sankao/robothector/docs/diagrams/pi-pinout.tex

\documentclass[border=10pt]{standalone}
\usepackage{tikz}
\usepackage{xcolor}
\usetikzlibrary{arrows.meta,positioning,calc,fit,backgrounds}

% --- wire colors (matching real Dupont colors) ---
\definecolor{wireRed}{RGB}{220,40,40}
\definecolor{wireOrange}{RGB}{240,140,0}
\definecolor{wireYellow}{RGB}{220,190,0}
\definecolor{wireGreen}{RGB}{50,160,60}
\definecolor{wireBlue}{RGB}{40,90,210}
\definecolor{wirePurple}{RGB}{140,50,180}
\definecolor{wireBrown}{RGB}{120,75,40}
\definecolor{wireWhite}{RGB}{220,220,220}
\definecolor{wireGray}{RGB}{130,130,130}
\definecolor{wireBlack}{RGB}{30,30,30}

\begin{document}
\begin{tikzpicture}[
    font=\sffamily,
    pin/.style={draw, thick, circle, minimum size=11mm, inner sep=0pt, fill=white,
                font=\sffamily\normalsize\bfseries},
    pinUsed/.style={pin, fill=cyan!30},
    pinPlanned/.style={pin, fill=orange!40},
    pinPower/.style={pin, fill=red!25},
    pinGnd/.style={pin, fill=black!70, text=white},
    pinFree/.style={pin, fill=white},
    pinConflict/.style={pin, fill=red!50, draw=red!75!black, line width=0.6mm},
    fnL/.style={anchor=east, font=\sffamily\small},
    fnR/.style={anchor=west, font=\sffamily\small},
    callout/.style={anchor=west, font=\sffamily\footnotesize, inner sep=2pt},
  ]

  %================================================================
  % 40-pin header — two columns, 20 rows, BIG enough to read
  %================================================================
  \def\rowstep{10mm}
  \def\colgap{18mm}

  % Pin definitions: row, leftStyle, leftFn, leftPinNum, rightStyle, rightFn, rightPinNum
  \foreach \r/\lstyle/\lfn/\lpin/\rstyle/\rfn/\rpin in {%
     1/pinPower/3.3V/1     /pinPower/5V/2,
     2/pinFree/GPIO 2 (SDA)/3 /pinPower/5V/4,
     3/pinFree/GPIO 3 (SCL)/5 /pinGnd/GND/6,
     4/pinFree/GPIO 4/7   /pinFree/GPIO 14 (TX)/8,
     5/pinGnd/GND/9       /pinFree/GPIO 15 (RX)/10,
     6/pinFree/GPIO 17/11 /pinPlanned/GPIO 18/12,
     7/pinFree/GPIO 27/13 /pinGnd/GND/14,
     8/pinFree/GPIO 22/15 /pinFree/GPIO 23/16,
     9/pinPower/3.3V/17   /pinFree/GPIO 24/18,
    10/pinFree/GPIO 10/19 /pinGnd/GND/20,
    11/pinFree/GPIO 9/21  /pinFree/GPIO 25/22,
    12/pinFree/GPIO 11/23 /pinFree/GPIO 8/24,
    13/pinGnd/GND/25      /pinFree/GPIO 7/26,
    14/pinFree/GPIO 0/27  /pinFree/GPIO 1/28,
    15/pinFree/GPIO 5/29  /pinGnd/GND/30,
    16/pinUsed/GPIO 6/31  /pinFree/GPIO 12/32,
    17/pinUsed/GPIO 13/33 /pinGnd/GND/34,
    18/pinConflict/GPIO 19/35 /pinFree/GPIO 16/36,
    19/pinUsed/GPIO 26/37 /pinPlanned/GPIO 20/38,
    20/pinGnd/GND/39      /pinPlanned/GPIO 21/40%
  }{%
     \node[\lstyle] (Lp\r) at (0, -\r*\rowstep) {\lpin};
     \node[fnL] at ([xshift=-6mm]Lp\r.west) {\lfn};
     \node[\rstyle] (Rp\r) at (\colgap, -\r*\rowstep) {\rpin};
     \node[fnR] at ([xshift=6mm]Rp\r.east) {\rfn};
  }

  % header outline — frame tight to pins, labels stay outside it
  \node[draw=green!50!black, semithick, rounded corners=1pt, fit=(Lp1)(Rp20),
        inner sep=2mm, fill=green!3, on background layer] (header) {};

  \node[font=\sffamily\bfseries\large, above=3mm of header.north]
        {Raspberry Pi 40-pin GPIO header (top-down view)};

  %================================================================
  % CALLOUTS — wire colour for each used / planned pin
  % Place them with breathing room
  %================================================================
  \def\leftPad{38mm}
  \def\rightPad{38mm}

  % --- LEFT column callouts ---
  % pin 1 — 3V3 → mic VDD
  \node[callout, anchor=east] at ([xshift=-\leftPad]Lp1.west)
        (cVDD) {to \textbf{INMP441 VDD} \quad
                \textcolor{wireRed}{\rule{6mm}{3mm}} \textbf{red}};
  \draw[-{Stealth[length=2mm]}, thick, gray] (cVDD.east) -- (Lp1.west);

  % pin 31 GPIO6 IN4
  \node[callout, anchor=east] at ([xshift=-\leftPad]Lp16.west)
        (cIN4) {\textbf{IN4 motor} \quad
                \textcolor{wireGray}{\rule{6mm}{3mm}} \textbf{gray}};
  \draw[-{Stealth[length=2mm]}, thick, gray] (cIN4.east) -- (Lp16.west);

  % pin 33 GPIO13 IN3
  \node[callout, anchor=east] at ([xshift=-\leftPad]Lp17.west)
        (cIN3) {\textbf{IN3 motor} \quad
                \fcolorbox{black!40}{wireWhite}{\rule{6mm}{3mm}} \textbf{white}};
  \draw[-{Stealth[length=2mm]}, thick, gray] (cIN3.east) -- (Lp17.west);

  % pin 35 GPIO19 — IN2 now / LRCLK planned (CONFLICT)
  \node[callout, anchor=east, draw=red!60, dashed, rounded corners,
        fill=red!5, inner sep=4pt, align=left]
        at ([xshift=-\leftPad]Lp18.west)
        (cIN2) {\textbf{IN2 motor} {\footnotesize(now)} \,/\,
                \textbf{I2S LRCLK} {\footnotesize(planned)}\\[1pt]
                \textcolor{wireBlack}{\rule{6mm}{3mm}} \textbf{black} (motor) $\rightarrow$
                \textcolor{wireGreen}{\rule{6mm}{3mm}} \textbf{green} (after rewire)};
  \draw[-{Stealth[length=2mm]}, thick, red!75!black]
        (cIN2.east) -- (Lp18.west);

  % pin 37 GPIO26 IN1
  \node[callout, anchor=east] at ([xshift=-\leftPad]Lp19.west)
        (cIN1) {\textbf{IN1 motor} \quad
                \textcolor{wireBrown}{\rule{6mm}{3mm}} \textbf{brown}};
  \draw[-{Stealth[length=2mm]}, thick, gray] (cIN1.east) -- (Lp19.west);

  % --- RIGHT column callouts ---
  % pin 2 — 5V → amp VIN
  \node[callout, anchor=west] at ([xshift=\rightPad]Rp1.east)
        (cVIN) {to \textbf{MAX98357A VIN} \quad
                \textcolor{wireOrange}{\rule{6mm}{3mm}} \textbf{orange}};
  \draw[-{Stealth[length=2mm]}, thick, gray] (Rp1.east) -- (cVIN.west);

  % pin 6 — GND → common rail
  \node[callout, anchor=west, fill=black!8, inner sep=3pt]
        at ([xshift=\rightPad]Rp3.east)
        (cGND) {\textbf{GND} (any pin) — common rail
                to L298N + mic + amp \quad
                \textcolor{wireBlack}{\rule{6mm}{3mm}} \textbf{black}};
  \draw[-{Stealth[length=2mm]}, thick, gray] (Rp3.east) -- (cGND.west);

  % pin 12 GPIO 18 — I2S BCLK shared
  \node[callout, anchor=west] at ([xshift=\rightPad]Rp6.east)
        (cBCLK) {\textbf{I2S BCLK} (shared mic + amp) \quad
                 \textcolor{wireYellow}{\rule{6mm}{3mm}} \textbf{yellow}};
  \draw[-{Stealth[length=2mm]}, thick, gray] (Rp6.east) -- (cBCLK.west);

  % pin 11 GPIO 17 — future IN2 home (after the rewire) — left column row 6
  \node[callout, anchor=east, draw=red!50, dashed, rounded corners,
        fill=red!5, inner sep=3pt]
        at ([xshift=-\leftPad,yshift=4mm]Lp6.west)
        (cIN2new) {\textbf{future IN2 motor} (after rewire) \quad
                   \textcolor{wireBlack}{\rule{6mm}{3mm}} \textbf{black}};
  \draw[-{Stealth[length=2mm]}, thick, red!75!black]
        (cIN2new.east) -- (Lp6.west);

  % pin 38 GPIO 20 — I2S SD (mic data → Pi)
  \node[callout, anchor=west] at ([xshift=\rightPad]Rp19.east)
        (cDIN) {\textbf{I2S SD} (mic data $\rightarrow$ Pi) \quad
                \textcolor{wireBlue}{\rule{6mm}{3mm}} \textbf{blue}};
  \draw[-{Stealth[length=2mm]}, thick, gray] (Rp19.east) -- (cDIN.west);

  % pin 40 GPIO 21 — I2S DIN (Pi → amp)
  \node[callout, anchor=west] at ([xshift=\rightPad]Rp20.east)
        (cDOUT) {\textbf{I2S DIN} (Pi $\rightarrow$ amp) \quad
                \textcolor{wirePurple}{\rule{6mm}{3mm}} \textbf{purple}};
  \draw[-{Stealth[length=2mm]}, thick, gray] (Rp20.east) -- (cDOUT.west);

  %================================================================
  % LEGEND for pin colour codes
  %================================================================
  \node[draw, rounded corners, fill=white, inner sep=6pt,
        anchor=north west, align=left, font=\sffamily\footnotesize]
        at ([xshift=-30mm,yshift=-15mm]header.south west)
        (legend) {%
    \textbf{Pin status (header colour)}\\[3pt]
    \tikz{\node[pinUsed,minimum size=5mm]{}; }\ \ currently used (motor IN1--IN4)\\[2pt]
    \tikz{\node[pinPlanned,minimum size=5mm]{}; }\ \ planned for Phase 4 audio\\[2pt]
    \tikz{\node[pinConflict,minimum size=5mm]{}; }\ \ conflict pin (must rewire IN2)\\[2pt]
    \tikz{\node[pinPower,minimum size=5mm]{}; }\ \ power rail (3.3V or 5V)\\[2pt]
    \tikz{\node[pinGnd,minimum size=5mm]{}; }\ \ ground\\[2pt]
    \tikz{\node[pinFree,minimum size=5mm]{}; }\ \ unused / available};

  %================================================================
  % WIRE COLOUR TABLE
  %================================================================
  \node[draw, rounded corners, fill=white, inner sep=6pt,
        anchor=north west, align=left, font=\sffamily\footnotesize,
        right=8mm of legend]
        (wires) {%
    \textbf{Recommended Dupont wire colours}\\[3pt]
    \begin{tabular}{@{}p{6mm}@{\ \ }l@{}}
      \textcolor{wireRed}{\rule{6mm}{3mm}}      & \textbf{red}    --- 3.3V (mic VDD)\\
      \textcolor{wireOrange}{\rule{6mm}{3mm}}   & \textbf{orange} --- 5V (amp VIN)\\
      \textcolor{wireBlack}{\rule{6mm}{3mm}}    & \textbf{black}  --- GND (any pin)\\
      \textcolor{wireYellow}{\rule{6mm}{3mm}}   & \textbf{yellow} --- I2S BCLK (shared)\\
      \textcolor{wireGreen}{\rule{6mm}{3mm}}    & \textbf{green}  --- I2S LRCLK (shared)\\
      \textcolor{wireBlue}{\rule{6mm}{3mm}}     & \textbf{blue}   --- I2S SD (mic data)\\
      \textcolor{wirePurple}{\rule{6mm}{3mm}}   & \textbf{purple} --- I2S DIN (amp data)\\[2pt]
      \textcolor{wireBrown}{\rule{6mm}{3mm}}    & \textbf{brown}  --- IN1 motor (Pi p37)\\
      \textcolor{wireBlack}{\rule{6mm}{3mm}}    & \textbf{black}  --- IN2 motor (Pi p35)$^*$\\
      \fcolorbox{black!40}{wireWhite}{\rule{6mm}{3mm}} & \textbf{white}  --- IN3 motor (Pi p33)\\
      \textcolor{wireGray}{\rule{6mm}{3mm}}     & \textbf{gray}   --- IN4 motor (Pi p31)\\
    \end{tabular}\\[3pt]
    \footnotesize $^*$IN2 wire moves to Pi pin 11 (GPIO 17)\\
    \footnotesize\quad when audio is added (frees GPIO 19 for LRCLK).\\
    \footnotesize\quad NOT GPIO 16: claimed by I2S overlay for amp SD\_MODE.};

  %================================================================
  % CONNECTION MAP
  %================================================================
  \node[draw, rounded corners, fill=white, inner sep=6pt,
        anchor=north west, align=left, font=\sffamily\footnotesize,
        right=8mm of wires]
        (conns) {%
    \textbf{Pi-pin $\rightarrow$ destination map}\\[3pt]
    \begin{tabular}{@{}p{12mm}@{\ \ }p{20mm}@{\ \ }l@{}}
      \textbf{Pi pin} & \textbf{Function}    & \textbf{Goes to}\\
      \hline
      1   & 3.3V         & INMP441 VDD\\
      2   & 5V           & MAX98357A VIN\\
      6, 9, 14, 20\dots & GND  & L298N + mic + amp + spk\\
      11  & GPIO 17$^*$  & L298N IN2 (after rewire)\\
      12  & GPIO 18      & mic SCK + amp BCLK\\
      31  & GPIO 6       & L298N IN4\\
      33  & GPIO 13      & L298N IN3\\
      35  & GPIO 19$^*$  & mic WS + amp LRC\\
      37  & GPIO 26      & L298N IN1\\
      38  & GPIO 20      & INMP441 SD\\
      40  & GPIO 21      & MAX98357A DIN\\
    \end{tabular}\\[3pt]
    \footnotesize $^*$ rewire: free GPIO 19 by moving IN2 to GPIO 17 (Pi pin 11) ---\\
    \footnotesize\quad GPIO 16 is unavailable (claimed by I2S overlay for amp SD\_MODE).};

  %================================================================
  % TITLE
  %================================================================
  \node[font=\sffamily\Large\bfseries, above=14mm of header.north, align=center]
        {robothector --- Raspberry Pi GPIO header \& wire-colour reference};

\end{tikzpicture}
\end{document}
