sankao/robothector/cad/preview/cabin/body/front.png

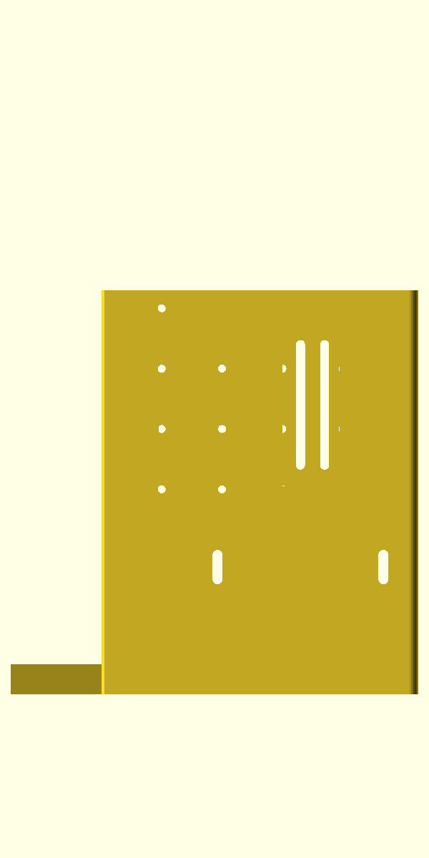
cad/preview/cabin/body/front.png
