sankao/robothector/cad/preview/cabin/body/iso.png

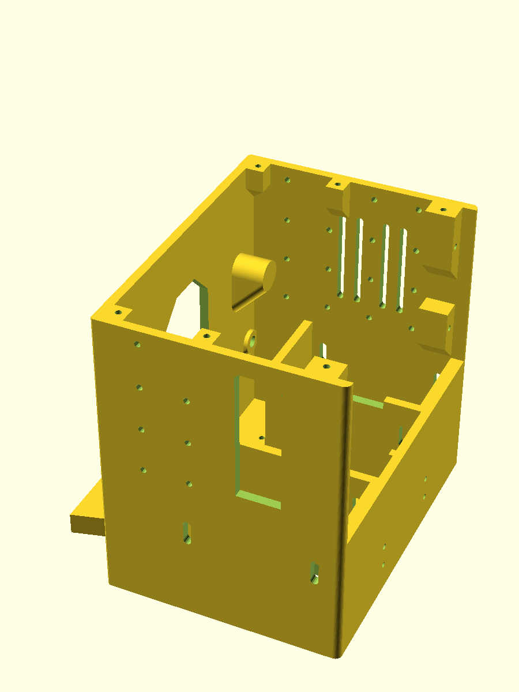
cad/preview/cabin/body/iso.png
