sankao/robothector/cad/preview/cabin/body/side.png

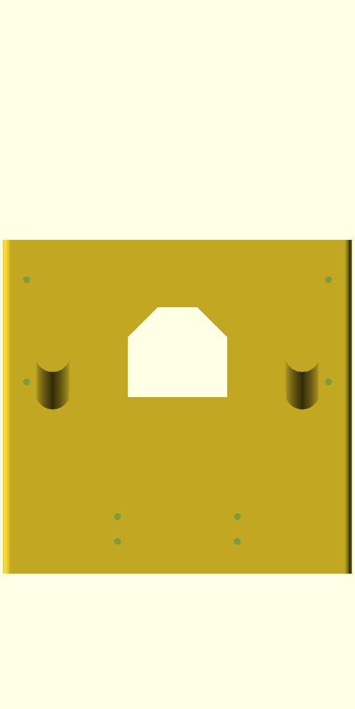
cad/preview/cabin/body/side.png
