sankao/robothector/cad/preview/cabin/body/top.png

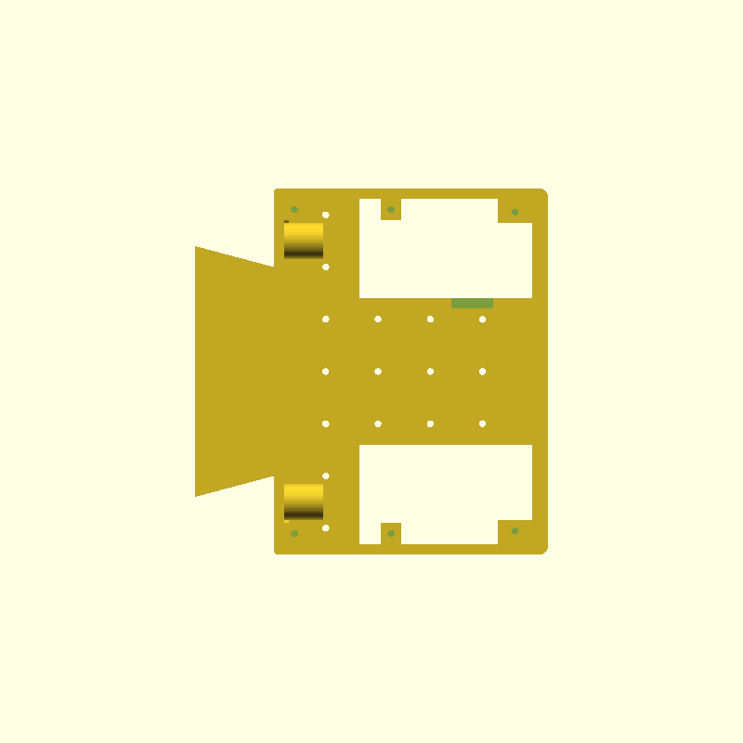
cad/preview/cabin/body/top.png
