sankao/robothector/cad/preview/cabin/bumper/front.png

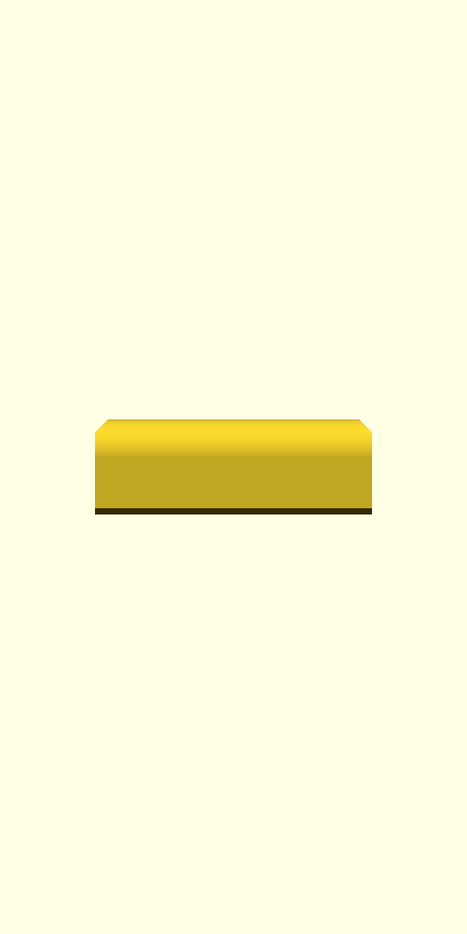
cad/preview/cabin/bumper/front.png
