sankao/robothector/cad/preview/cabin/bumper/iso.png

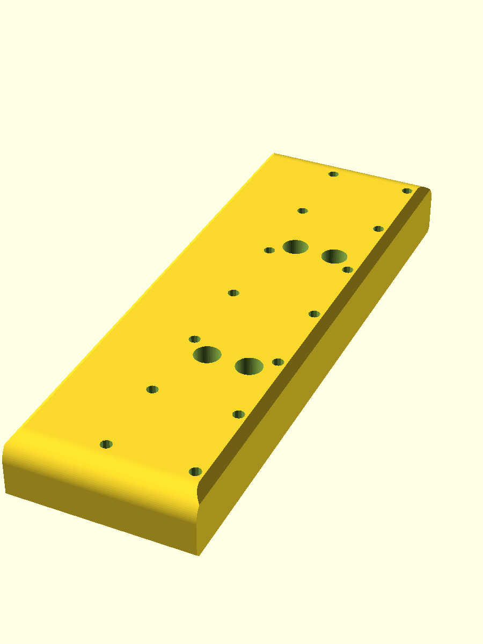
cad/preview/cabin/bumper/iso.png
