sankao/robothector/cad/preview/cabin/bumper/side.png

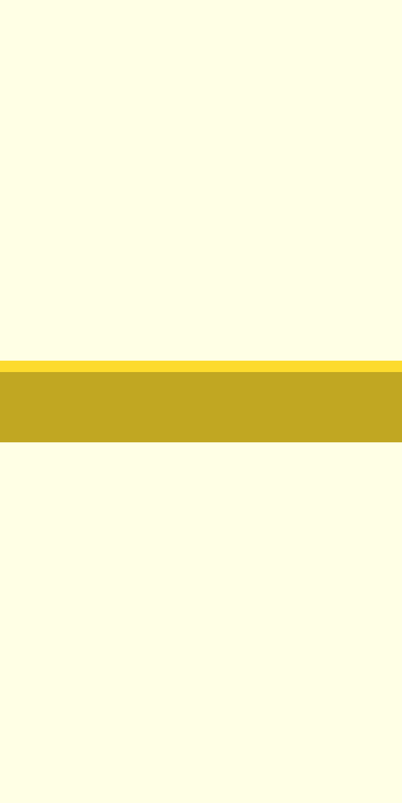
cad/preview/cabin/bumper/side.png
