sankao/robothector/cad/preview/cabin/bumper/top.png

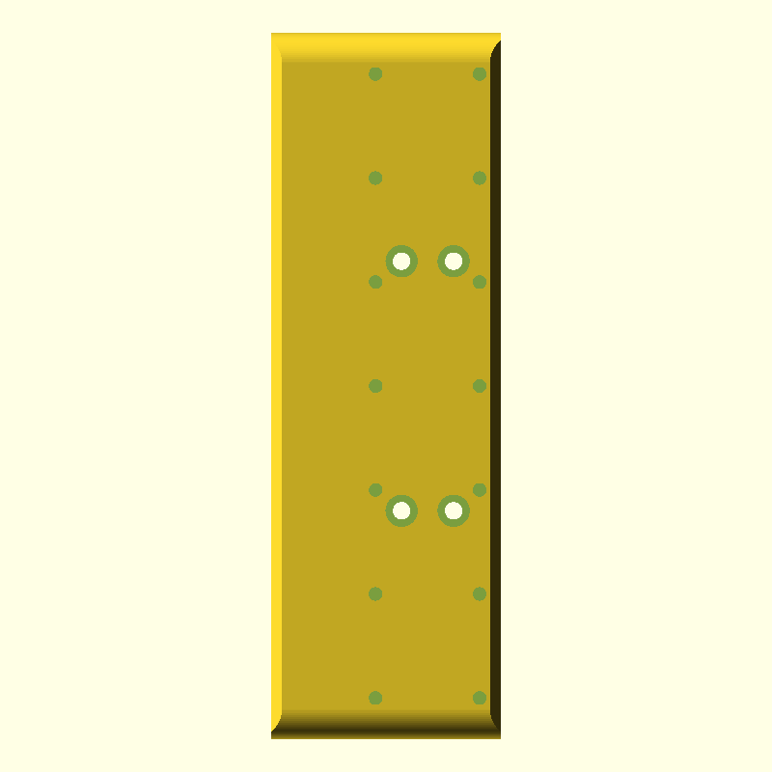
cad/preview/cabin/bumper/top.png
