sankao/robothector/cad/preview/cabin/camera_bracket/front.png

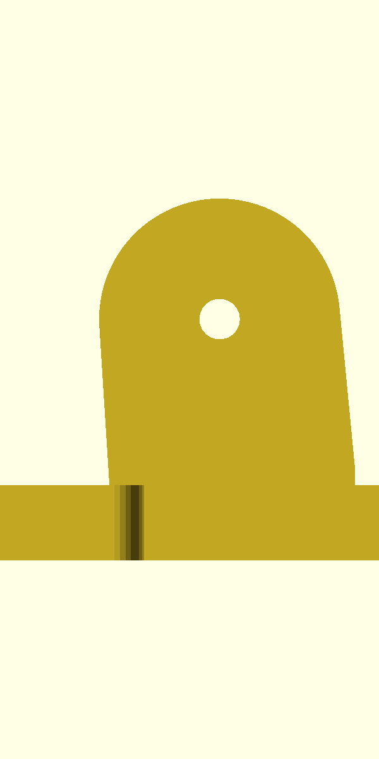
cad/preview/cabin/camera_bracket/front.png
