sankao/robothector/cad/preview/cabin/camera_bracket/iso.png

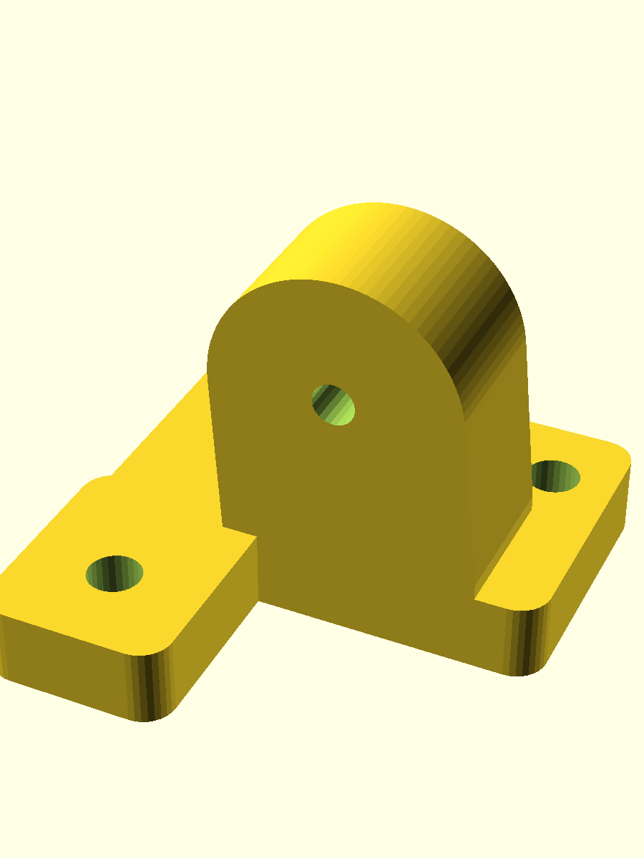
cad/preview/cabin/camera_bracket/iso.png
