sankao/robothector/cad/preview/cabin/camera_bracket/side.png

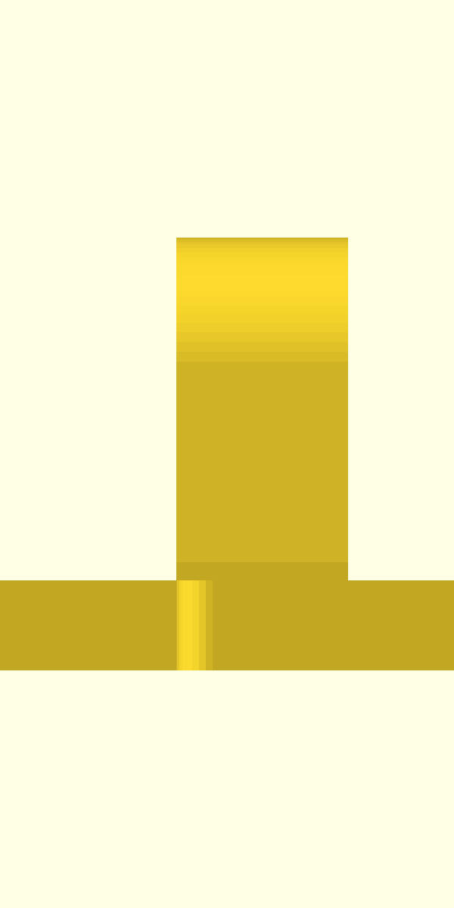
cad/preview/cabin/camera_bracket/side.png
