sankao/robothector/cad/preview/cabin/camera_bracket/top.png

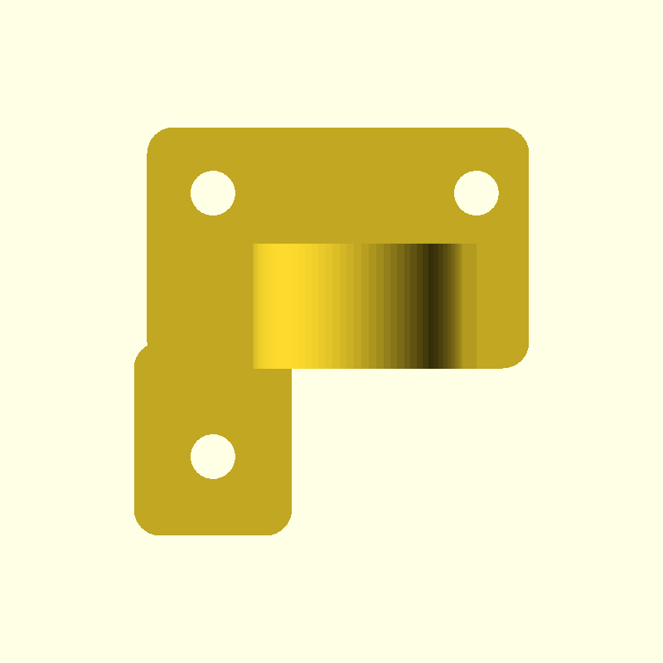
cad/preview/cabin/camera_bracket/top.png
