sankao/robothector/cad/preview/cabin/camera_clip/front.png

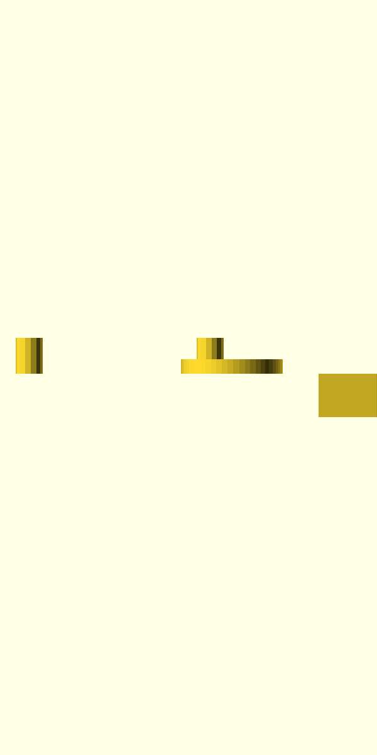
cad/preview/cabin/camera_clip/front.png
