sankao/robothector/cad/preview/cabin/camera_clip/iso.png

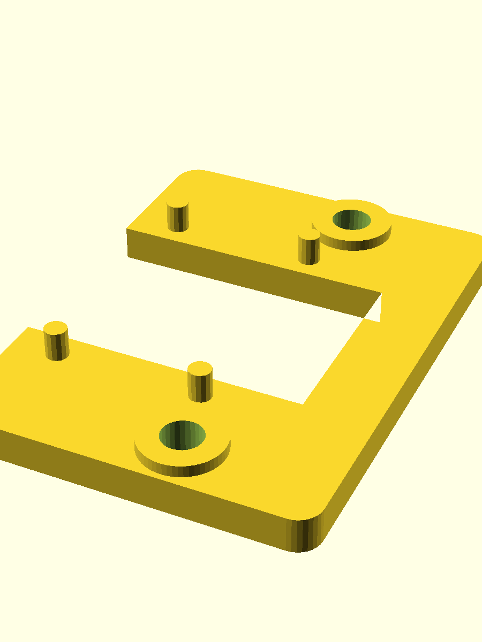
cad/preview/cabin/camera_clip/iso.png
