sankao/robothector/cad/preview/cabin/camera_clip/top.png

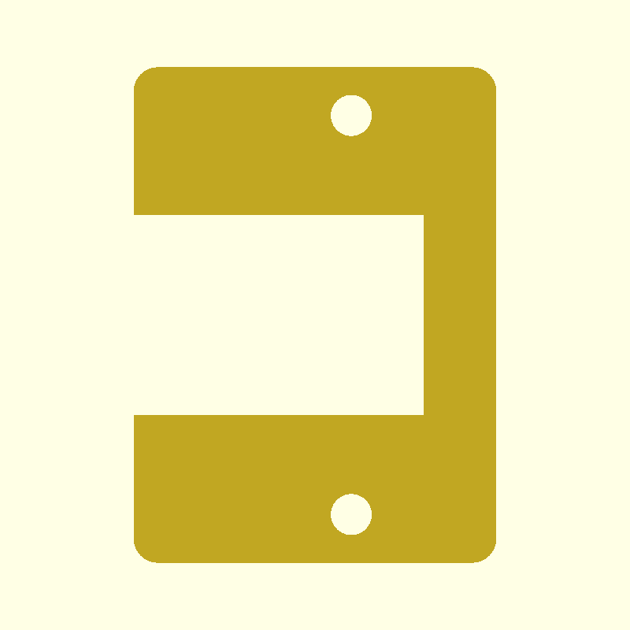
cad/preview/cabin/camera_clip/top.png
