sankao/robothector/cad/preview/cabin/camera_cradle/front.png

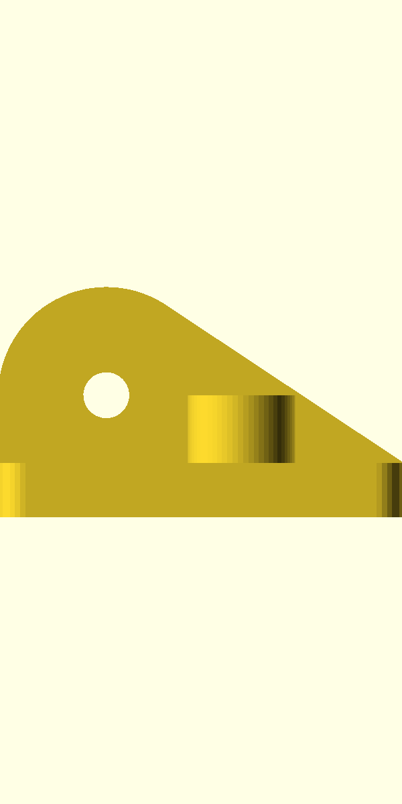
cad/preview/cabin/camera_cradle/front.png
