sankao/robothector/cad/preview/cabin/camera_cradle/iso.png

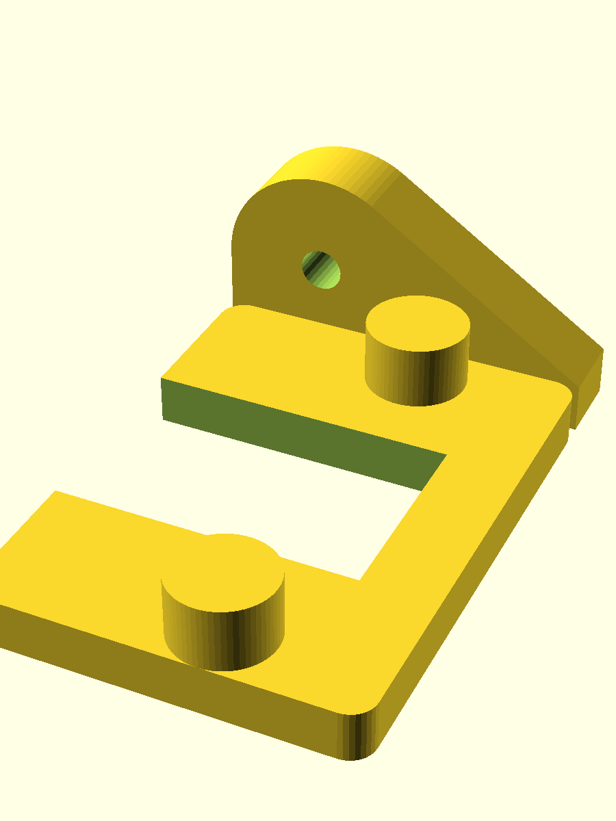
cad/preview/cabin/camera_cradle/iso.png
