sankao/robothector/cad/preview/cabin/camera_cradle/top.png

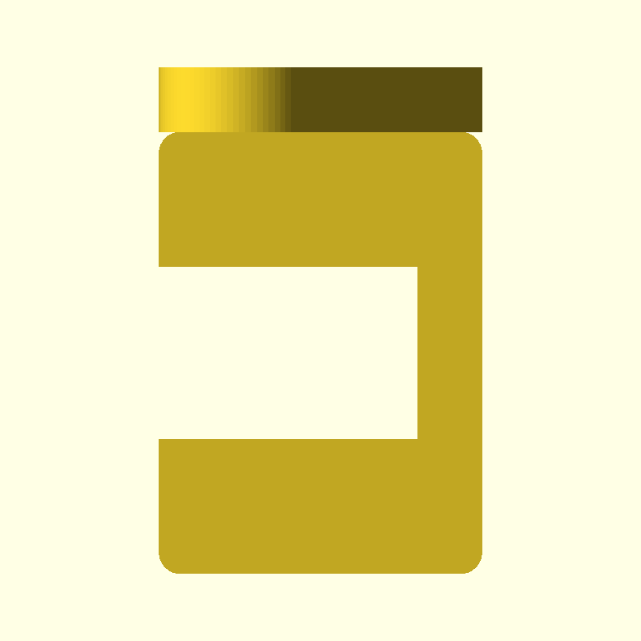
cad/preview/cabin/camera_cradle/top.png
