sankao/robothector/cad/preview/cabin/faceplate_v2/back.png

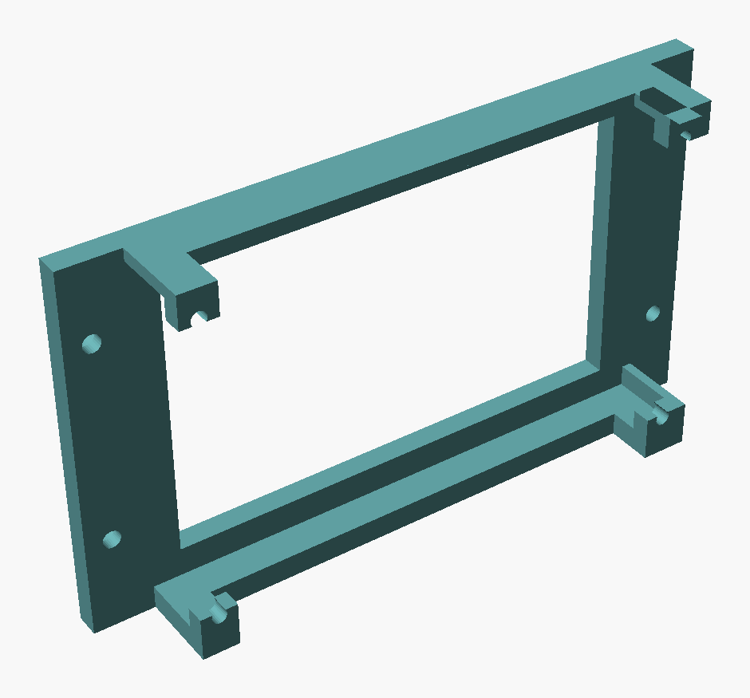
cad/preview/cabin/faceplate_v2/back.png
