sankao/robothector/cad/preview/cabin/faceplate_v2/with_screen.png

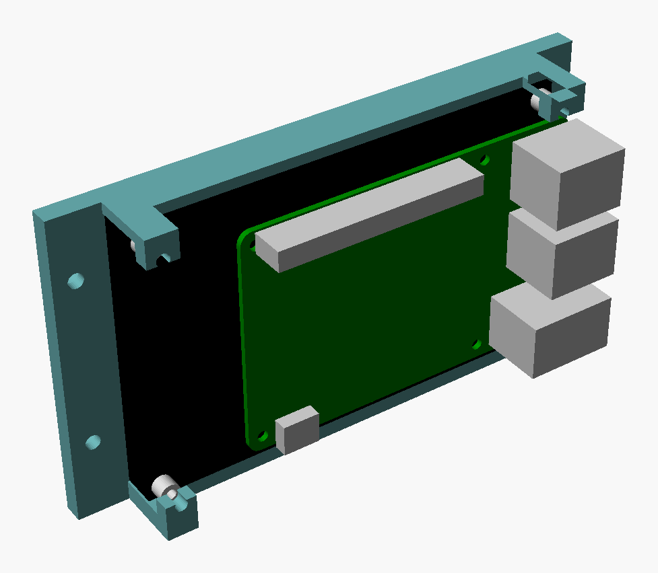
cad/preview/cabin/faceplate_v2/with_screen.png
