sankao/robothector/cad/preview/cabin/omni_cassette/front.png

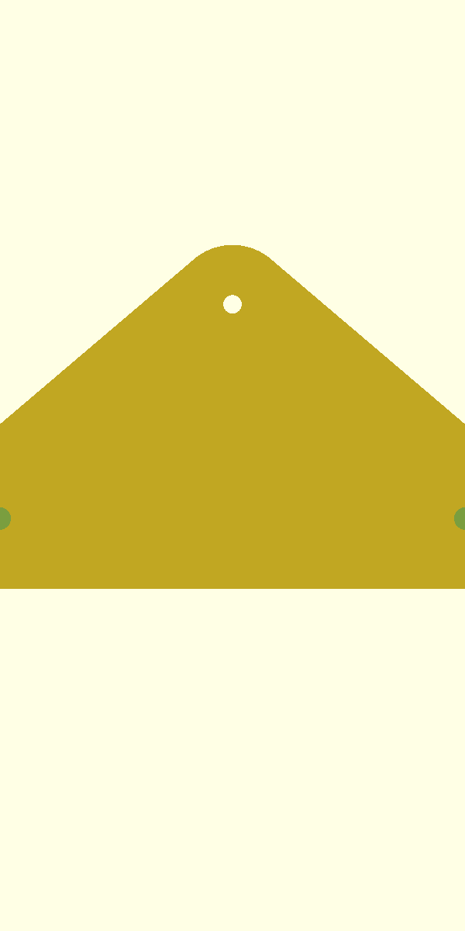
cad/preview/cabin/omni_cassette/front.png
