sankao/robothector/cad/preview/cabin/omni_cassette/iso.png

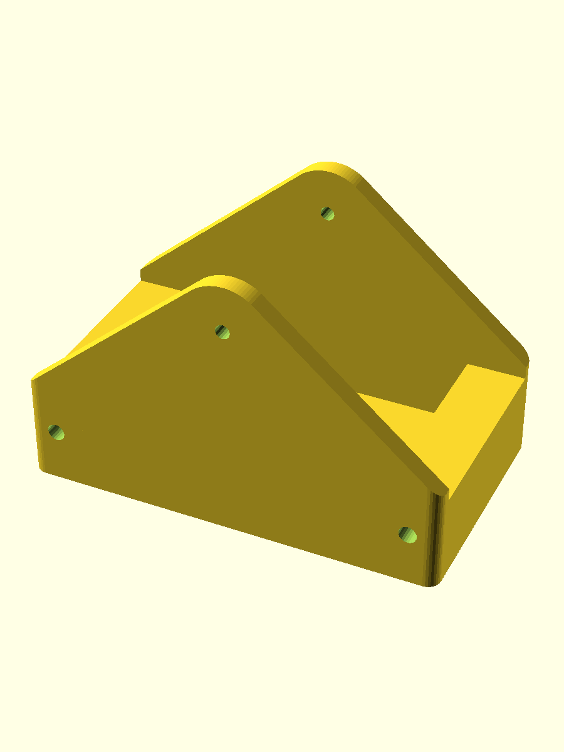
cad/preview/cabin/omni_cassette/iso.png
