sankao/robothector/cad/preview/cabin/omni_cassette/side.png

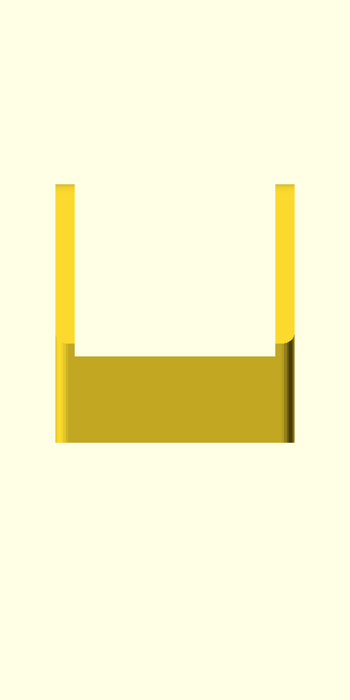
cad/preview/cabin/omni_cassette/side.png
