sankao/robothector/cad/preview/cabin/omni_cassette/top.png

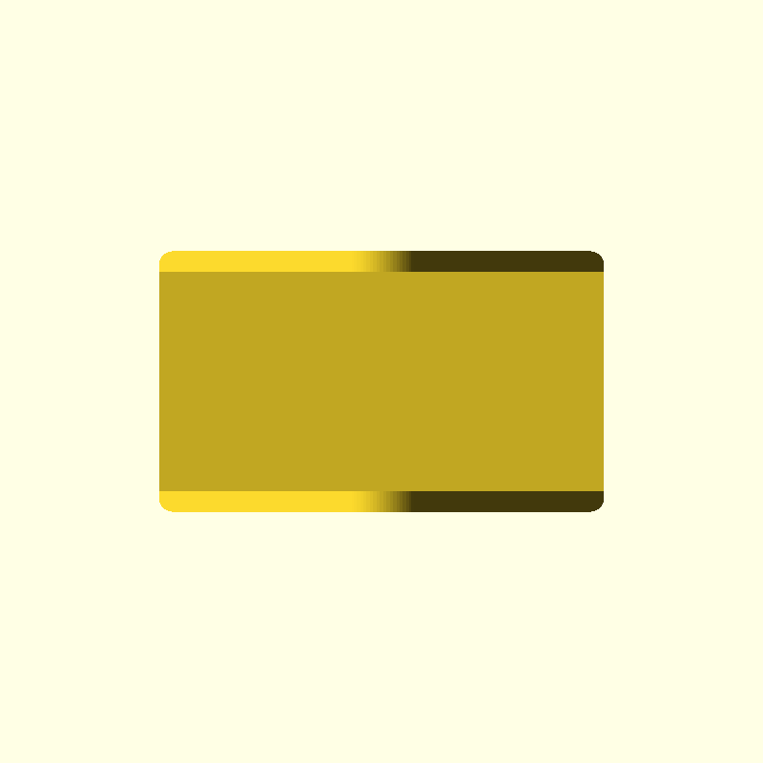
cad/preview/cabin/omni_cassette/top.png
