sankao/robothector/cad/preview/cabin/roof/iso.png

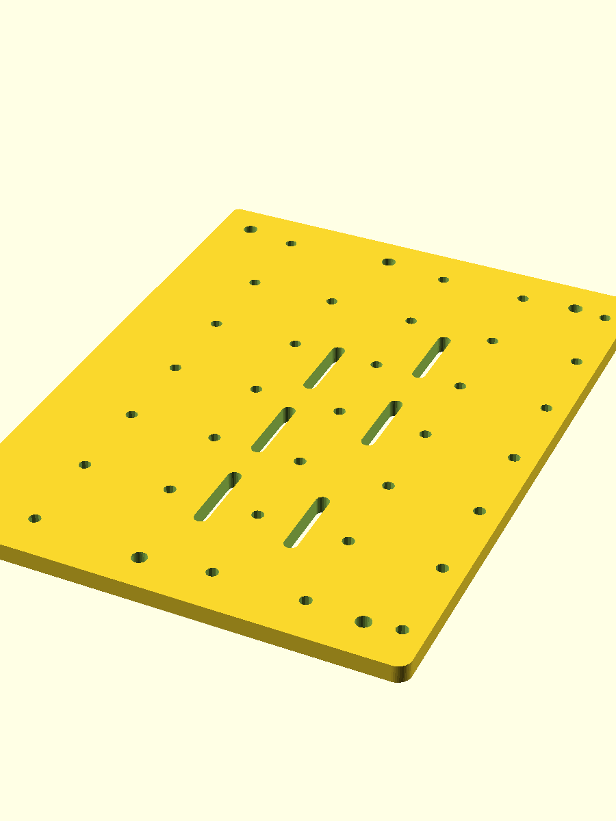
cad/preview/cabin/roof/iso.png
