sankao/robothector/cad/preview/cabin/roof/top.png

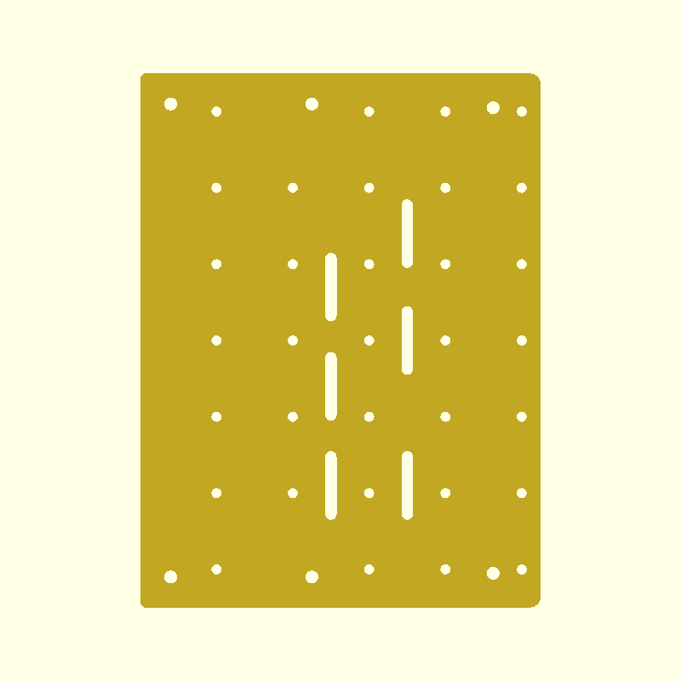
cad/preview/cabin/roof/top.png
