sankao/robothector/cad/preview/cabin/screen_mount/exploded_front.png

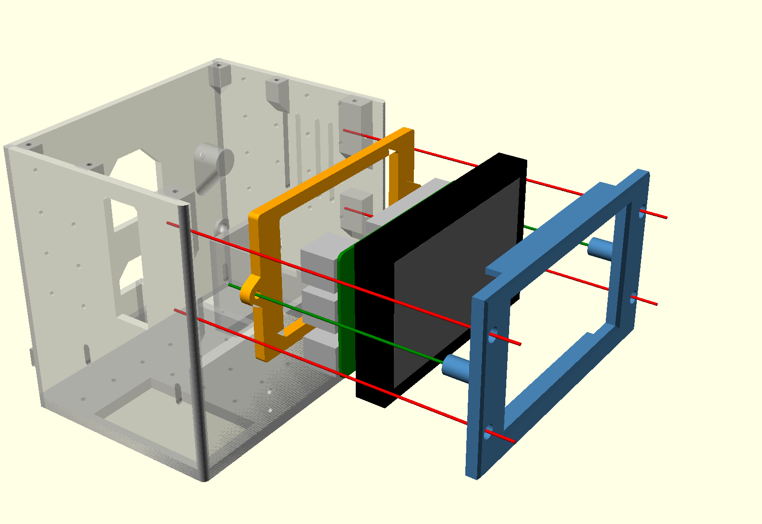
cad/preview/cabin/screen_mount/exploded_front.png
