sankao/robothector/cad/preview/cabin/screen_mount/exploded_rear.png

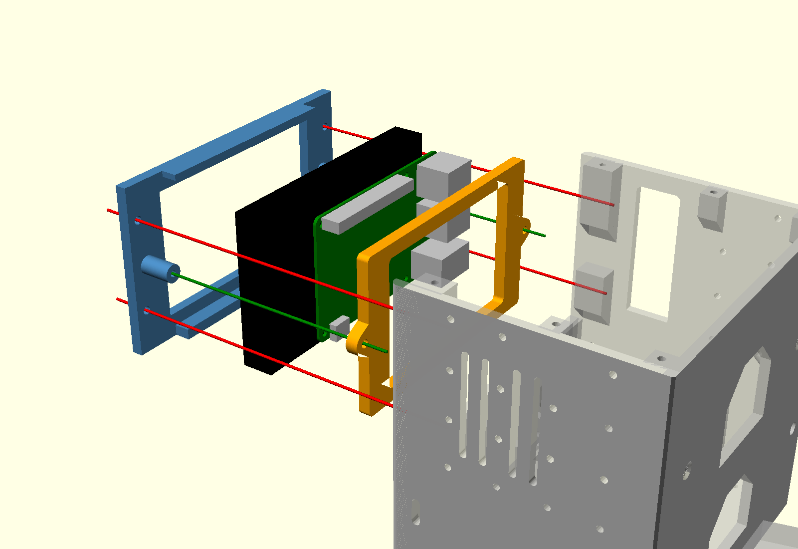
cad/preview/cabin/screen_mount/exploded_rear.png
