sankao/robothector/cad/preview/cabin/screen_retainer/iso.png

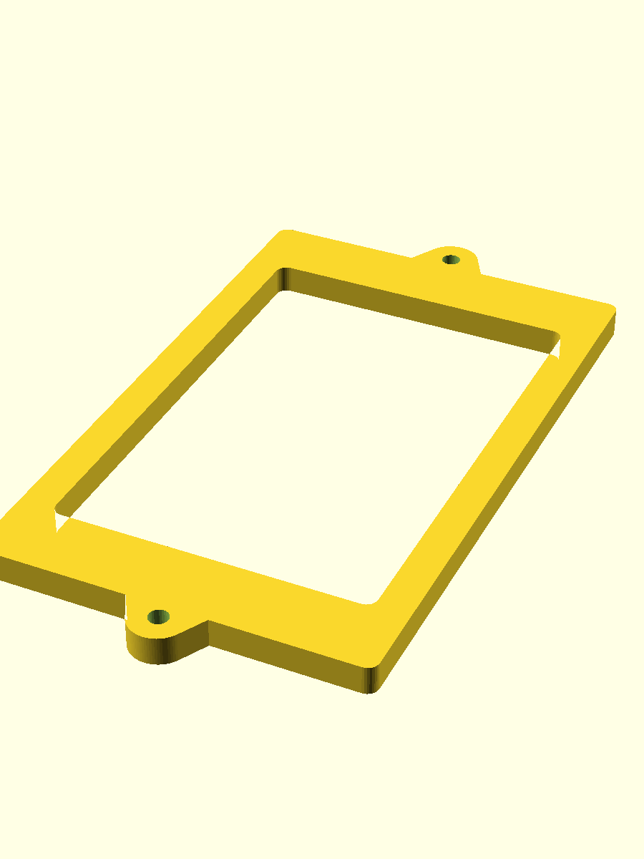
cad/preview/cabin/screen_retainer/iso.png
