sankao/robothector/cad/preview/cabin/screen_retainer/top.png

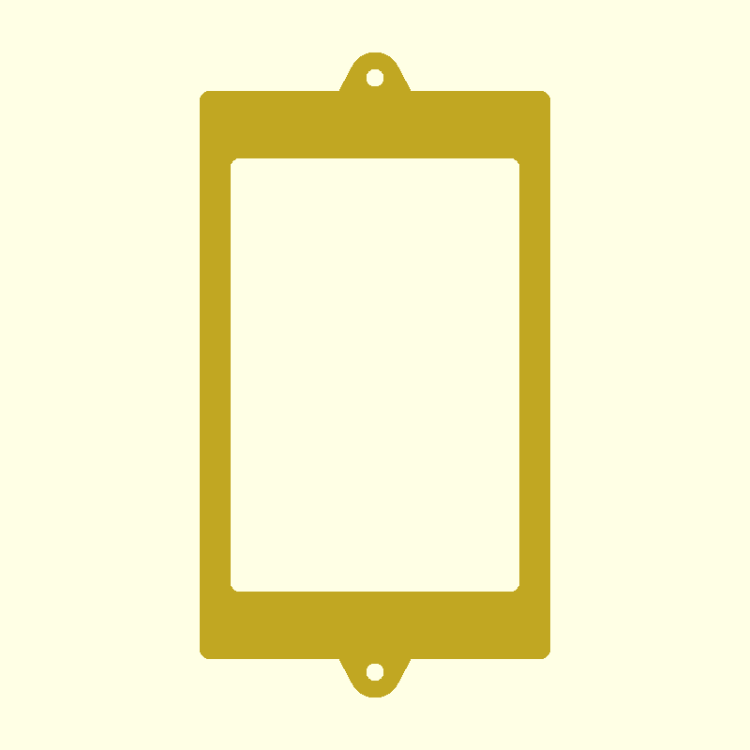
cad/preview/cabin/screen_retainer/top.png
