sankao/robothector/cad/preview/lower_carriage/clamp_motor_detail.png

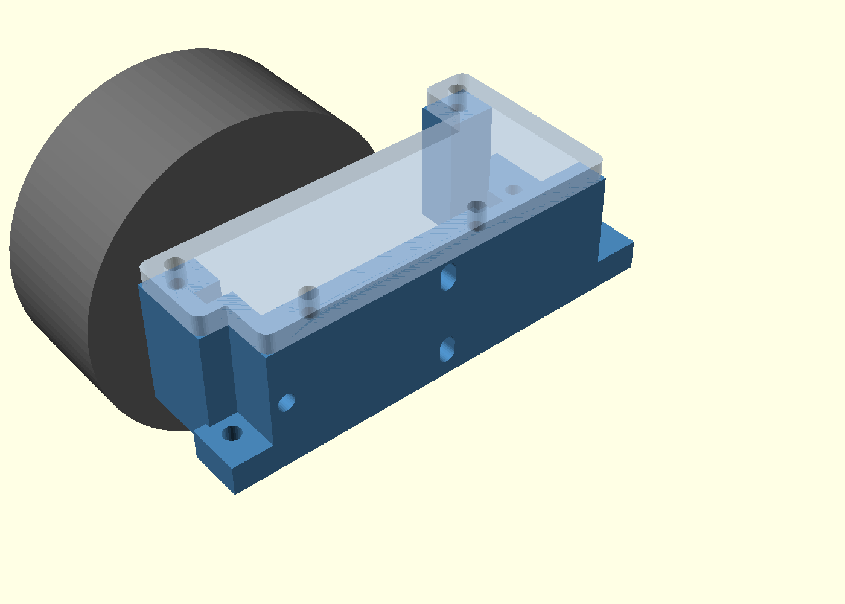
cad/preview/lower_carriage/clamp_motor_detail.png
