sankao/robothector/cad/preview/lower_carriage/frame_front.png

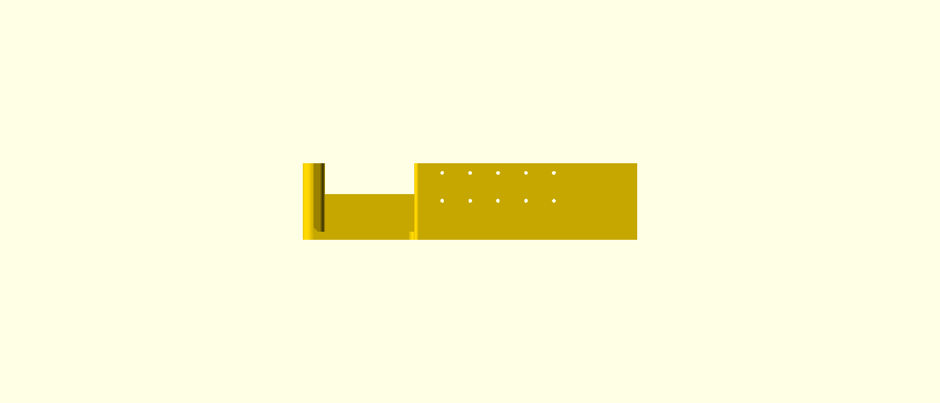
cad/preview/lower_carriage/frame_front.png
