sankao/robothector/cad/preview/lower_carriage/frame_iso.png

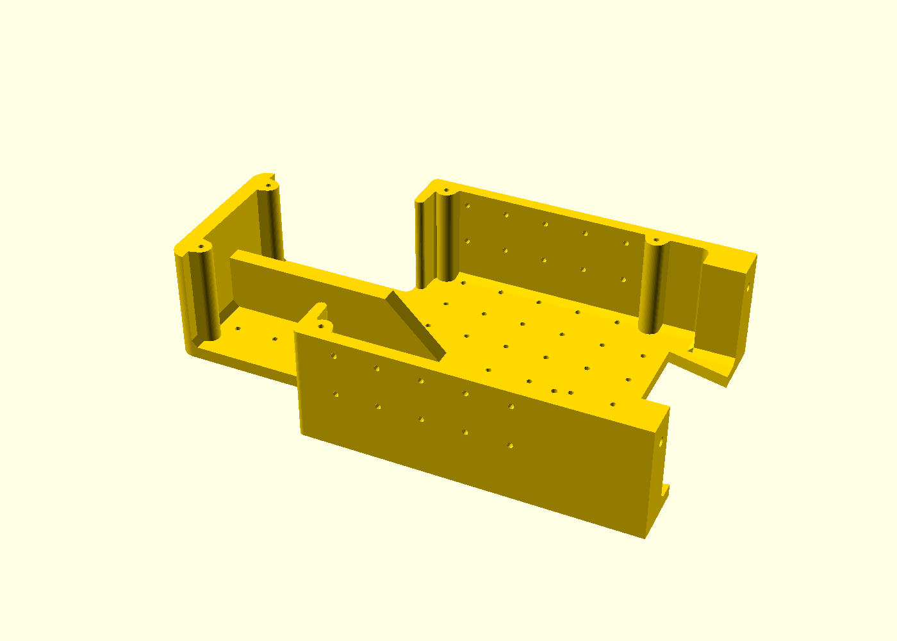
cad/preview/lower_carriage/frame_iso.png
