sankao/robothector/cad/preview/lower_carriage/frame_side.png

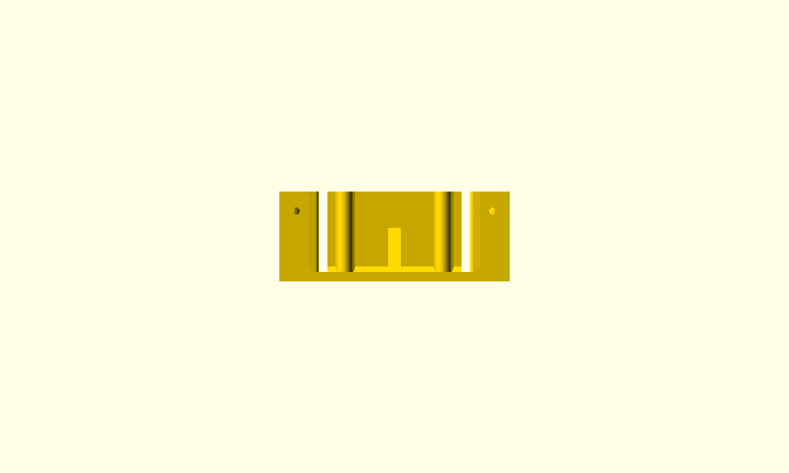
cad/preview/lower_carriage/frame_side.png
