sankao/robothector/cad/preview/lower_carriage/frame_top.png

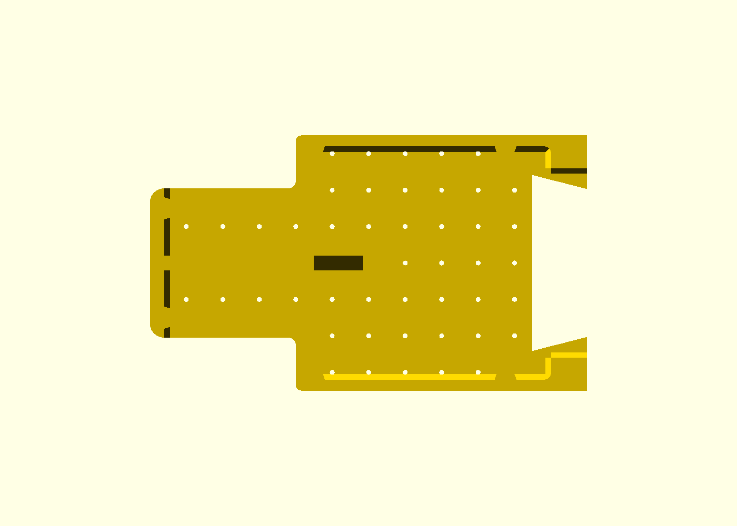
cad/preview/lower_carriage/frame_top.png
