sankao/robothector/cad/preview/lower_carriage/shoulder_detail.png

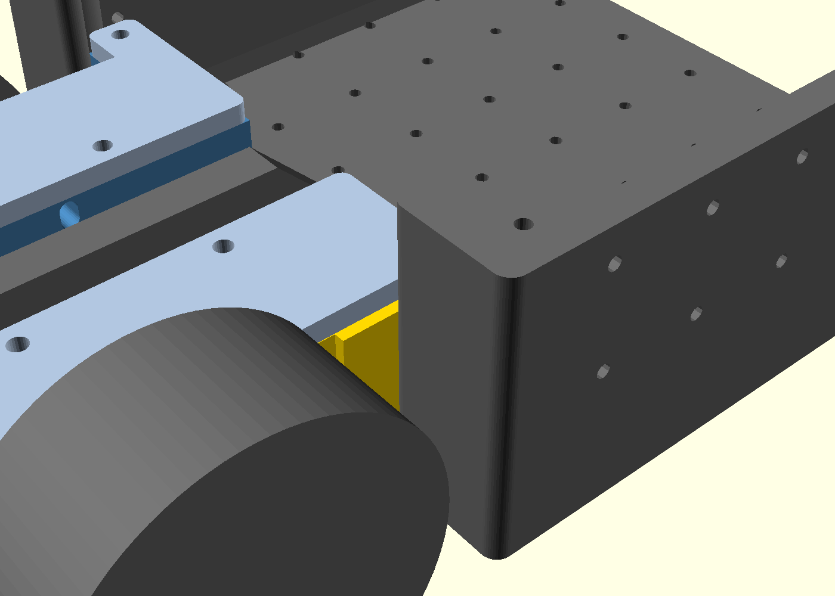
cad/preview/lower_carriage/shoulder_detail.png
