sankao/robothector/cad/preview/lower_carriage/tt_cap_iso.png

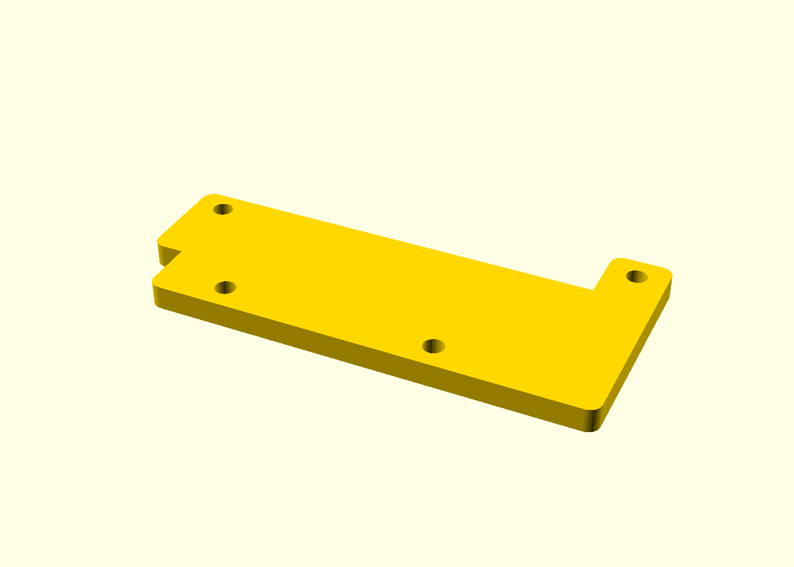
cad/preview/lower_carriage/tt_cap_iso.png
