sankao/robothector/cad/preview/lower_carriage/tt_clamp_iso.png

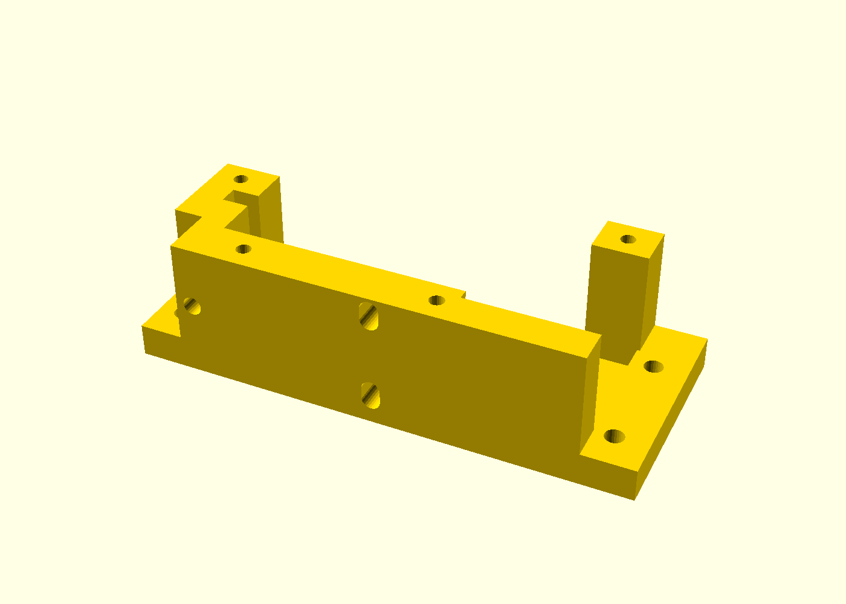
cad/preview/lower_carriage/tt_clamp_iso.png
