sankao/robothector/cad/preview/lower_carriage/tt_shaft_slot/clamp_with_motor.png

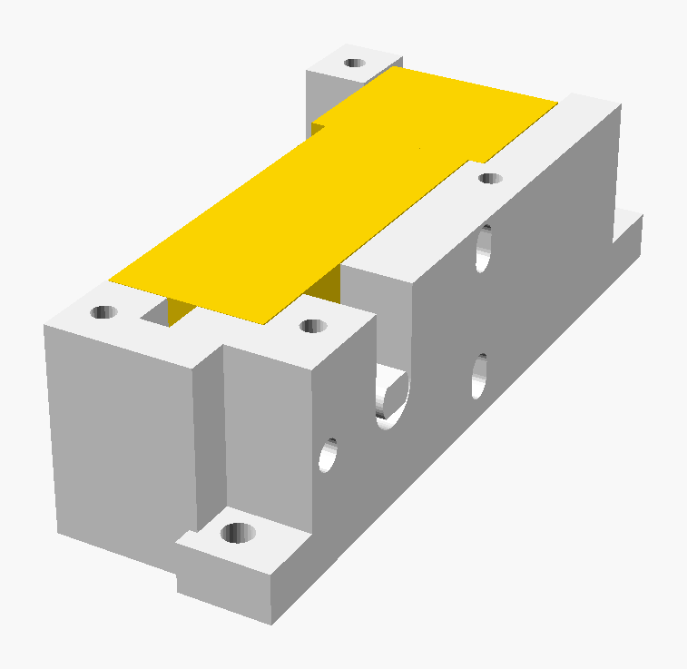
cad/preview/lower_carriage/tt_shaft_slot/clamp_with_motor.png
