sankao/robothector/cad/preview/manual/overview.png

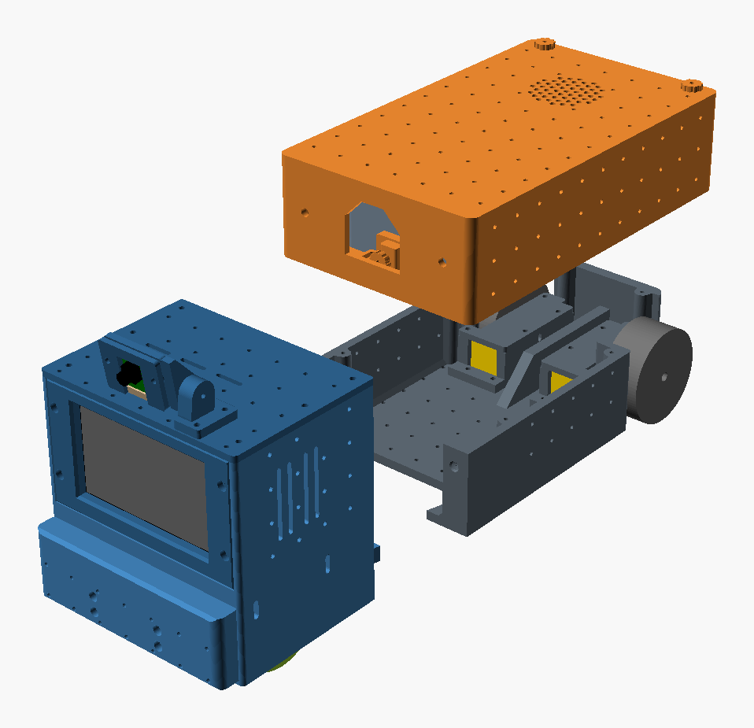
cad/preview/manual/overview.png
