sankao/robothector/cad/preview/rod_jig/base.png

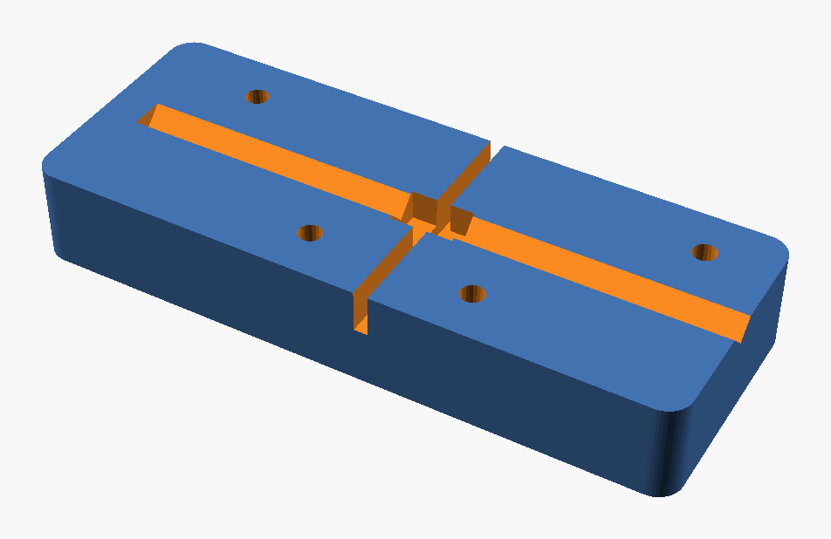
cad/preview/rod_jig/base.png
