sankao/robothector/cad/preview/upper_carriage/clamp_post/front.png

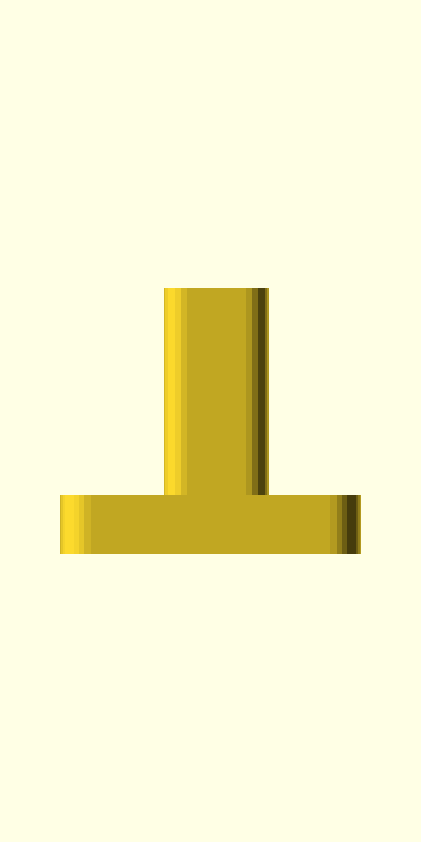
cad/preview/upper_carriage/clamp_post/front.png
