sankao/robothector/cad/preview/upper_carriage/clamp_post/iso.png

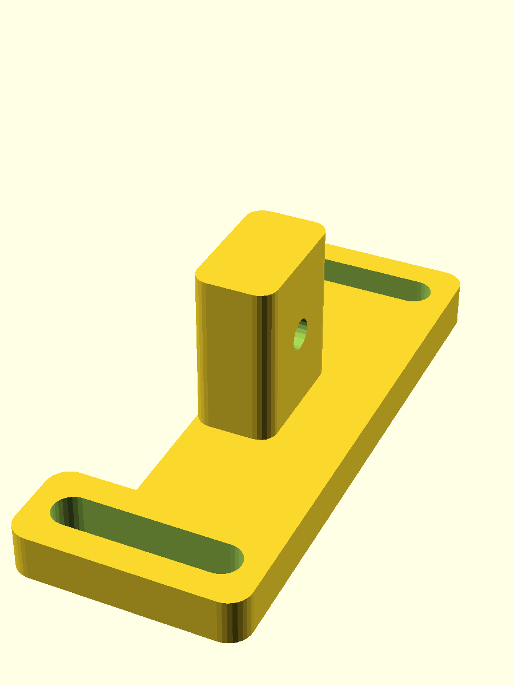
cad/preview/upper_carriage/clamp_post/iso.png
