sankao/robothector/cad/preview/upper_carriage/clamp_post/side.png

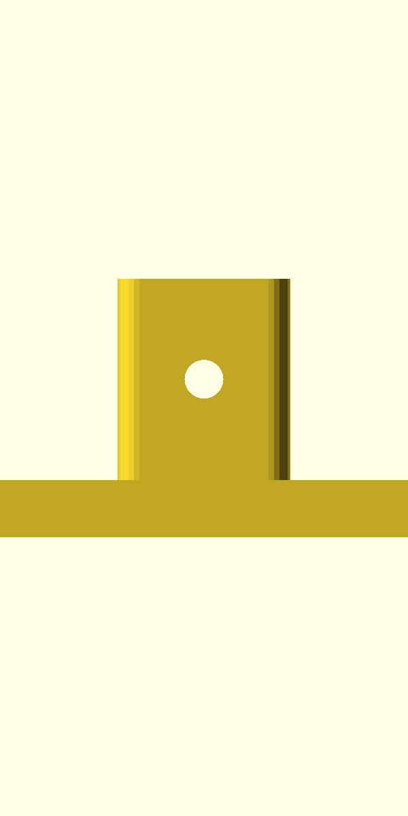
cad/preview/upper_carriage/clamp_post/side.png
