sankao/robothector/cad/preview/upper_carriage/clamp_post/top.png

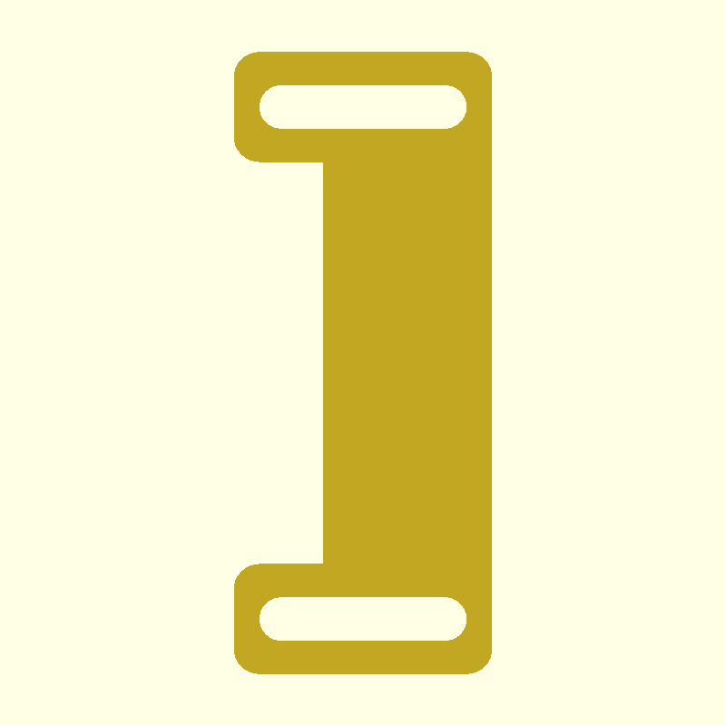
cad/preview/upper_carriage/clamp_post/top.png
