sankao/robothector/cad/preview/upper_carriage/knob/front.png

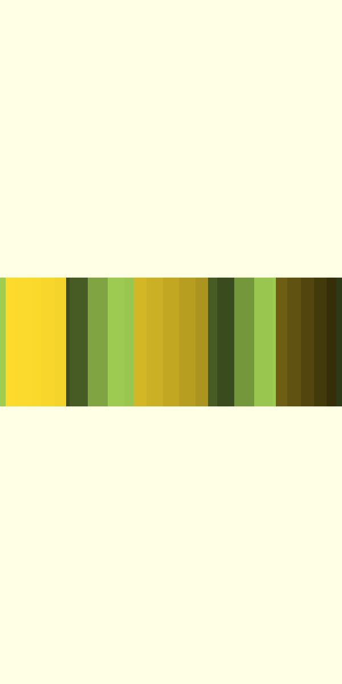
cad/preview/upper_carriage/knob/front.png
