sankao/robothector/cad/preview/upper_carriage/knob/iso.png

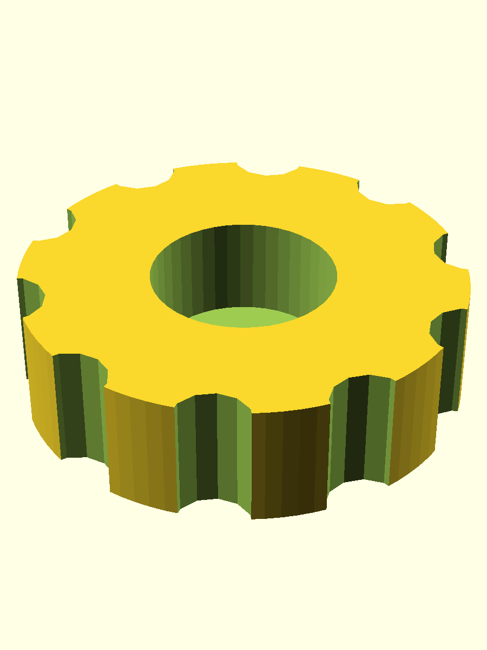
cad/preview/upper_carriage/knob/iso.png
