sankao/robothector/cad/preview/upper_carriage/knob/side.png

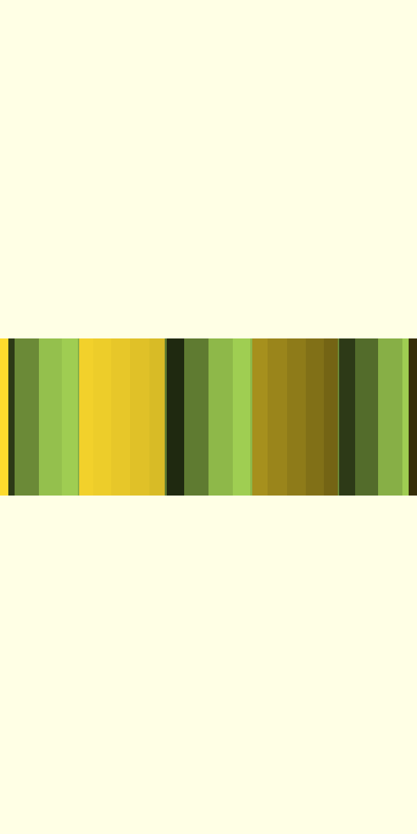
cad/preview/upper_carriage/knob/side.png
