sankao/robothector/cad/preview/upper_carriage/knob/top.png

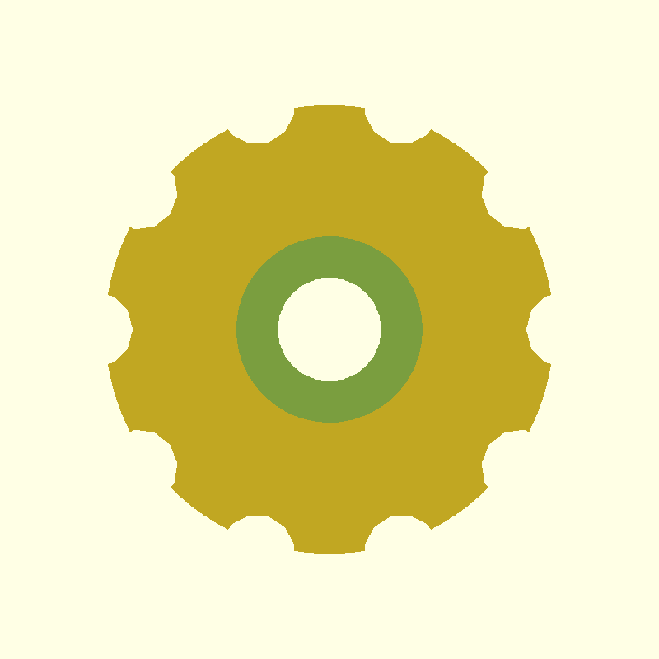
cad/preview/upper_carriage/knob/top.png
