sankao/robothector/cad/preview/upper_carriage/l298n_plate/iso.png

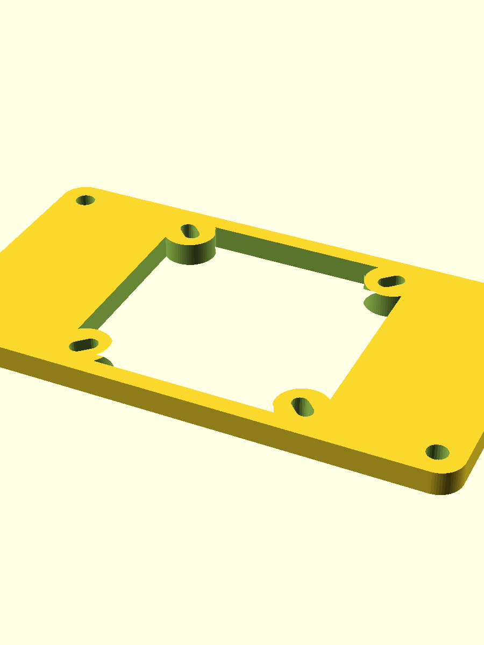
cad/preview/upper_carriage/l298n_plate/iso.png
