sankao/robothector/cad/preview/upper_carriage/l298n_plate/top.png

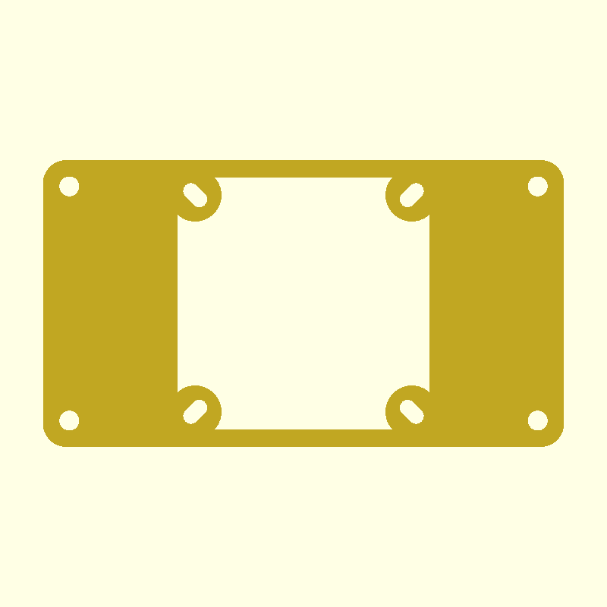
cad/preview/upper_carriage/l298n_plate/top.png
