sankao/robothector/cad/preview/upper_carriage/lid/iso.png

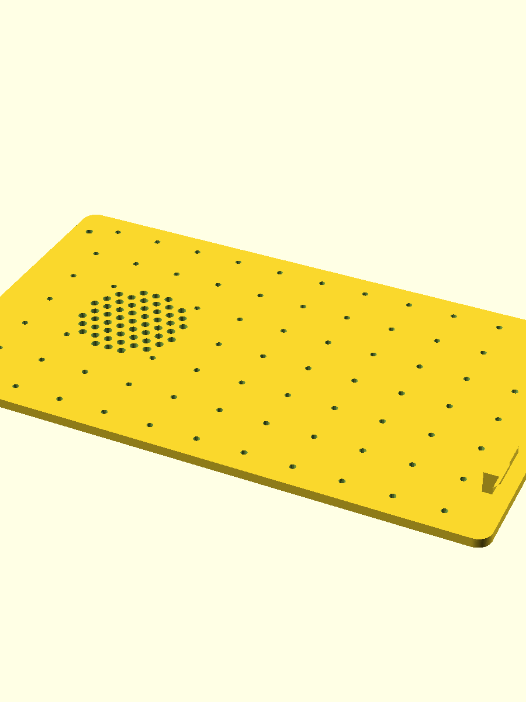
cad/preview/upper_carriage/lid/iso.png
