sankao/robothector/cad/preview/upper_carriage/lid/side.png

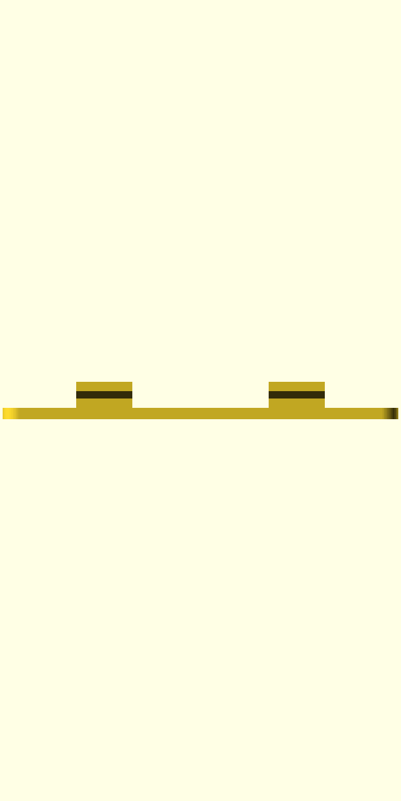
cad/preview/upper_carriage/lid/side.png
