sankao/robothector/cad/preview/upper_carriage/lid/top.png

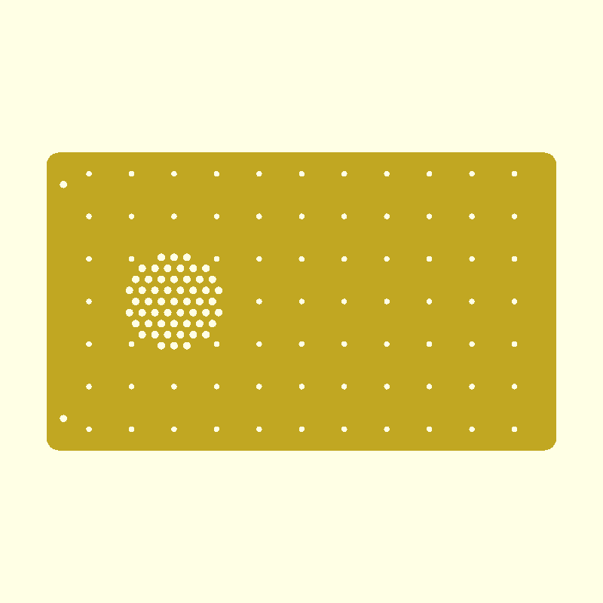
cad/preview/upper_carriage/lid/top.png
