sankao/robothector/cad/preview/upper_carriage/max_bank/iso.png

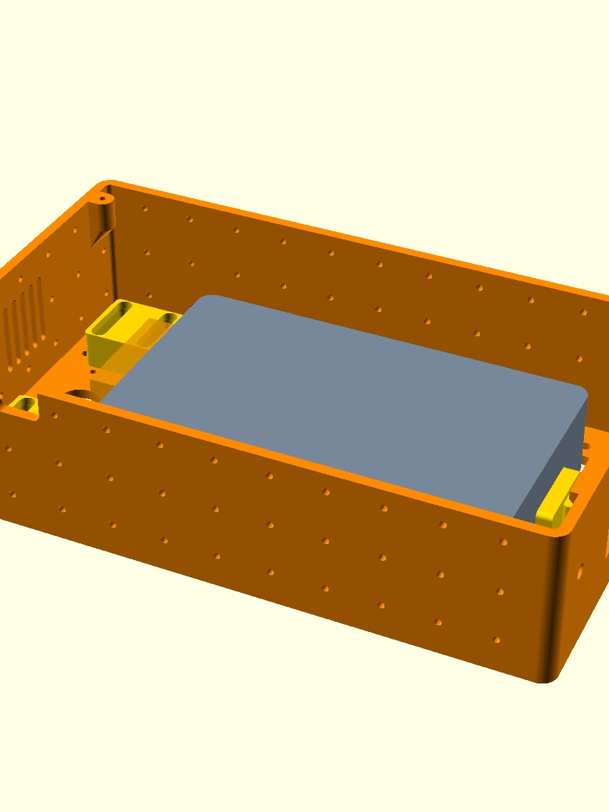
cad/preview/upper_carriage/max_bank/iso.png
