sankao/robothector/cad/preview/upper_carriage/max_bank/side.png

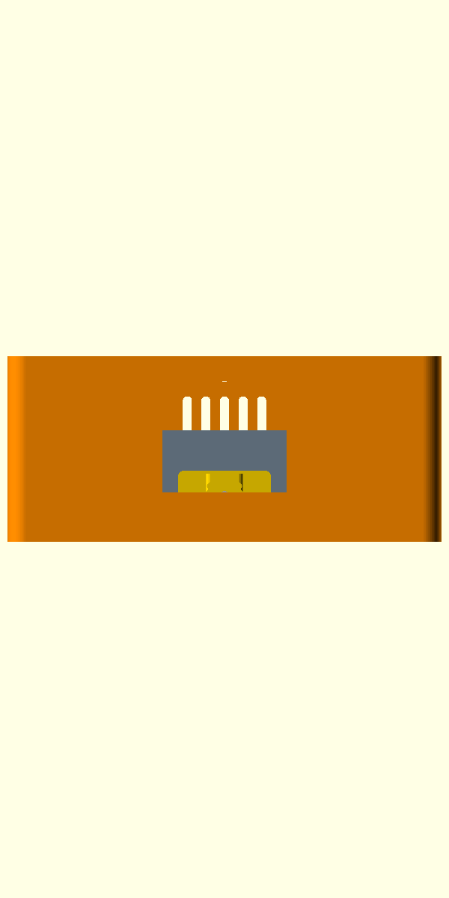
cad/preview/upper_carriage/max_bank/side.png
