sankao/robothector/cad/preview/upper_carriage/open/front.png

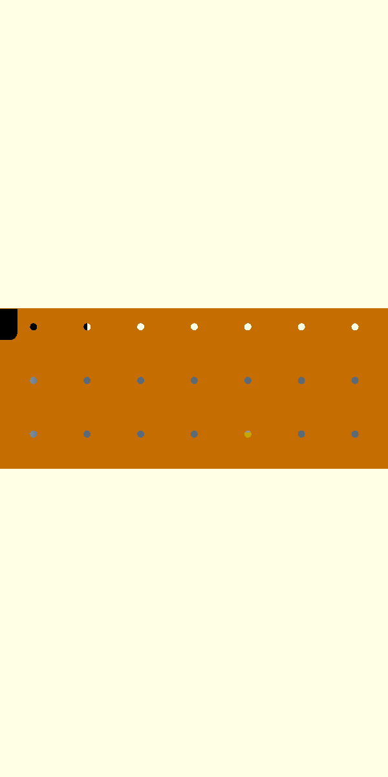
cad/preview/upper_carriage/open/front.png
