sankao/robothector/cad/preview/upper_carriage/open/iso_rear.png

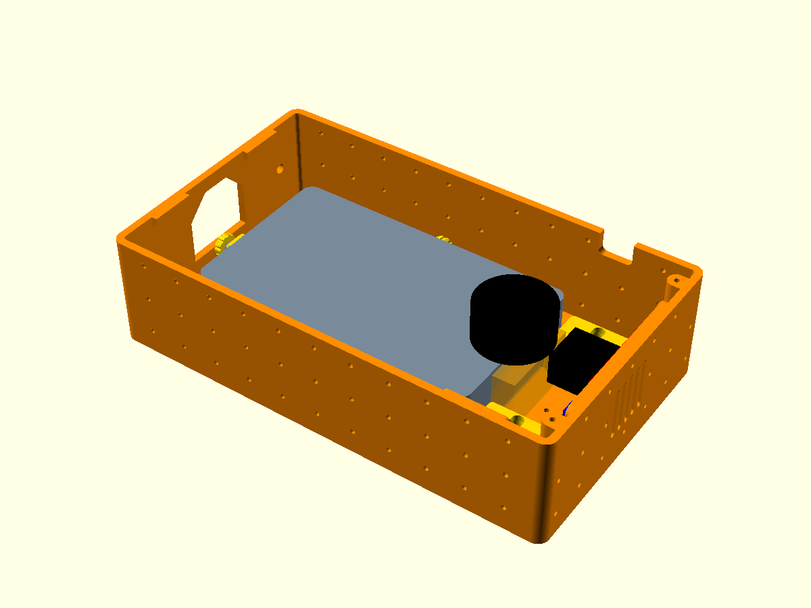
cad/preview/upper_carriage/open/iso_rear.png
