sankao/robothector/cad/preview/upper_carriage/open/side.png

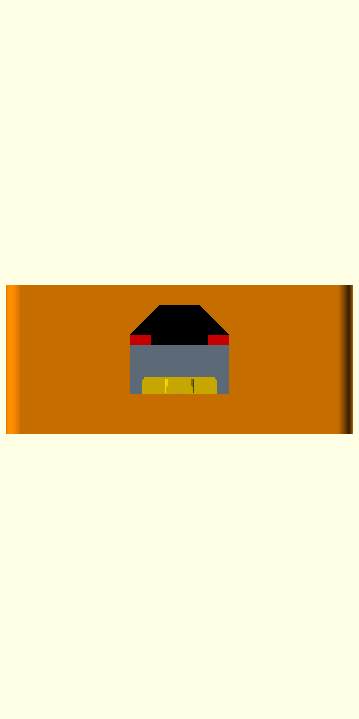
cad/preview/upper_carriage/open/side.png
