sankao/robothector/cad/preview/upper_carriage/open/top.png

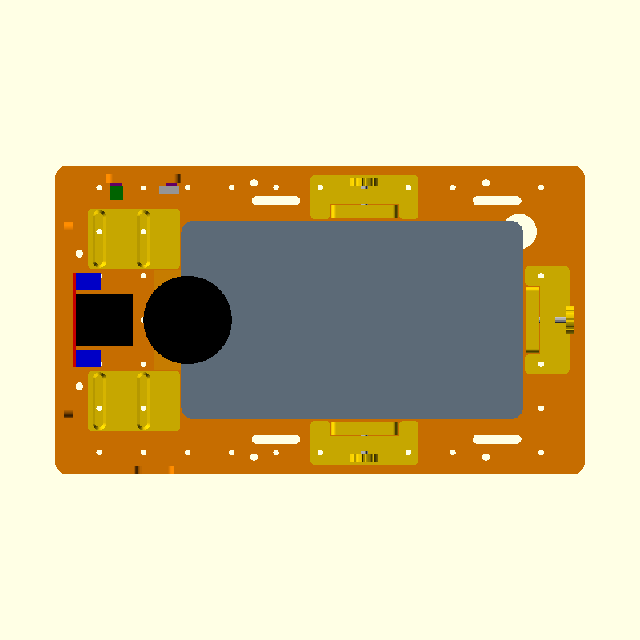
cad/preview/upper_carriage/open/top.png
