sankao/robothector/cad/preview/upper_carriage/pd_plate/iso.png

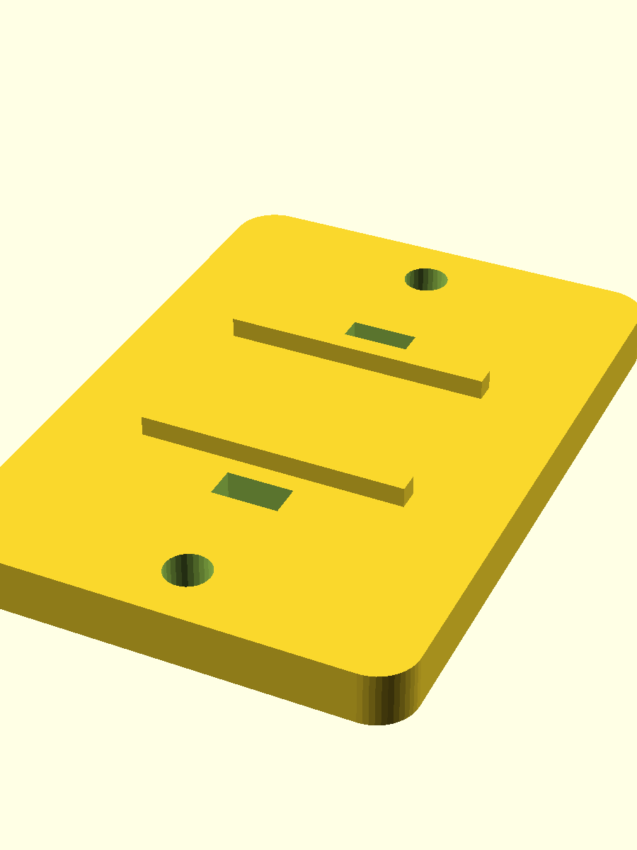
cad/preview/upper_carriage/pd_plate/iso.png
