sankao/robothector/cad/preview/upper_carriage/pd_plate/top.png

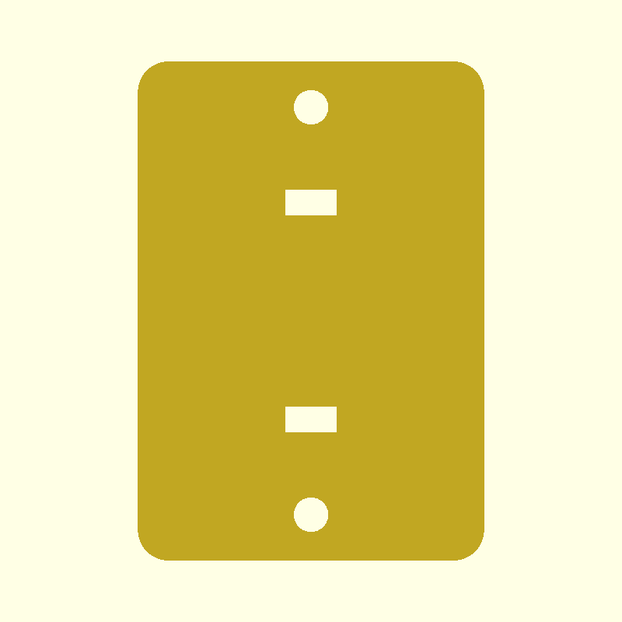
cad/preview/upper_carriage/pd_plate/top.png
