sankao/robothector/cad/preview/upper_carriage/pusher/iso.png

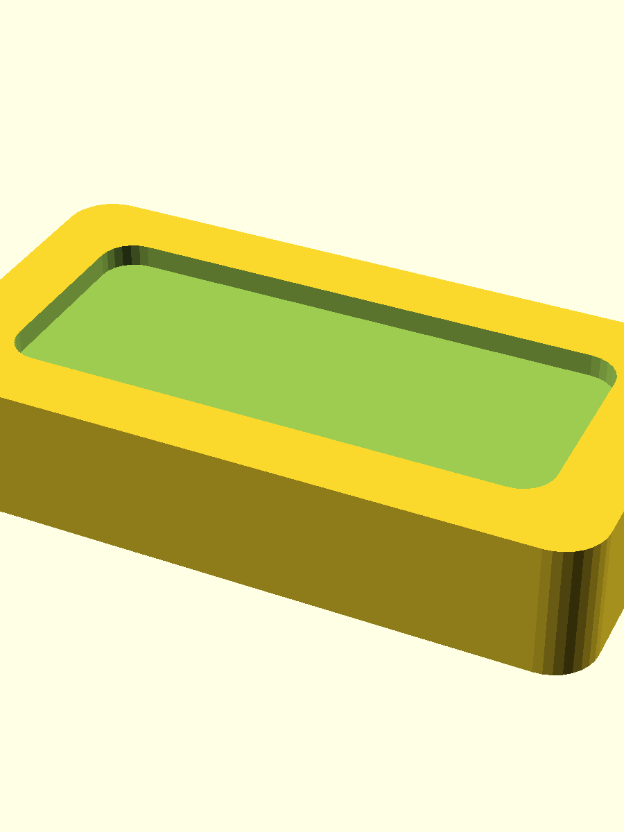
cad/preview/upper_carriage/pusher/iso.png
