sankao/robothector/cad/preview/upper_carriage/rear_stop/iso.png

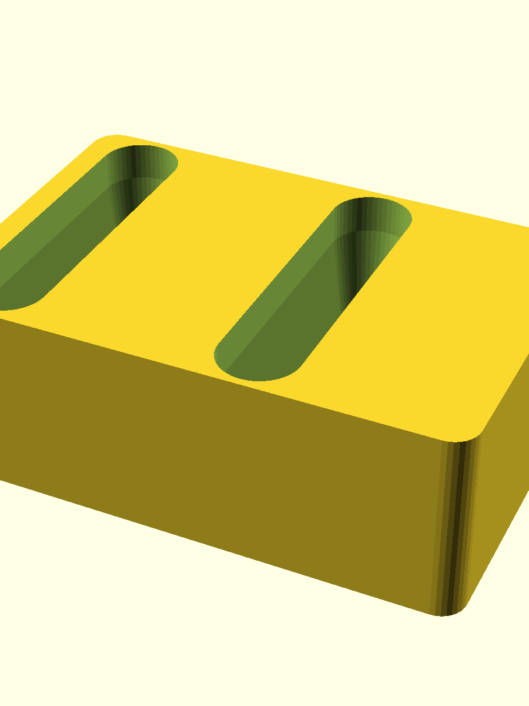
cad/preview/upper_carriage/rear_stop/iso.png
