sankao/robothector/cad/preview/upper_carriage/rear_stop/top.png

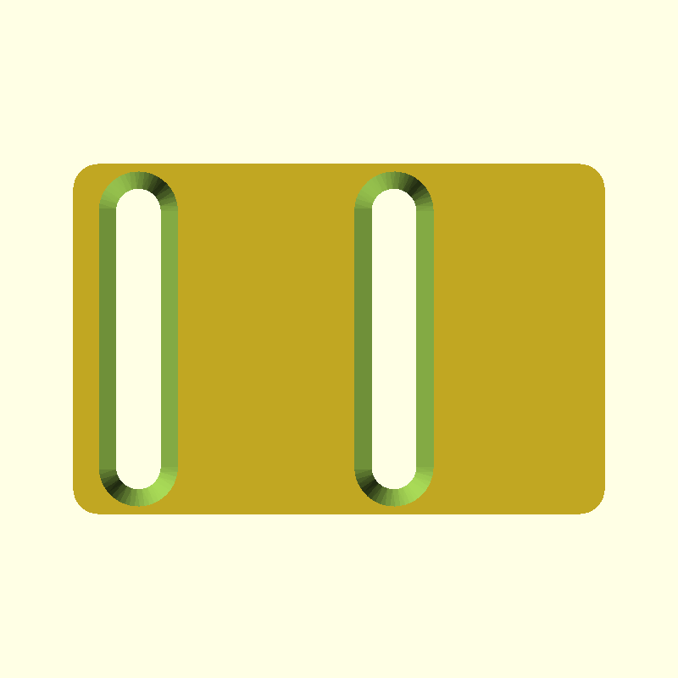
cad/preview/upper_carriage/rear_stop/top.png
