sankao/robothector/cad/preview/upper_carriage/sec_corbel.png

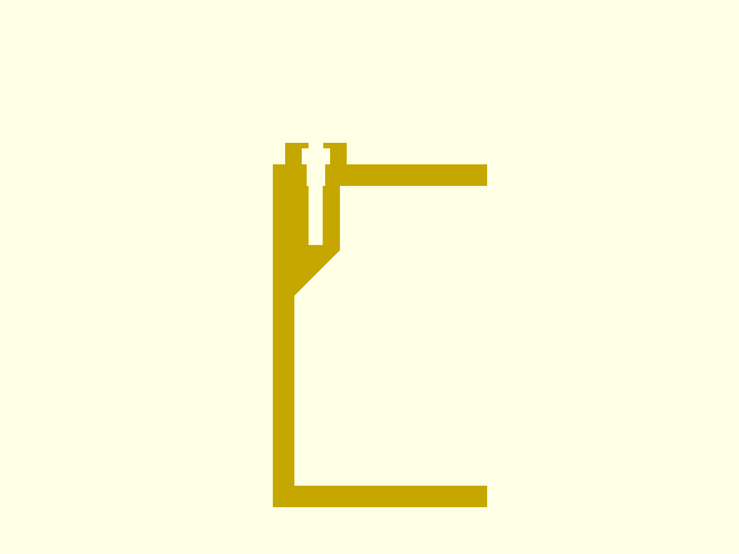
cad/preview/upper_carriage/sec_corbel.png
