sankao/robothector/cad/preview/upper_carriage/sec_hook.png

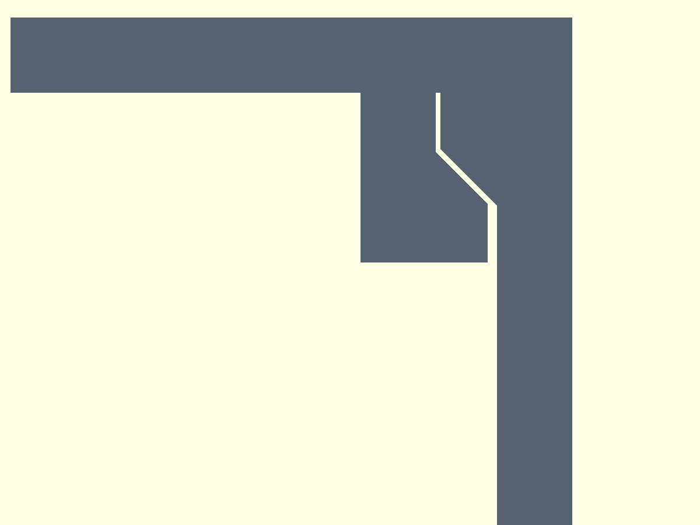
cad/preview/upper_carriage/sec_hook.png
