sankao/robothector/cad/preview/upper_carriage/sec_j3.png

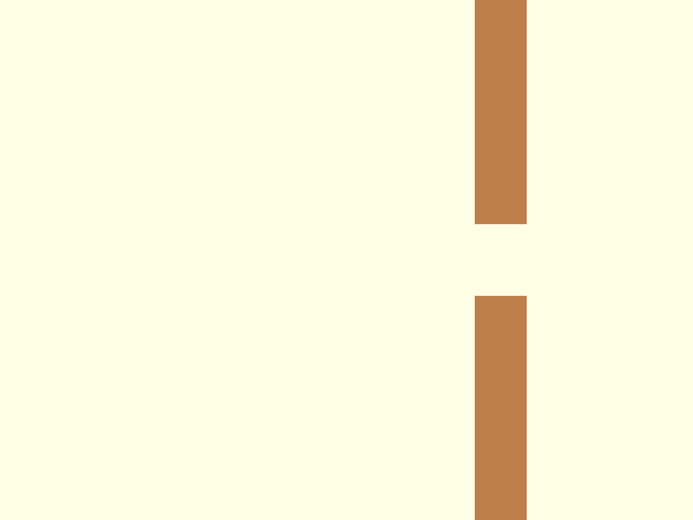
cad/preview/upper_carriage/sec_j3.png
