sankao/robothector/cad/preview/upper_carriage/sec_l298n.png

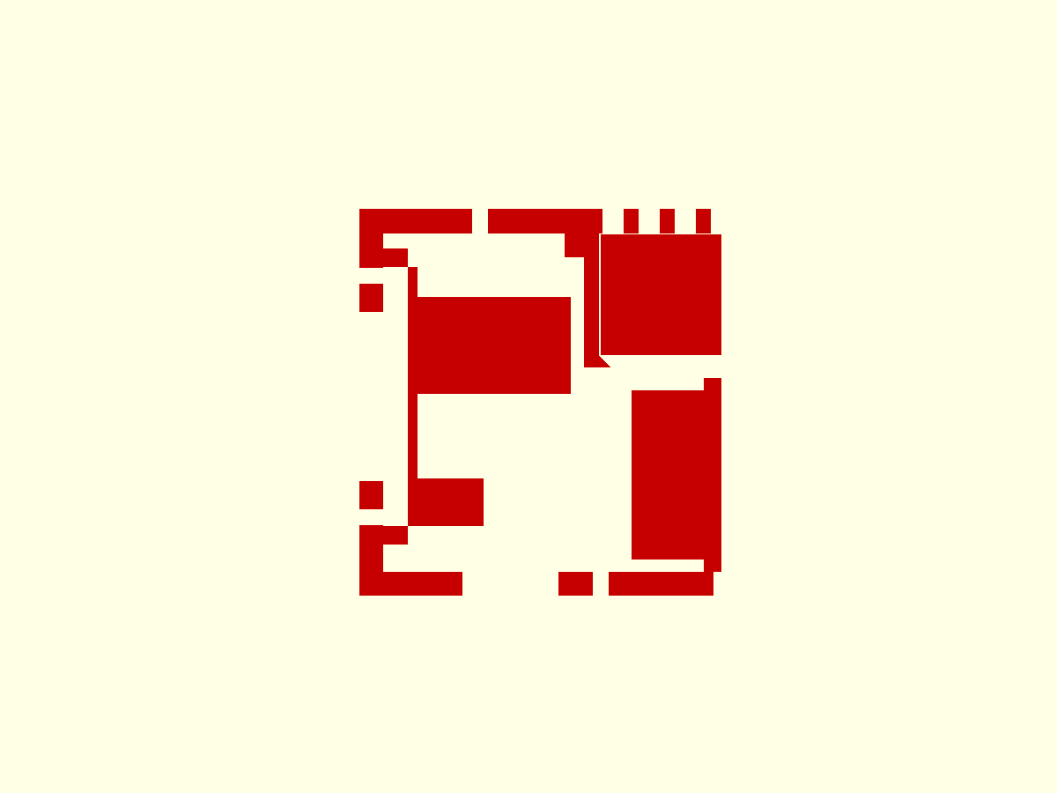
cad/preview/upper_carriage/sec_l298n.png
