sankao/robothector/cad/preview/upper_carriage/sec_speaker.png

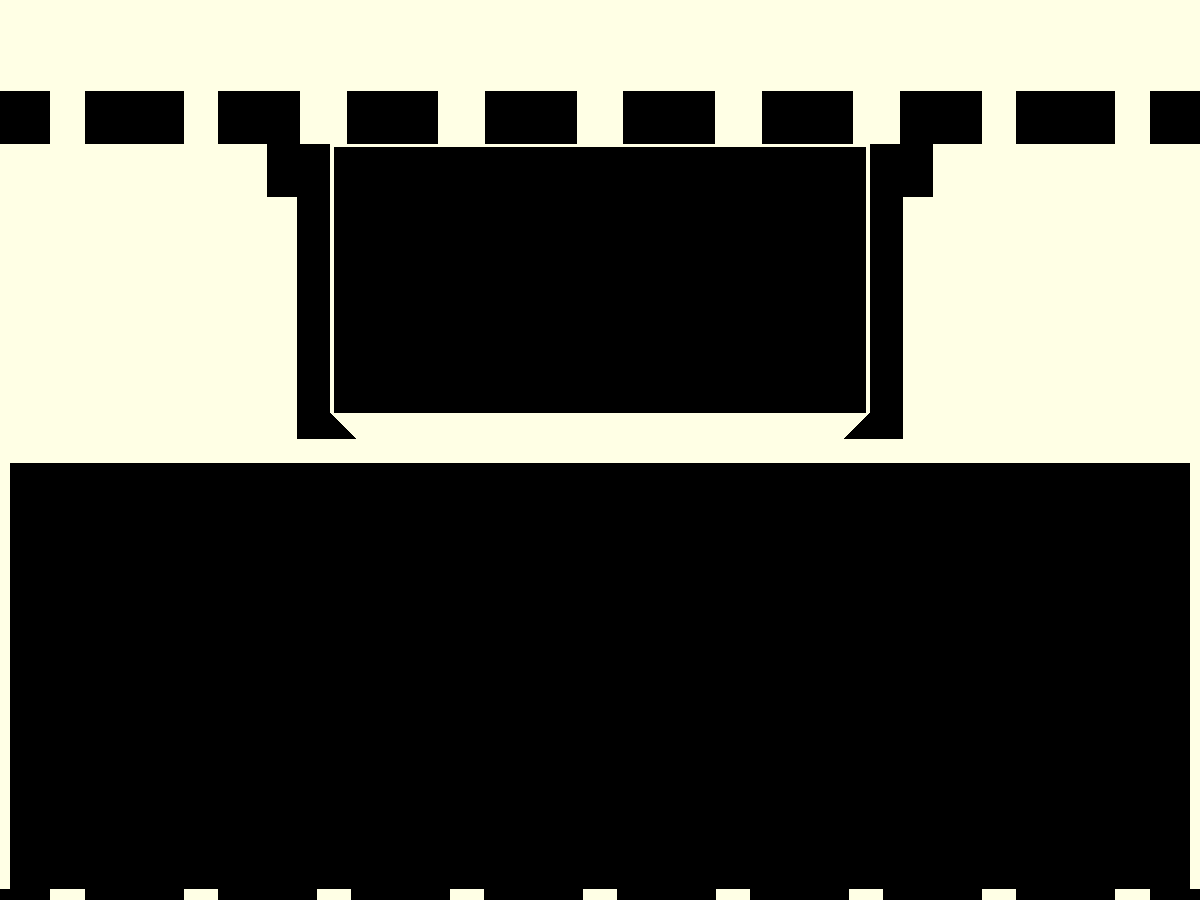
cad/preview/upper_carriage/sec_speaker.png
