sankao/robothector/cad/preview/upper_carriage/sec_xclamp.png

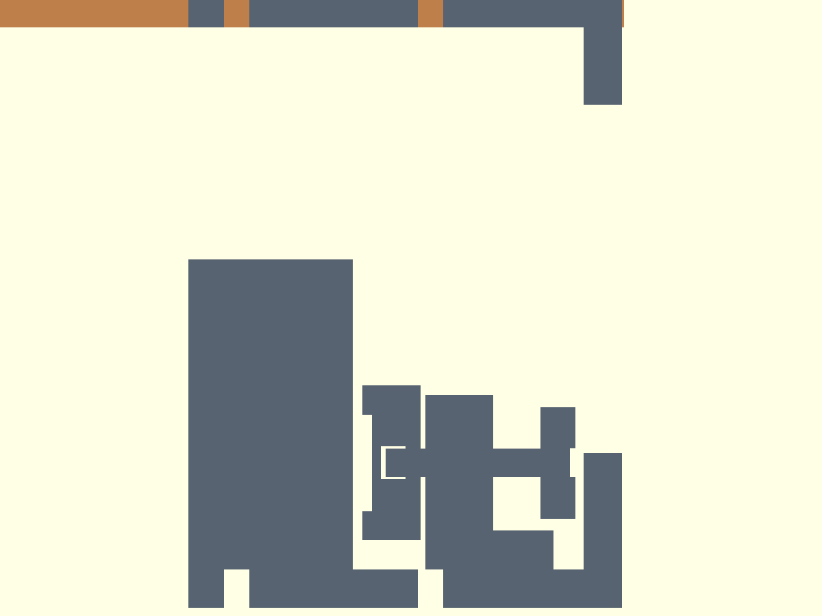
cad/preview/upper_carriage/sec_xclamp.png
