sankao/robothector/cad/preview/upper_carriage/sec_yclamp.png

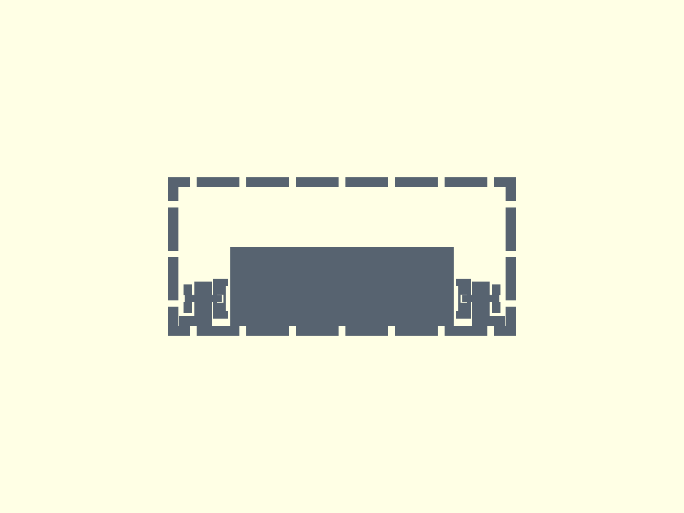
cad/preview/upper_carriage/sec_yclamp.png
