sankao/robothector/cad/preview/upper_carriage/small_bank/top.png

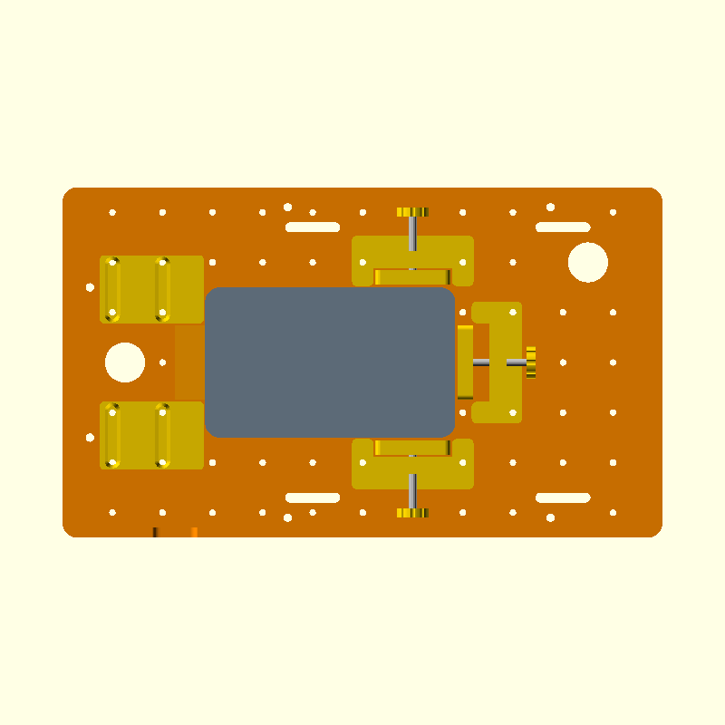
cad/preview/upper_carriage/small_bank/top.png
