sankao/robothector/cad/preview/upper_carriage/speaker_ring/iso.png

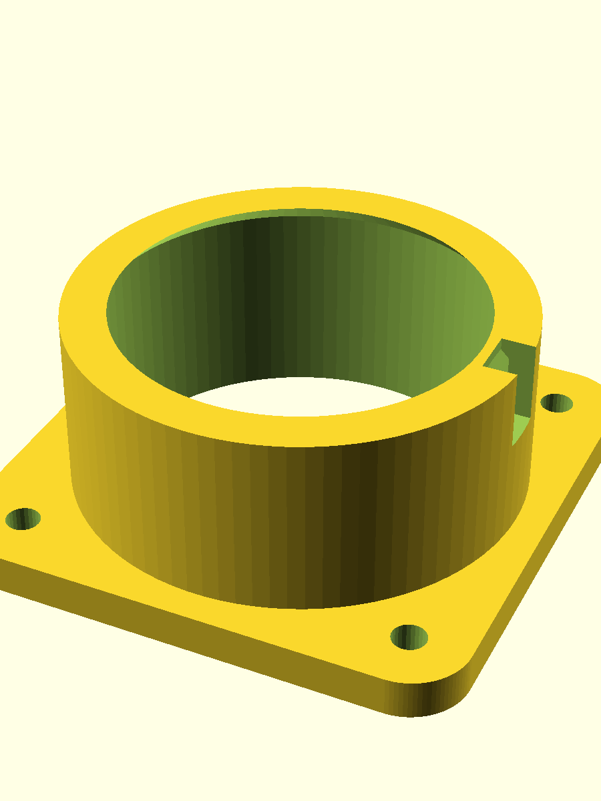
cad/preview/upper_carriage/speaker_ring/iso.png
