sankao/robothector/cad/preview/upper_carriage/speaker_ring/top.png

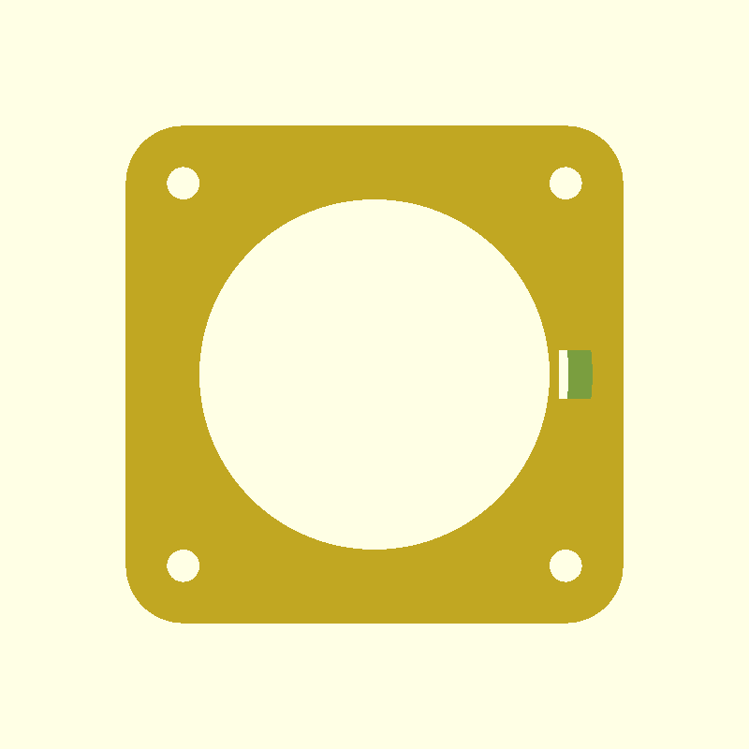
cad/preview/upper_carriage/speaker_ring/top.png
