sankao/robothector/cad/preview/upper_carriage/tray/front.png

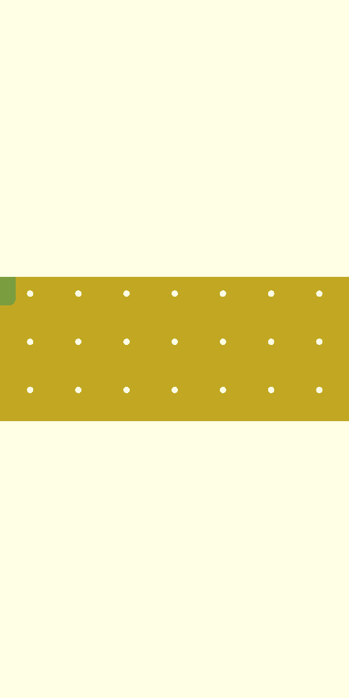
cad/preview/upper_carriage/tray/front.png
