sankao/robothector/cad/preview/upper_carriage/tray/top.png

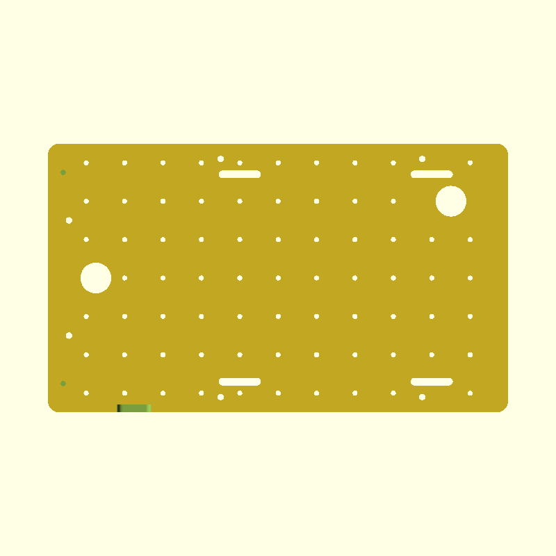
cad/preview/upper_carriage/tray/top.png
