sankao/robothector/cad/preview/cabin/assembly_parts_only/front.png

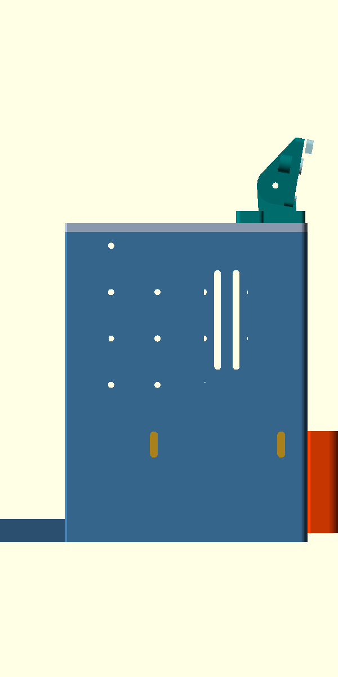
cad/preview/cabin/assembly_parts_only/front.png
