sankao/robothector/cad/preview/cabin/assembly_parts_only/iso.png

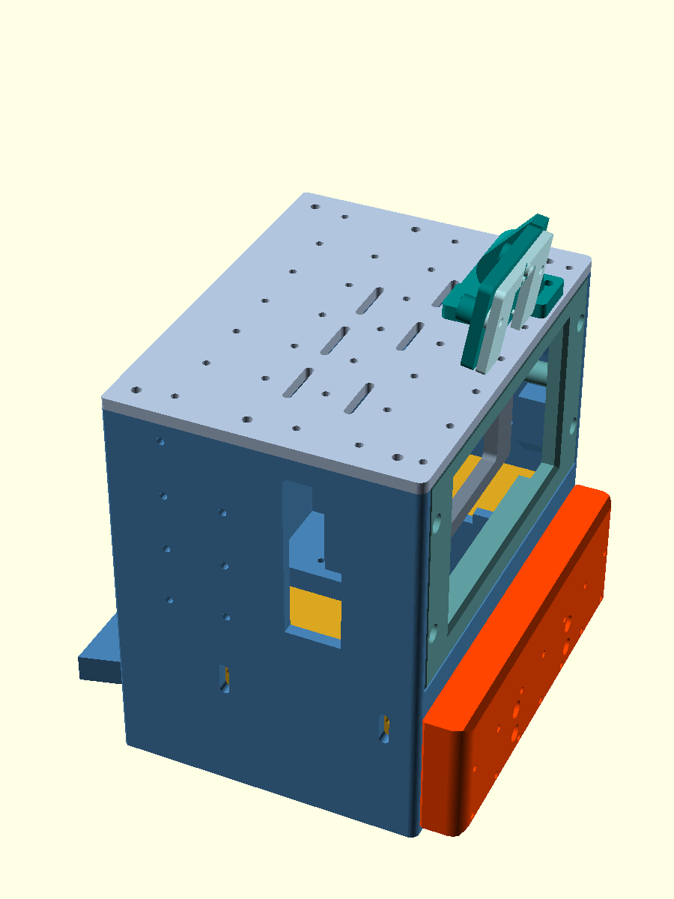
cad/preview/cabin/assembly_parts_only/iso.png
