sankao/robothector/cad/preview/cabin/assembly_parts_only/side.png

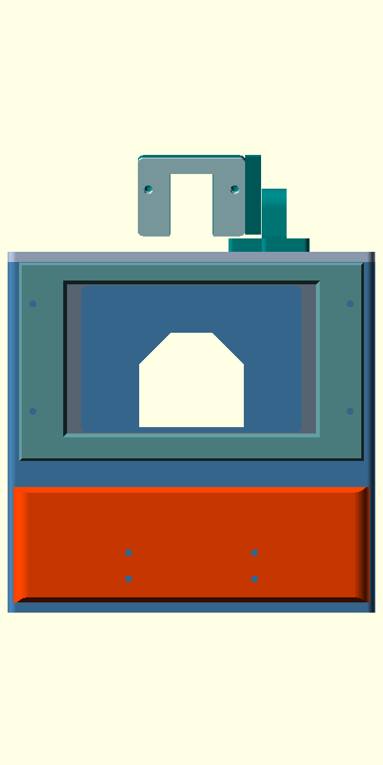
cad/preview/cabin/assembly_parts_only/side.png
