sankao/robothector/cad/preview/cabin/assembly_parts_only/top.png

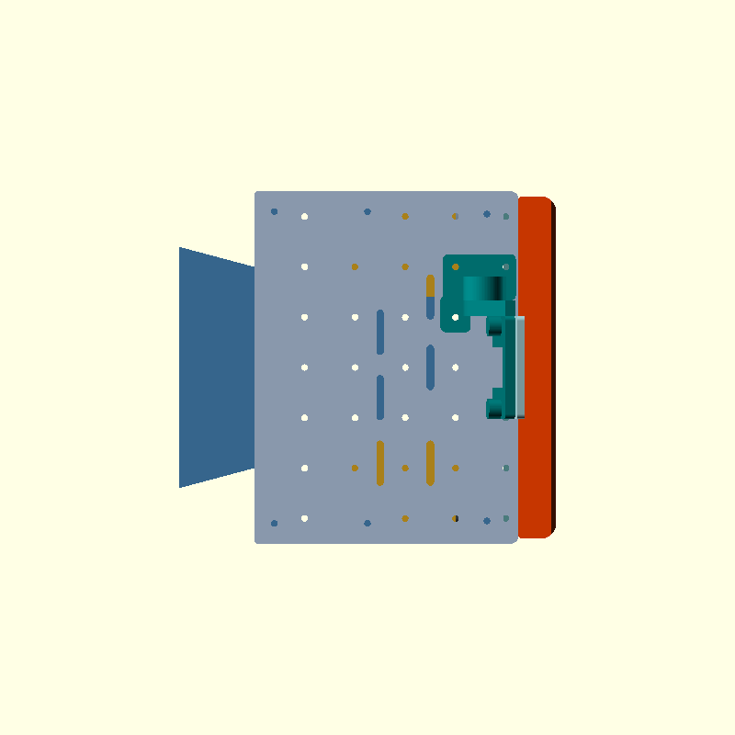
cad/preview/cabin/assembly_parts_only/top.png
