sankao/robothector/cad/3mf/08-lower_carriage-clamps_0.20mm.3mf

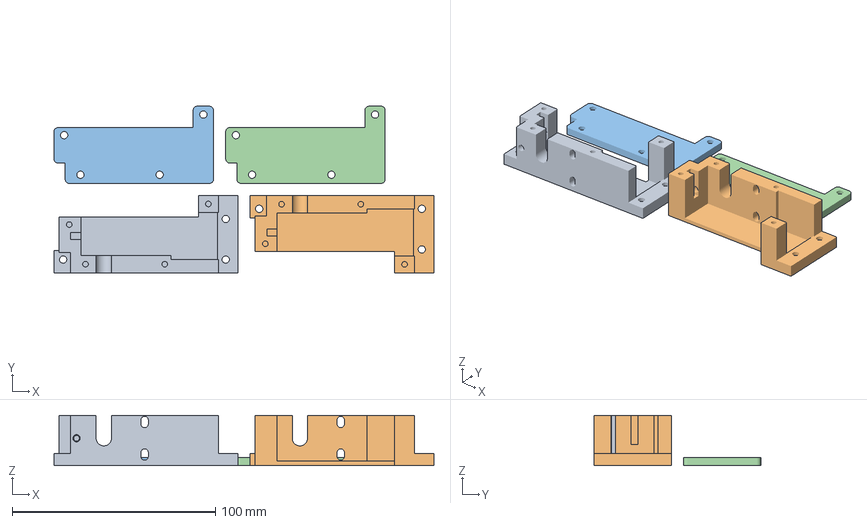
[picture p83: CAD file, 2026-10-24]
cad/3mf/08-lower_carriage-clamps_0.20mm.3mf
187.0 x 82.0 x 24.8 mm
lower_carriage-tt_clamp
lower_carriage-tt_clamp_mirror
lower_carriage-tt_cap #1
lower_carriage-tt_cap #2
