sankao/robothector/cad/stl/lower_carriage-tt_cap.stl

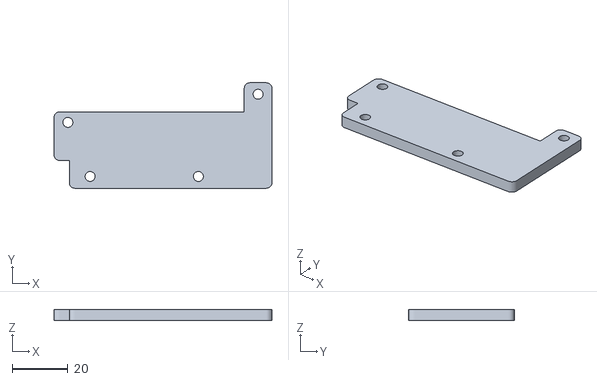
[picture p84: CAD file, 2026-10-24]
cad/stl/lower_carriage-tt_cap.stl
78.5 x 38.0 x 4.00
