sankao/robothector/cad/3mf/10-cabin-faceplate_0.20mm.3mf

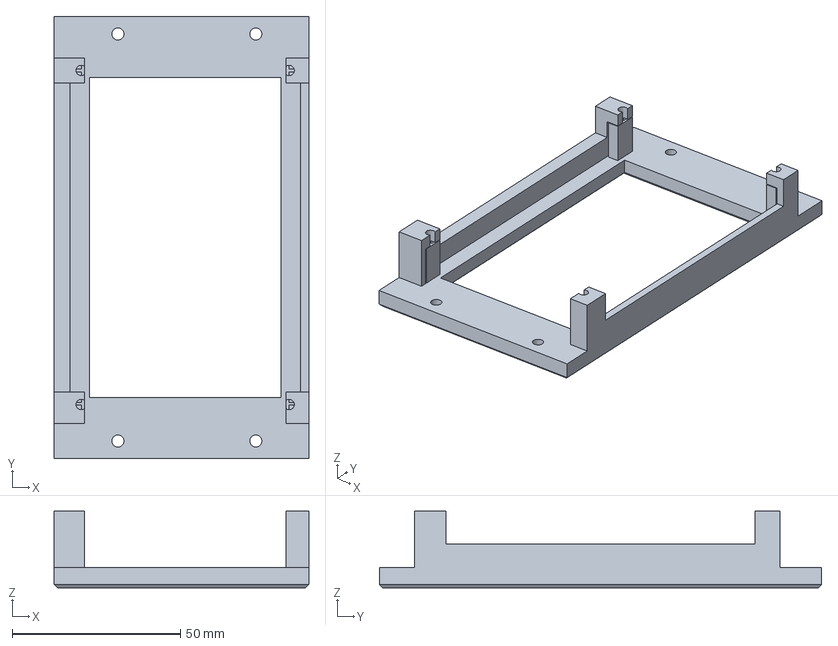
[picture p85: CAD file, 2026-10-24]
cad/3mf/10-cabin-faceplate_0.20mm.3mf
75.8 x 131.5 x 22.8 mm
