sankao/robothector/cad/stl/lower_carriage-tt_clamp_mirror.stl

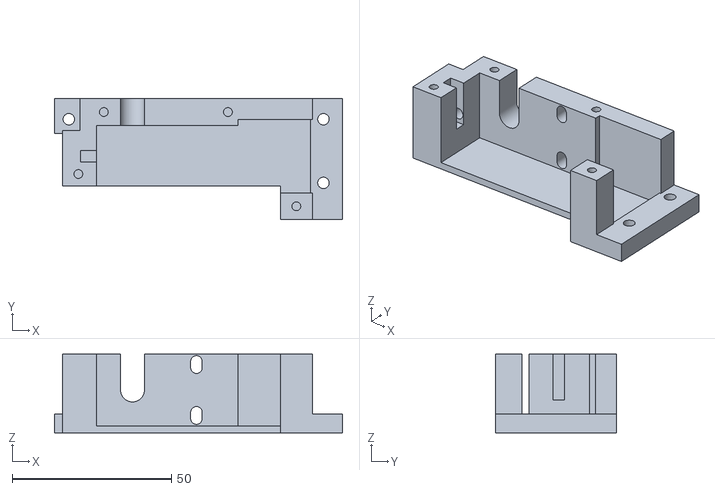
[picture p86: CAD file, 2026-10-24]
cad/stl/lower_carriage-tt_clamp_mirror.stl
90.5 x 38.0 x 24.8
