sankao/robothector/cad/3mf/04-lower_carriage-frame_0.30mm.3mf

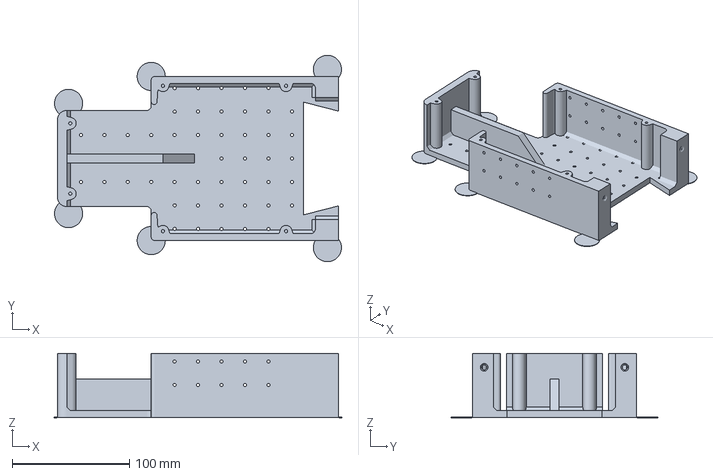
[picture p87: CAD file, 2026-10-24]
cad/3mf/04-lower_carriage-frame_0.30mm.3mf
244.8 x 176.0 x 55.0 mm
