sankao/robothector/cad/3mf/05-cabin-panels_0.20mm.3mf

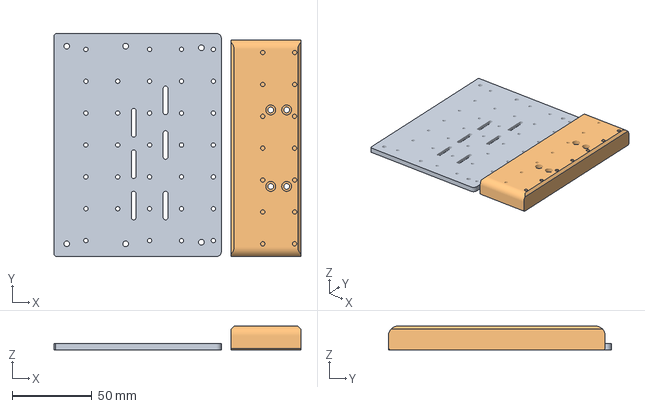
[picture p88: CAD file, 2026-10-24]
cad/3mf/05-cabin-panels_0.20mm.3mf
155.0 x 140.0 x 15.0 mm
cabin-roof
cabin-bumper
