sankao/robothector/cad/3mf/06-cabin-small_0.20mm.3mf

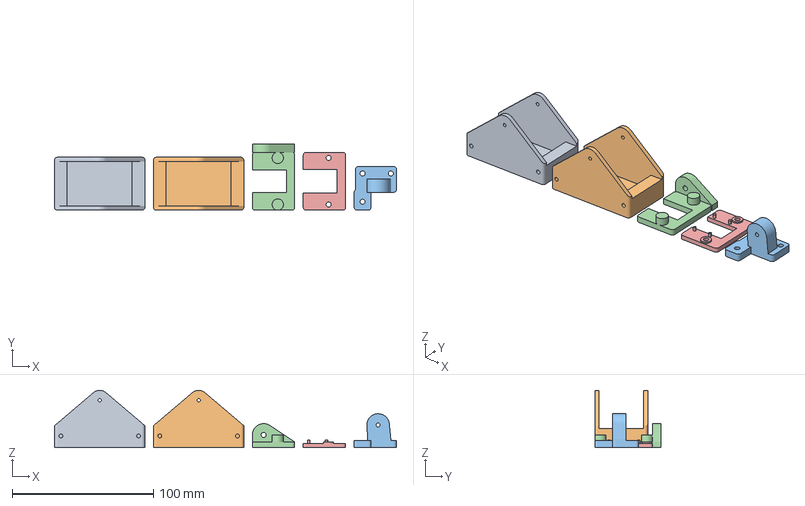
[picture p89: CAD file, 2026-10-24]
cad/3mf/06-cabin-small_0.20mm.3mf
242.0 x 47.0 x 40.5 mm
cabin-omni_cassette #1
cabin-omni_cassette #2
cabin-camera_bracket
cabin-camera_cradle
cabin-camera_clip
