sankao/robothector/cad/stl/upper_carriage-tray.stl

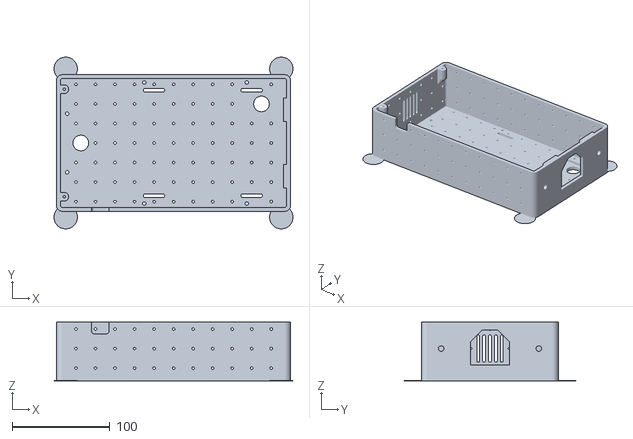
[picture p90: CAD file, 2026-10-24]
cad/stl/upper_carriage-tray.stl
244.8 x 176.0 x 60.0
