sankao/robothector/cad/3mf/09-rod_cutting_jig_0.20mm.3mf

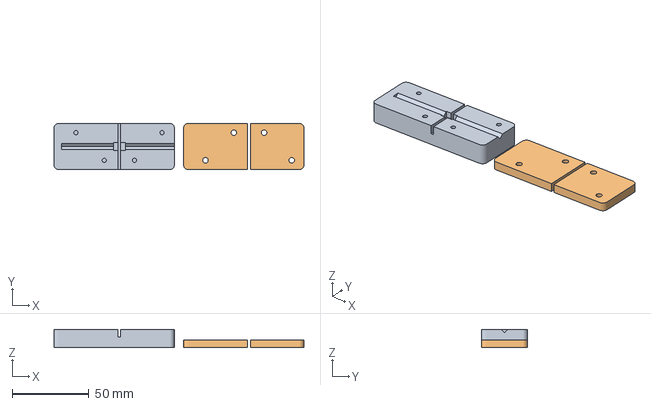
[picture p91: CAD file, 2026-10-24]
cad/3mf/09-rod_cutting_jig_0.20mm.3mf
162.8 x 30.0 x 12.0 mm
rod_jig-base
rod_jig-lid
