sankao/robothector/cad/stl/cabin-body.stl

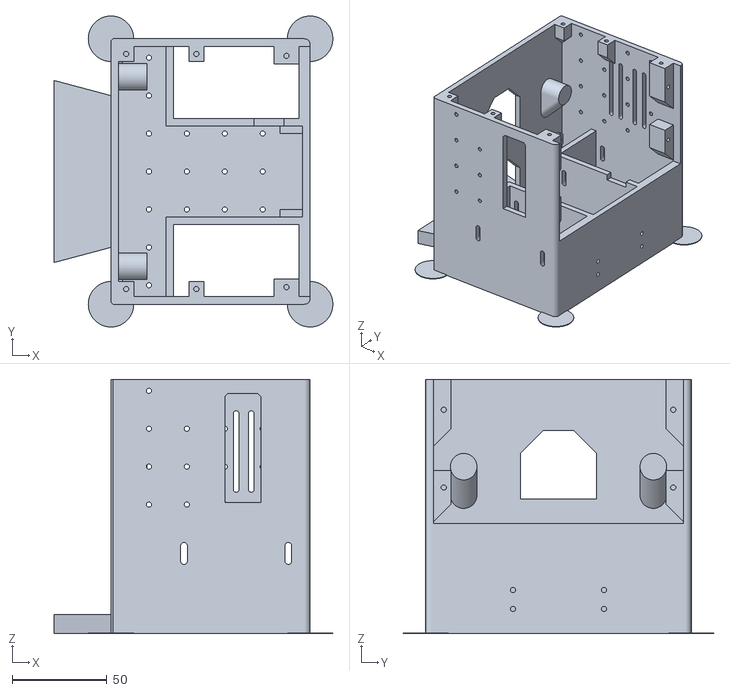
[picture p92: CAD file, 2026-10-24]
cad/stl/cabin-body.stl
147.0 x 164.0 x 134.0
