sankao/robothector/cad/stl/rod_jig-lid.stl

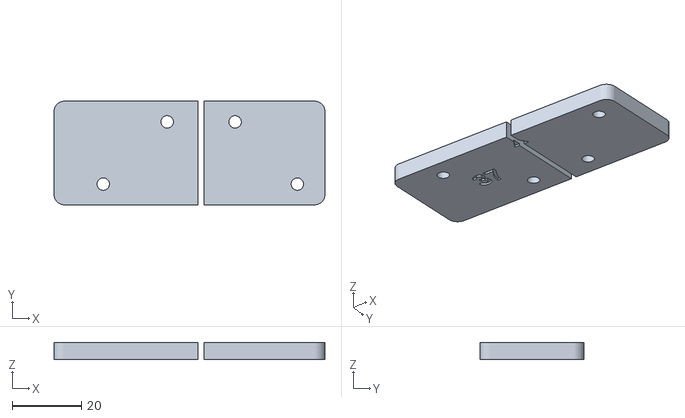
[picture p93: CAD file, 2026-10-24]
cad/stl/rod_jig-lid.stl
78.4 x 30.0 x 5.00
