sankao/robothector/cad/stl/cabin-bumper.stl

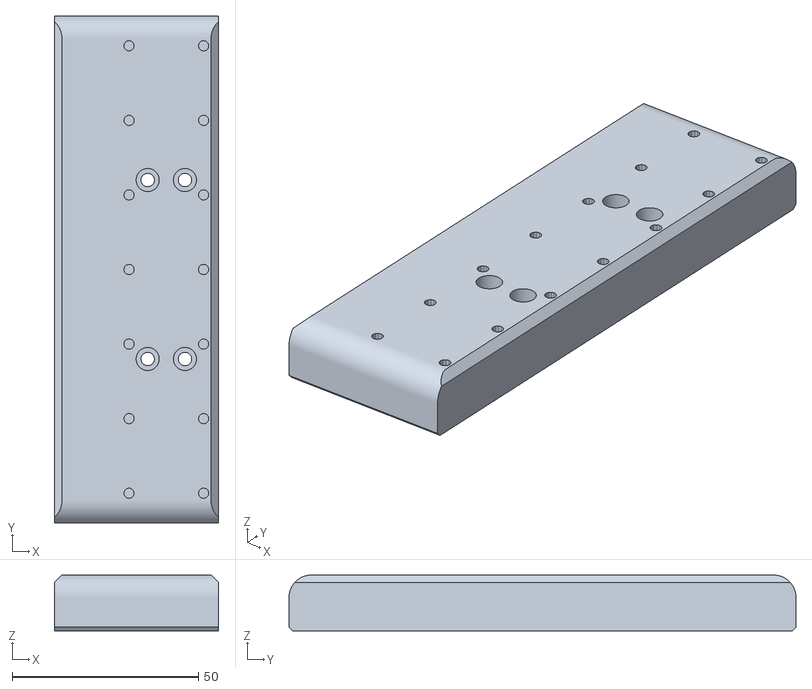
[picture p94: CAD file, 2026-10-24]
cad/stl/cabin-bumper.stl
44.0 x 136.0 x 15.0
