sankao/robothector/cad/3mf/00-fit_test-coupon_0.30mm.3mf

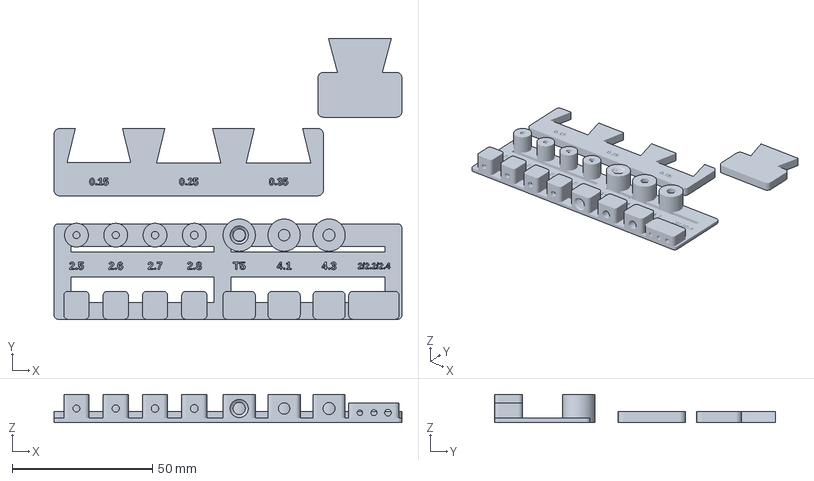
[picture p95: CAD file, 2026-10-24]
cad/3mf/00-fit_test-coupon_0.30mm.3mf
124.0 x 100.0 x 10.0 mm
