sankao/robothector/cad/stl/upper_carriage-clamp_post.stl

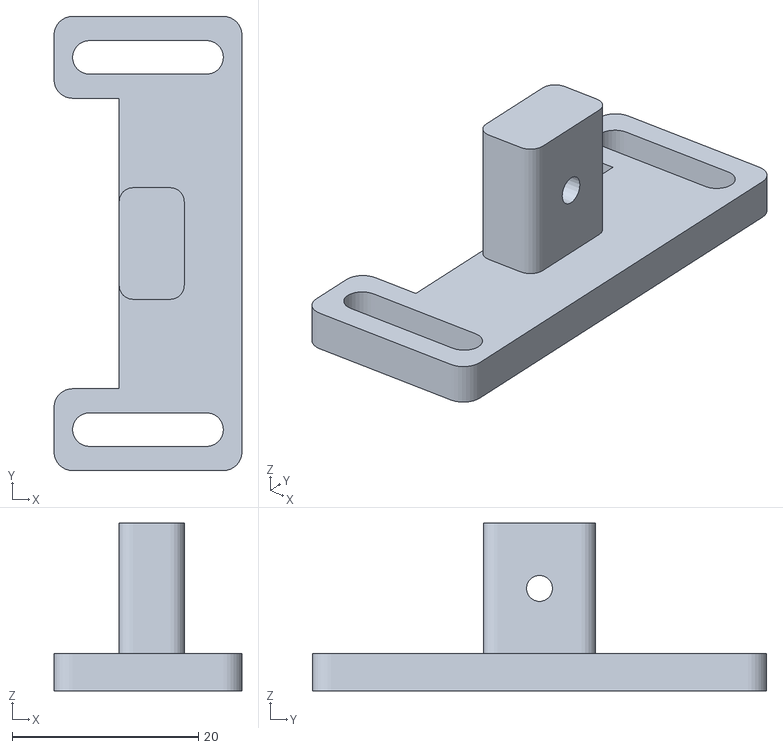
[picture p96: CAD file, 2026-10-24]
cad/stl/upper_carriage-clamp_post.stl
20.2 x 48.8 x 18.0
