sankao/robothector/cad/3mf/07-upper_carriage-small_0.20mm.3mf

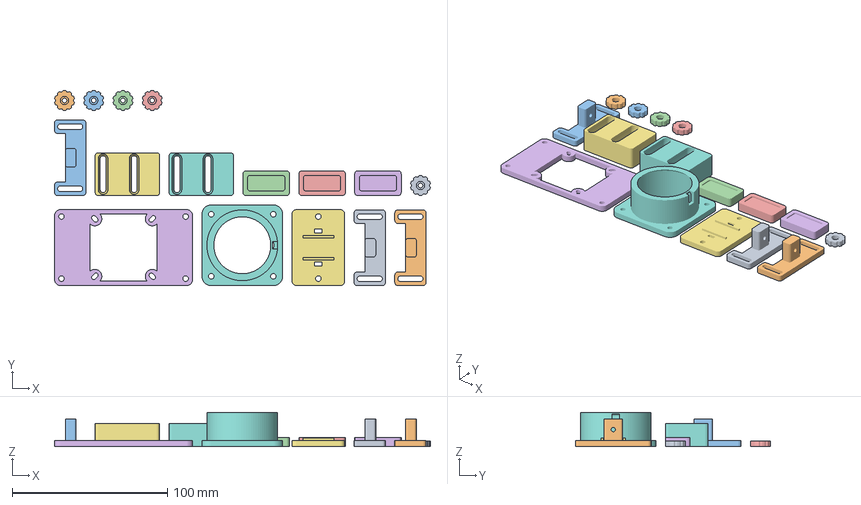
[picture p97: CAD file, 2026-10-24]
cad/3mf/07-upper_carriage-small_0.20mm.3mf
242.2 x 125.8 x 22.2 mm
upper_carriage-clamp_post #1
upper_carriage-clamp_post #2
upper_carriage-clamp_post #3
upper_carriage-pusher #1
upper_carriage-pusher #2
upper_carriage-pusher #3
upper_carriage-rear_stop #1
upper_carriage-rear_stop #2
upper_carriage-knob #1
upper_carriage-knob #2
upper_carriage-knob #3
upper_carriage-knob #4
upper_carriage-knob #5
upper_carriage-l298n_plate
upper_carriage-pd_plate
upper_carriage-speaker_ring
