sankao/robothector/cad/stl/cabin-camera_clip.stl

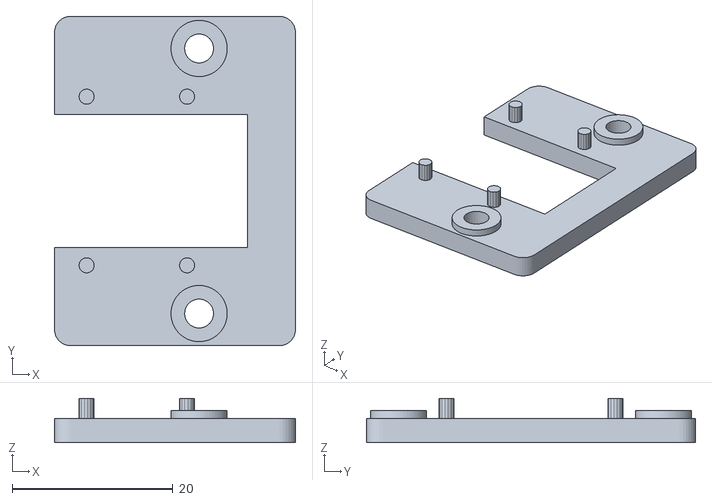
[picture p98: CAD file, 2026-10-24]
cad/stl/cabin-camera_clip.stl
30.0 x 41.0 x 5.50
