sankao/robothector/cad/3mf/03-upper_carriage-lid_0.30mm.3mf

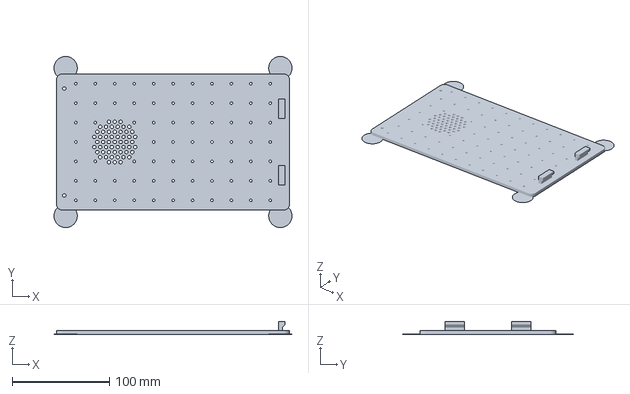
[picture p99: CAD file, 2026-10-24]
cad/3mf/03-upper_carriage-lid_0.30mm.3mf
244.8 x 176.0 x 13.0 mm
