sankao/robothector/cad/stl/upper_carriage-l298n_plate.stl

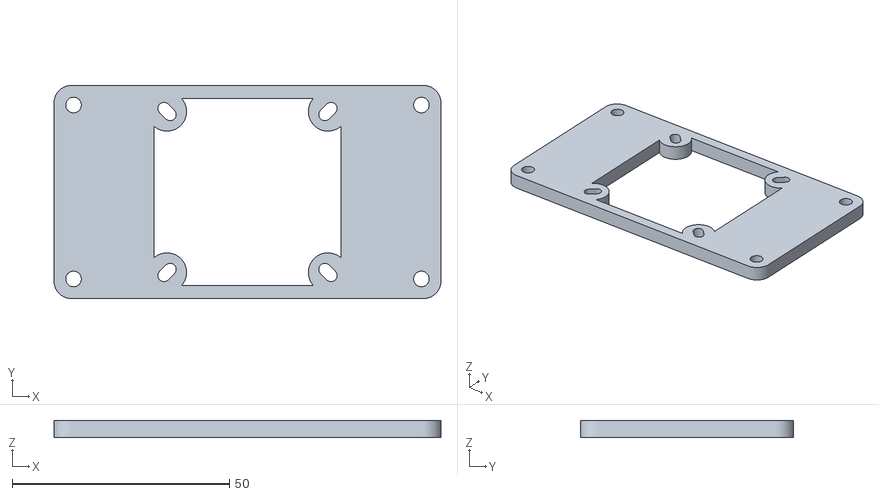
[picture p100: CAD file, 2026-10-24]
cad/stl/upper_carriage-l298n_plate.stl
89.0 x 49.0 x 4.00
