sankao/robothector/cad/stl/cabin-omni_cassette.stl

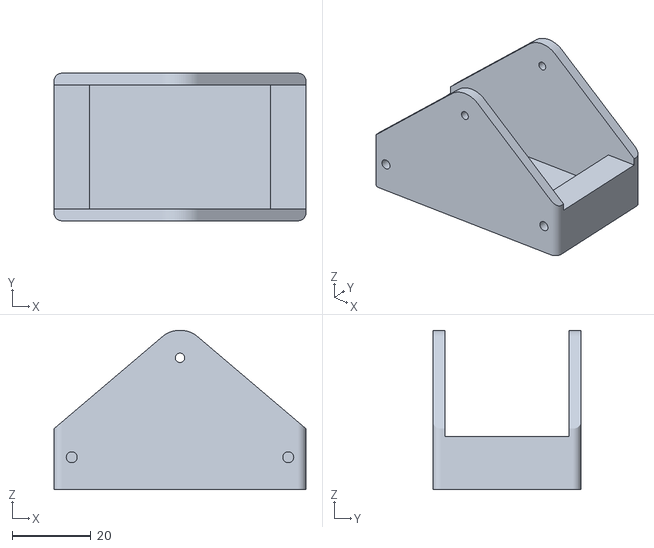
[picture p101: CAD file, 2026-10-24]
cad/stl/cabin-omni_cassette.stl
64.0 x 37.5 x 40.5
