sankao/robothector/cad/stl/cabin-roof.stl

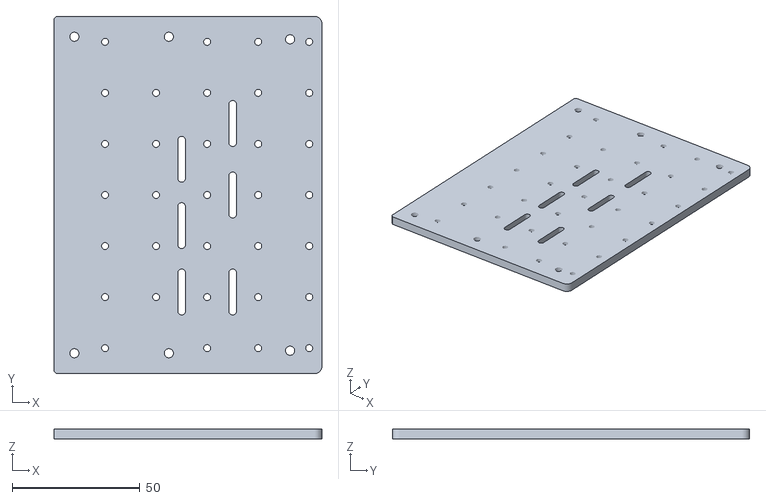
[picture p102: CAD file, 2026-10-24]
cad/stl/cabin-roof.stl
105.0 x 140.0 x 4.00
