sankao/robothector/cad/stl/upper_carriage-pusher.stl

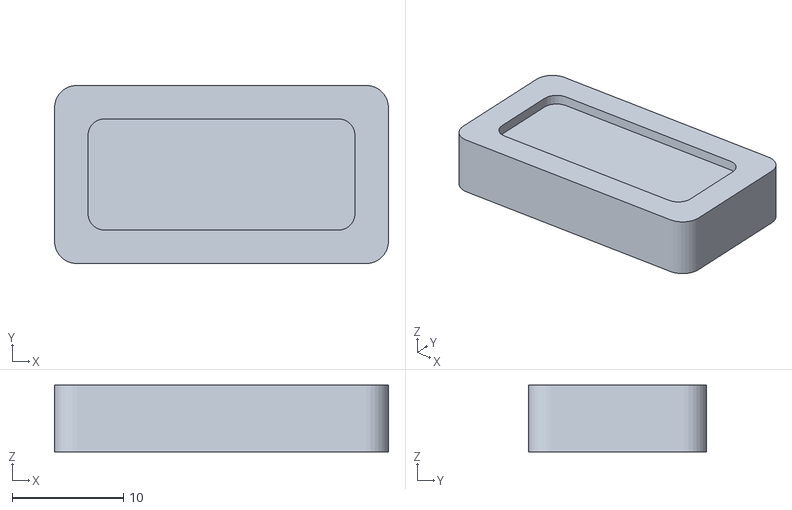
[picture p103: CAD file, 2026-10-24]
cad/stl/upper_carriage-pusher.stl
30.0 x 16.0 x 6.00
