sankao/robothector/cad/stl/upper_carriage-knob.stl

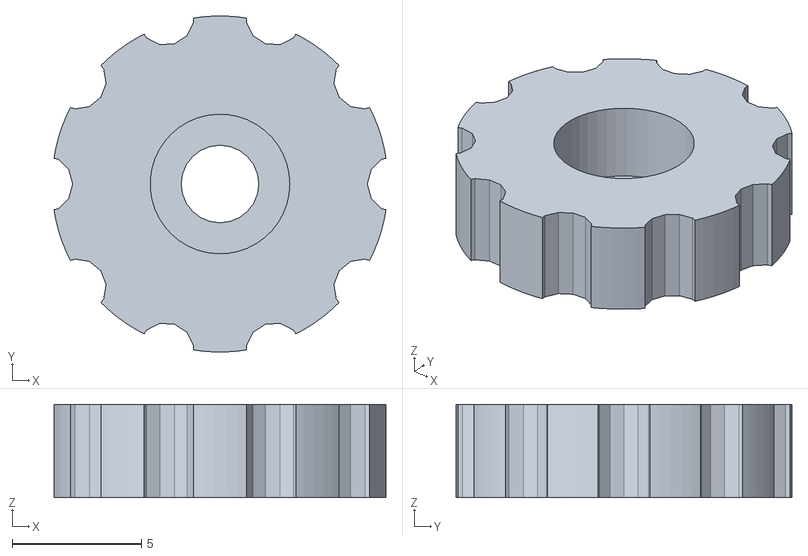
[picture p104: CAD file, 2026-10-24]
cad/stl/upper_carriage-knob.stl
12.8 x 13.0 x 3.60
