sankao/robothector/cad/stl/upper_carriage-speaker_ring.stl

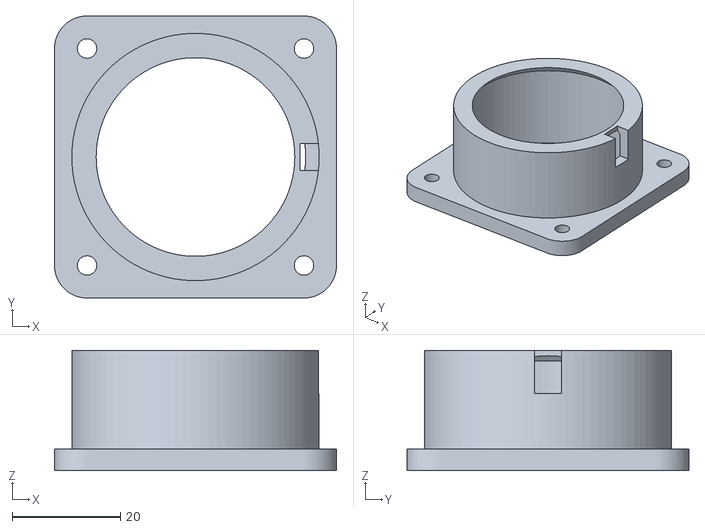
[picture p105: CAD file, 2026-10-24]
cad/stl/upper_carriage-speaker_ring.stl
52.0 x 52.0 x 22.2
