sankao/robothector/cad/stl/rod_jig-base.stl

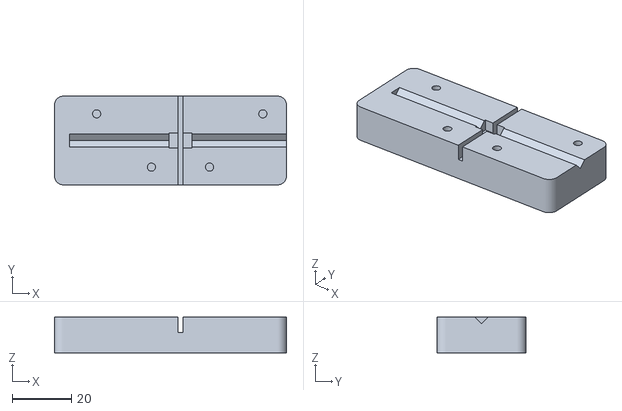
[picture p106: CAD file, 2026-10-24]
cad/stl/rod_jig-base.stl
78.4 x 30.0 x 12.0
