sankao/robothector/cad/stl/upper_carriage-rear_stop.stl

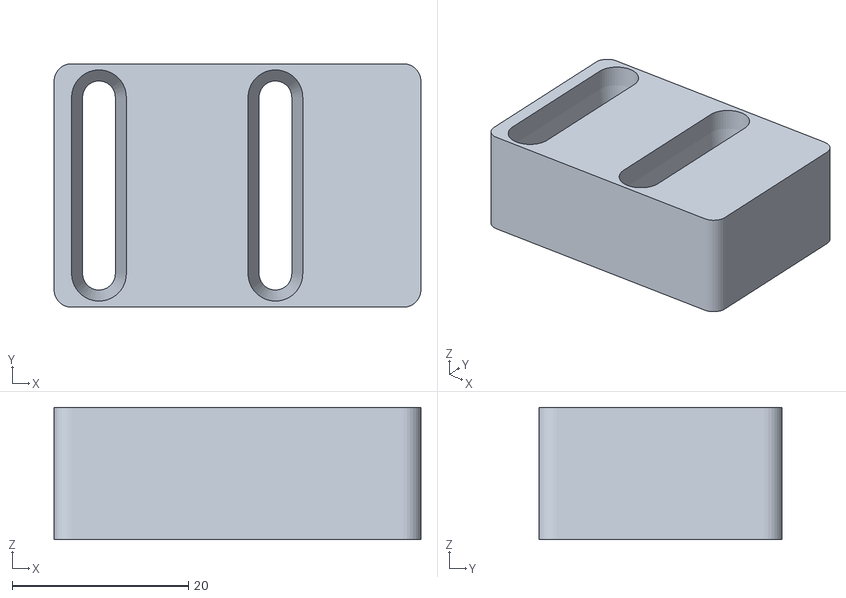
[picture p107: CAD file, 2026-10-24]
cad/stl/upper_carriage-rear_stop.stl
41.6 x 27.6 x 15.0
