sankao/robothector/cad/stl/cabin-camera_cradle.stl

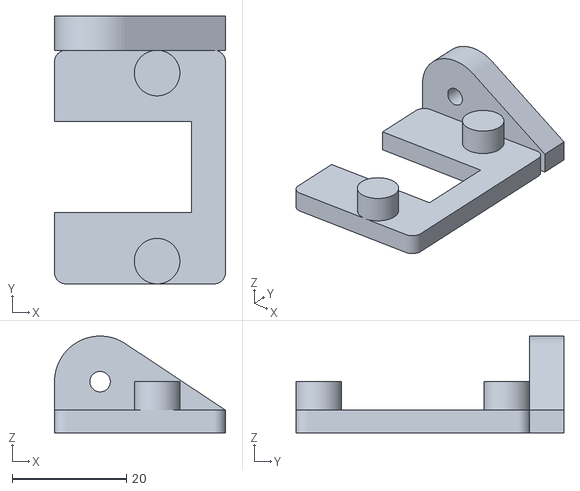
[picture p108: CAD file, 2026-10-24]
cad/stl/cabin-camera_cradle.stl
30.0 x 47.0 x 17.0
