sankao/robothector/cad/stl/upper_carriage-pd_plate.stl

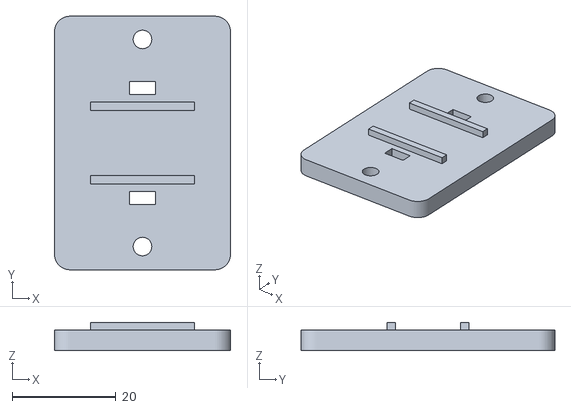
[picture p109: CAD file, 2026-10-24]
cad/stl/upper_carriage-pd_plate.stl
34.0 x 49.0 x 5.50
