sankao/robothector/cad/stl/cabin-camera_bracket.stl

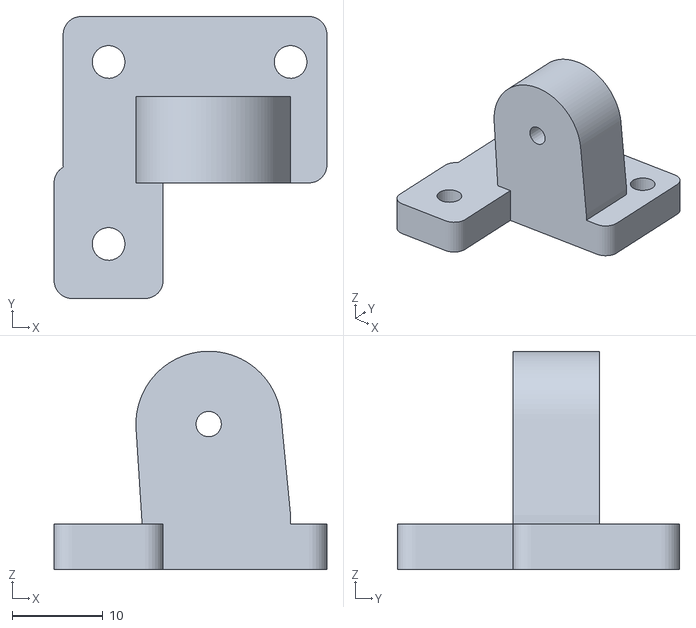
[picture p110: CAD file, 2026-10-24]
cad/stl/cabin-camera_bracket.stl
30.0 x 31.0 x 24.0
