sankao/robothector/cad/stl/rod_jig-plate.stl

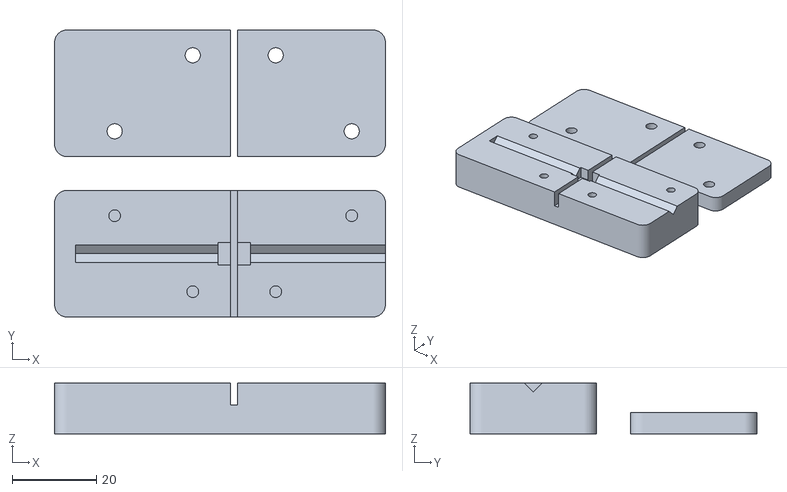
[picture p111: CAD file, 2026-10-22]
cad/stl/rod_jig-plate.stl
78.4 x 68.0 x 12.0
