sankao/robothector/cad/stl/cabin-screen_retainer.stl

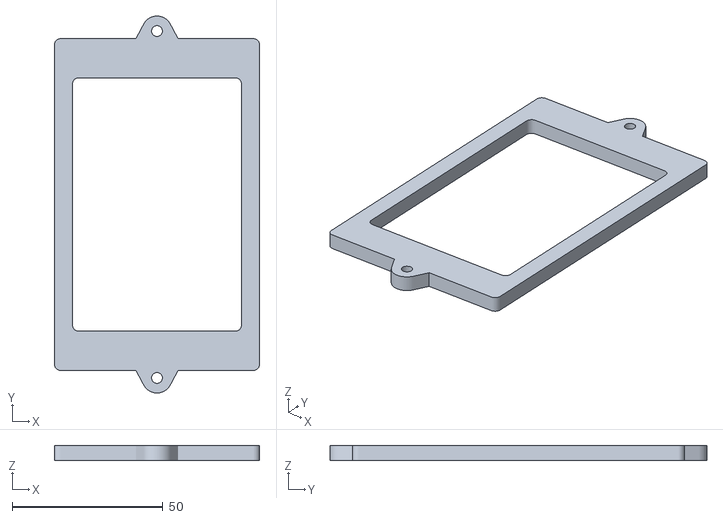
[picture p112: CAD file, 2026-10-17]
cad/stl/cabin-screen_retainer.stl
68.0 x 125.0 x 5.00
