sankao/robothector/cad/stl/fit_test-dovetail.stl

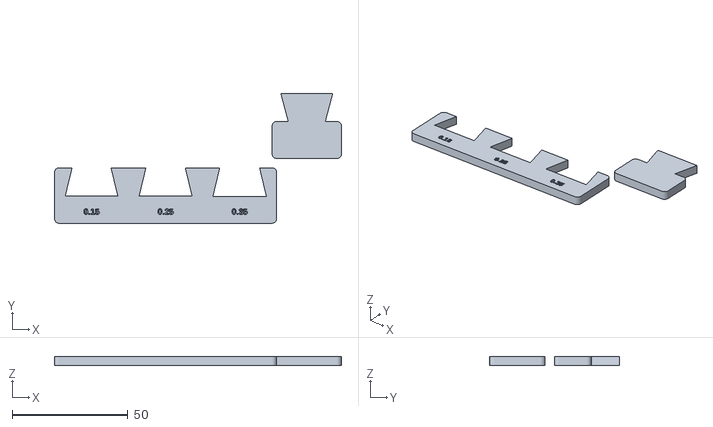
[picture p113: CAD file, 2026-10-17]
cad/stl/fit_test-dovetail.stl
124.0 x 56.0 x 4.00
