sankao/robothector/cad/stl/fit_test-holes.stl

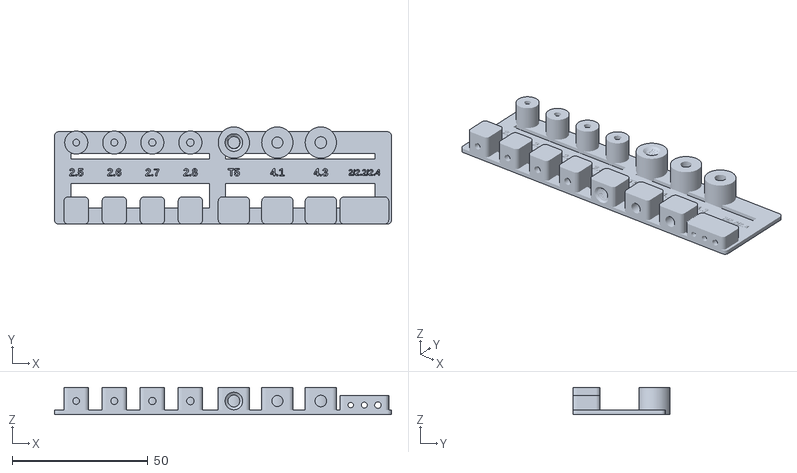
[picture p114: CAD file, 2026-10-17]
cad/stl/fit_test-holes.stl
124.0 x 35.7 x 10.0
