sankao/robothector/(list of files, cad)

Other CAD files:
cad/stl/lower_carriage-tt_clamp.stl
cad/stl/cabin-faceplate.stl
cad/3mf/02-upper_carriage-tray_0.30mm.3mf
cad/3mf/01-cabin-body_0.30mm.3mf
cad/stl/upper_carriage-lid.stl
cad/stl/lower_carriage-frame.stl
cad/stl/fit_test-coupon.stl
