sankao/robothector/cad/preview/assembly/exploded_iso.png

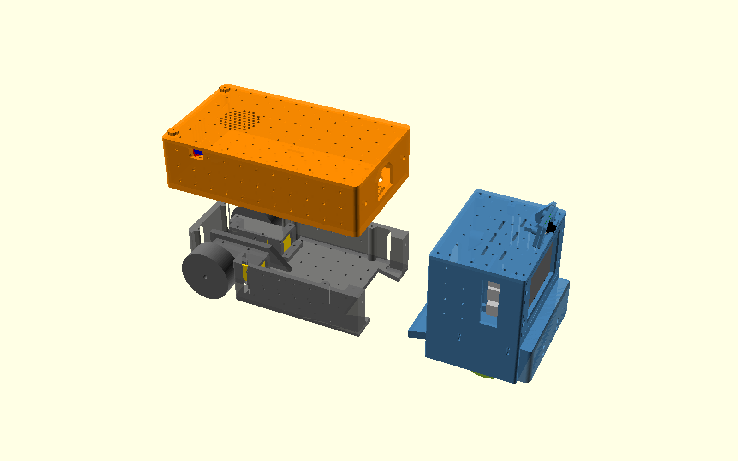
cad/preview/assembly/exploded_iso.png
