sankao/robothector/cad/preview/assembly/rear_iso.png

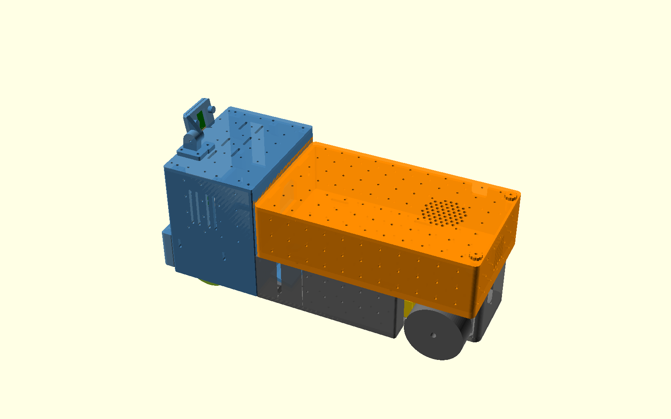
cad/preview/assembly/rear_iso.png
