sankao/robothector/cad/preview/assembly/side.png

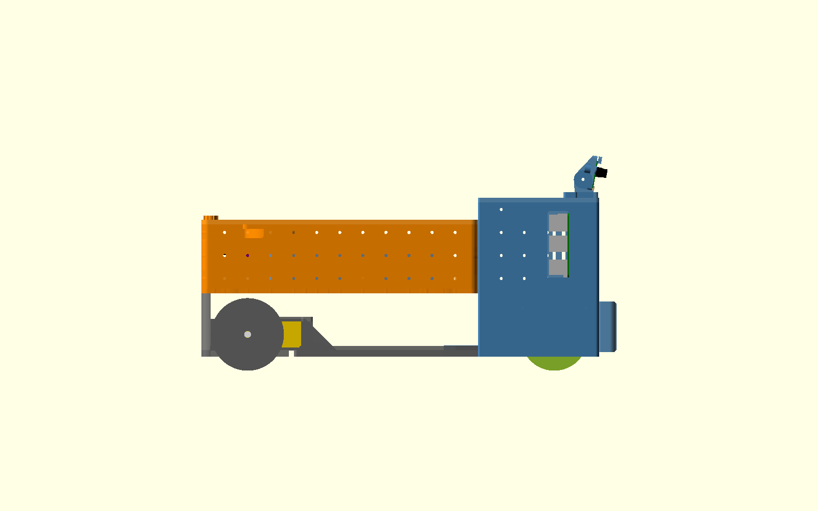
cad/preview/assembly/side.png
