sankao/robothector/cad/preview/cabin/assembly/side.png

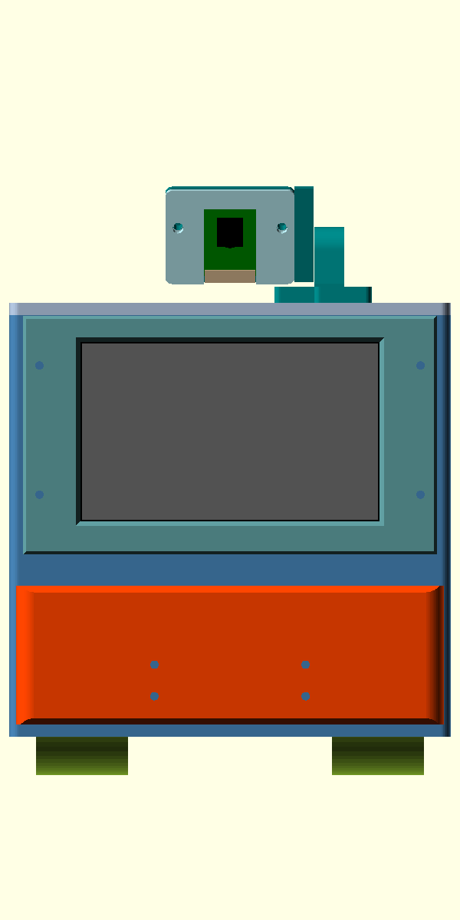
cad/preview/cabin/assembly/side.png
