sankao/robothector/cad/preview/lower_carriage/assembled_iso.png

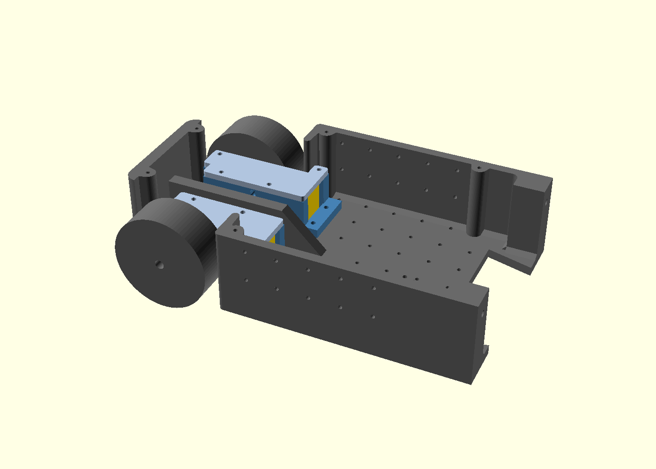
cad/preview/lower_carriage/assembled_iso.png
