sankao/robothector/cad/preview/manual/bank.png

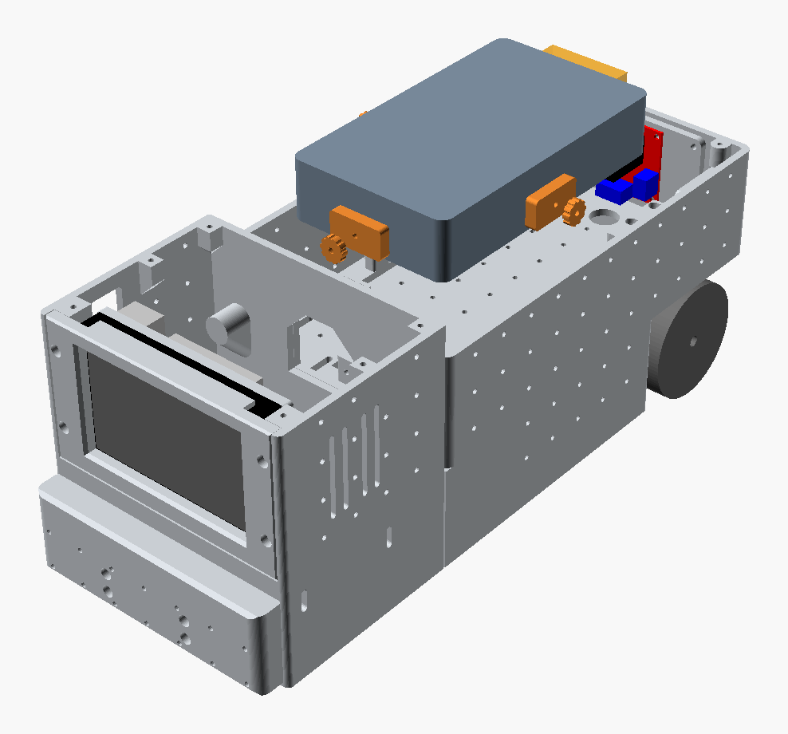
cad/preview/manual/bank.png
