sankao/robothector/cad/preview/manual/bumper.png

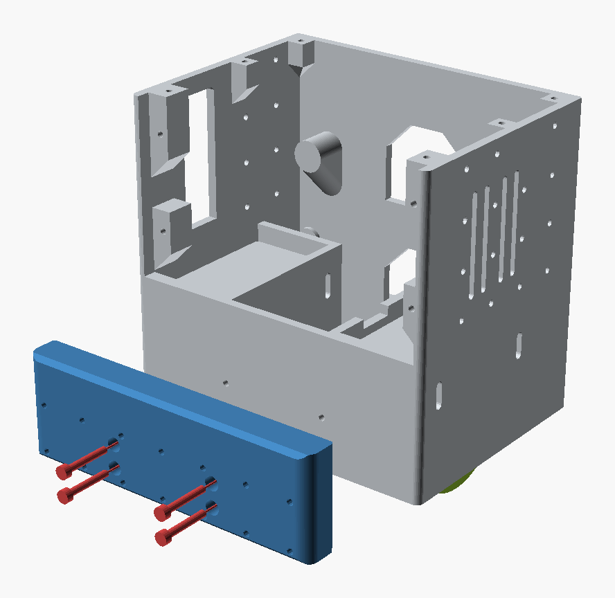
cad/preview/manual/bumper.png
