sankao/robothector/cad/preview/manual/cassette.png

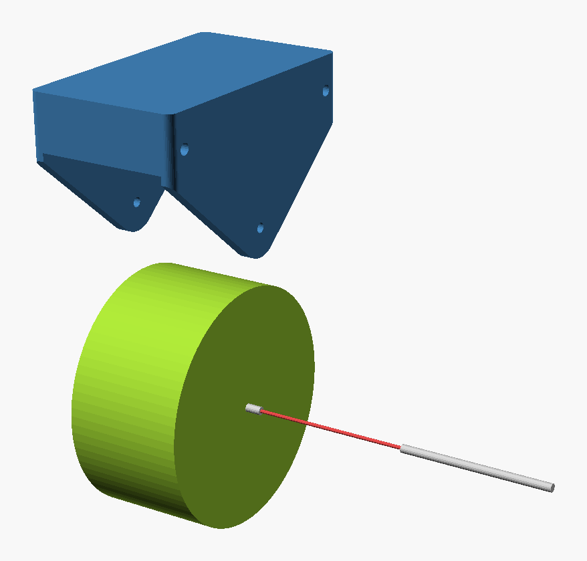
cad/preview/manual/cassette.png
