sankao/robothector/cad/preview/manual/cassettes_in.png

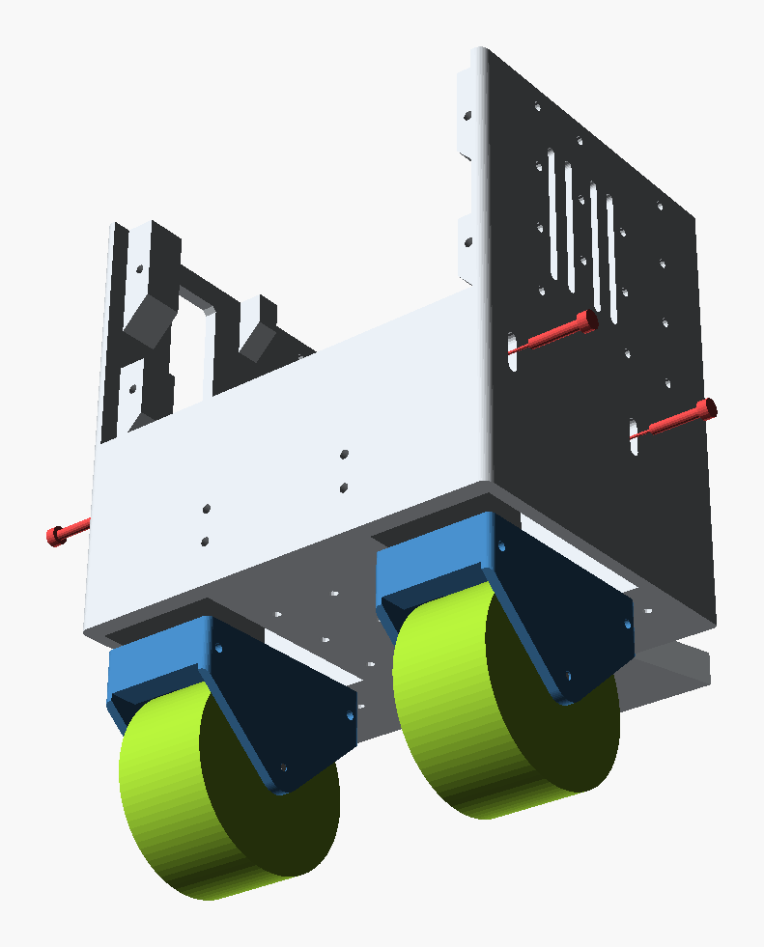
cad/preview/manual/cassettes_in.png
