sankao/robothector/cad/preview/manual/clamps_on.png

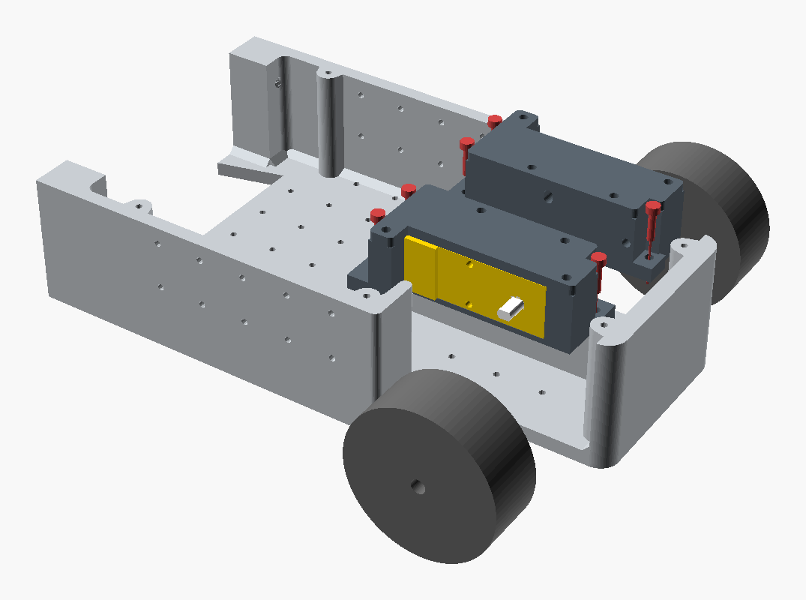
cad/preview/manual/clamps_on.png
