sankao/robothector/cad/preview/manual/faceplate_on.png

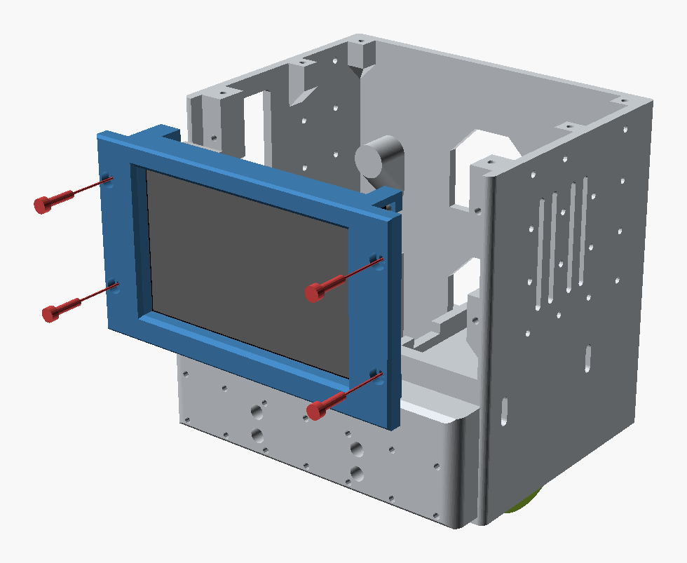
cad/preview/manual/faceplate_on.png
