sankao/robothector/cad/preview/manual/hero.png

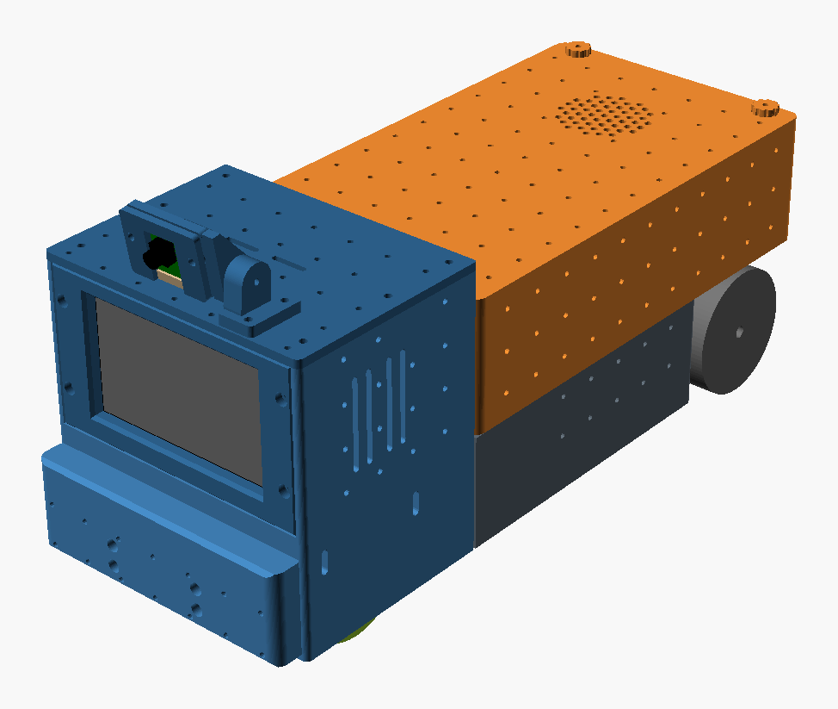
cad/preview/manual/hero.png
