sankao/robothector/cad/preview/manual/j1.png

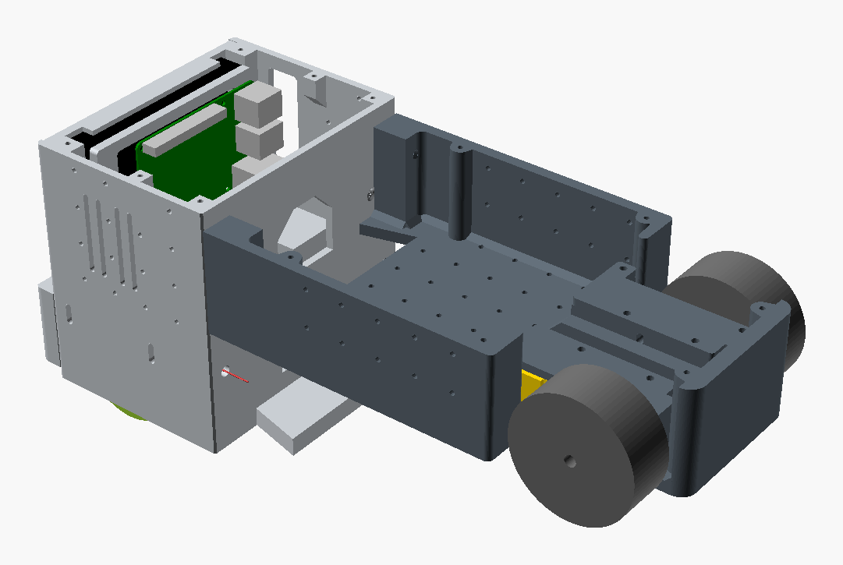
cad/preview/manual/j1.png
