sankao/robothector/cad/preview/manual/lid.png

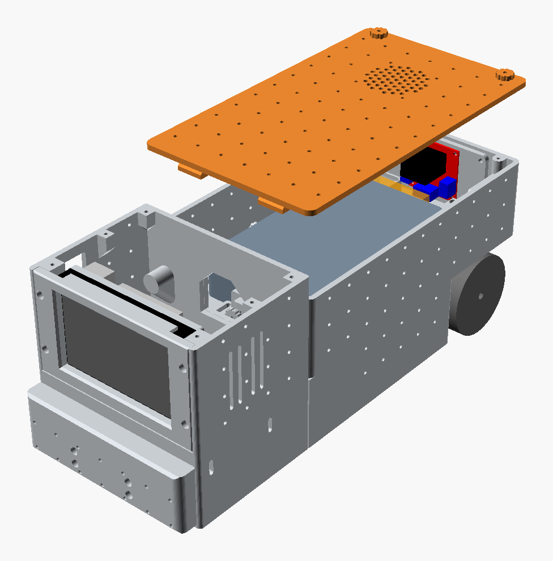
cad/preview/manual/lid.png
