sankao/robothector/cad/preview/manual/motor_clamp.png

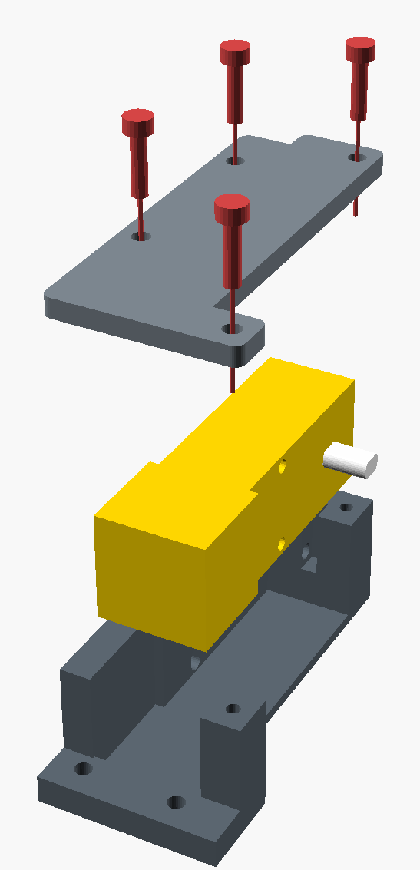
cad/preview/manual/motor_clamp.png
