sankao/robothector/cad/preview/manual/roof.png

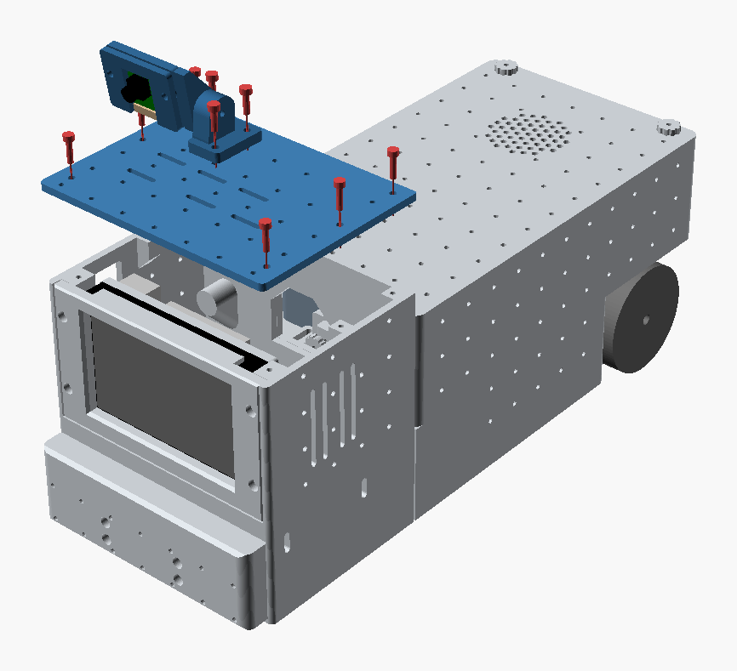
cad/preview/manual/roof.png
