sankao/robothector/cad/preview/manual/screen.png

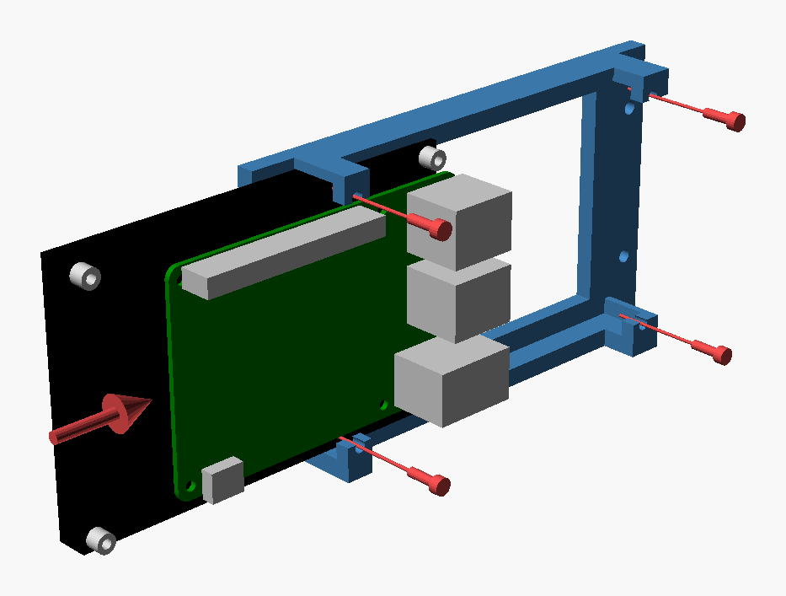
cad/preview/manual/screen.png
