sankao/robothector/cad/preview/manual/tray_fitout.png

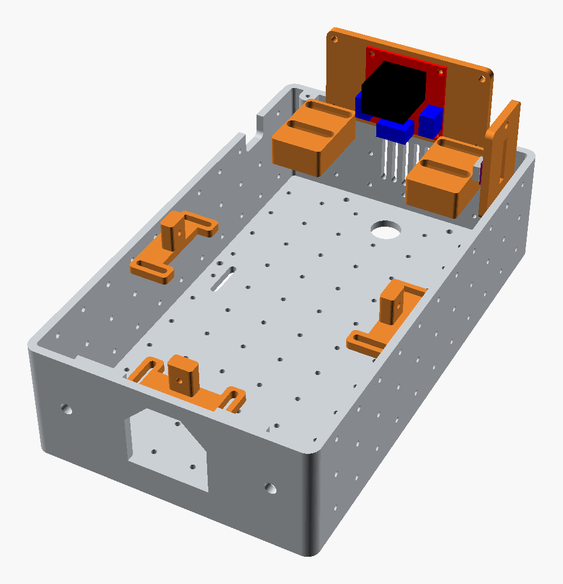
cad/preview/manual/tray_fitout.png
