sankao/robothector/cad/preview/manual/tray_on.png

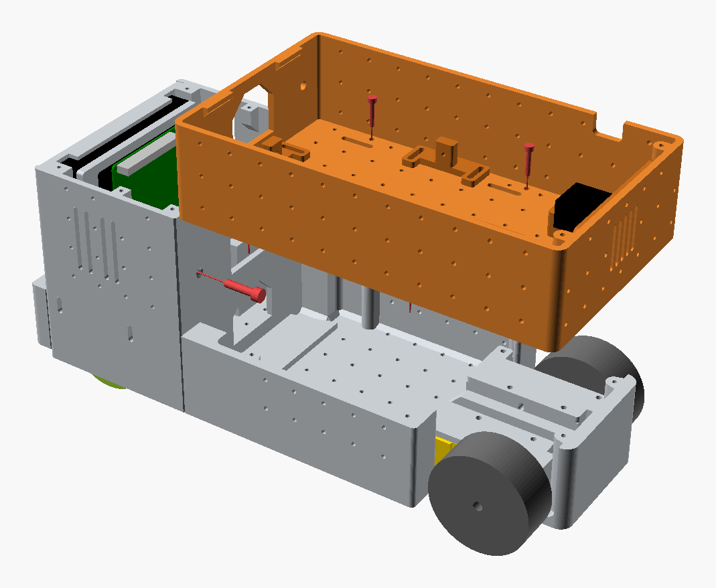
cad/preview/manual/tray_on.png
