sankao/robothector/cad/preview/rod_jig/assembled.png

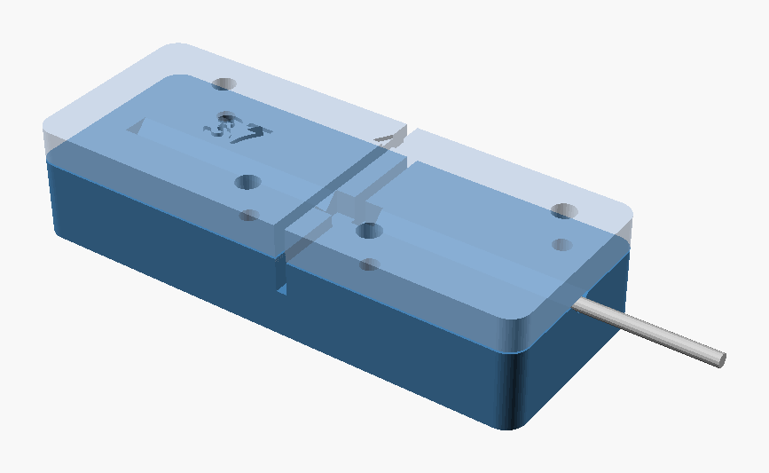
cad/preview/rod_jig/assembled.png
