sankao/robothector/cad/preview/upper_carriage/assembled/side.png

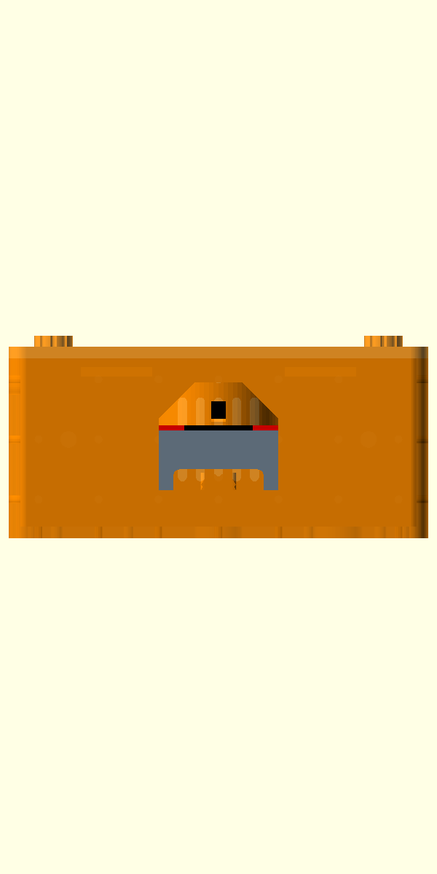
cad/preview/upper_carriage/assembled/side.png
