sankao/robothector/cad/preview/upper_carriage/assembled/top.png

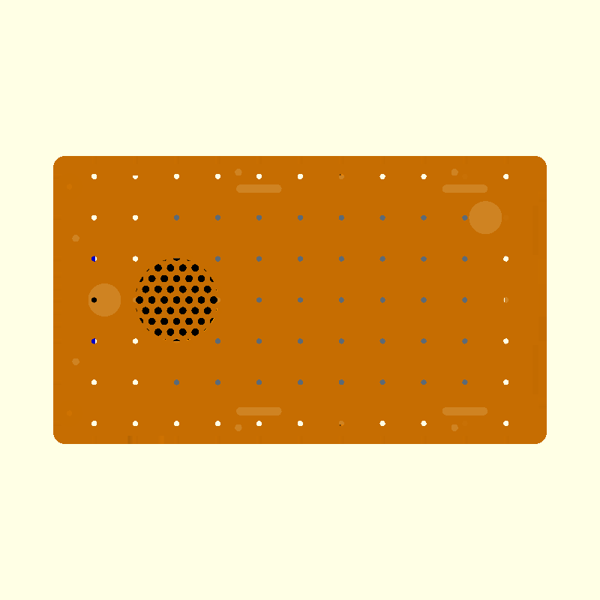
cad/preview/upper_carriage/assembled/top.png
