sankao/robothector/docs/diagrams/wiring.pdf

# robothector — wiring (current build + planned audio)

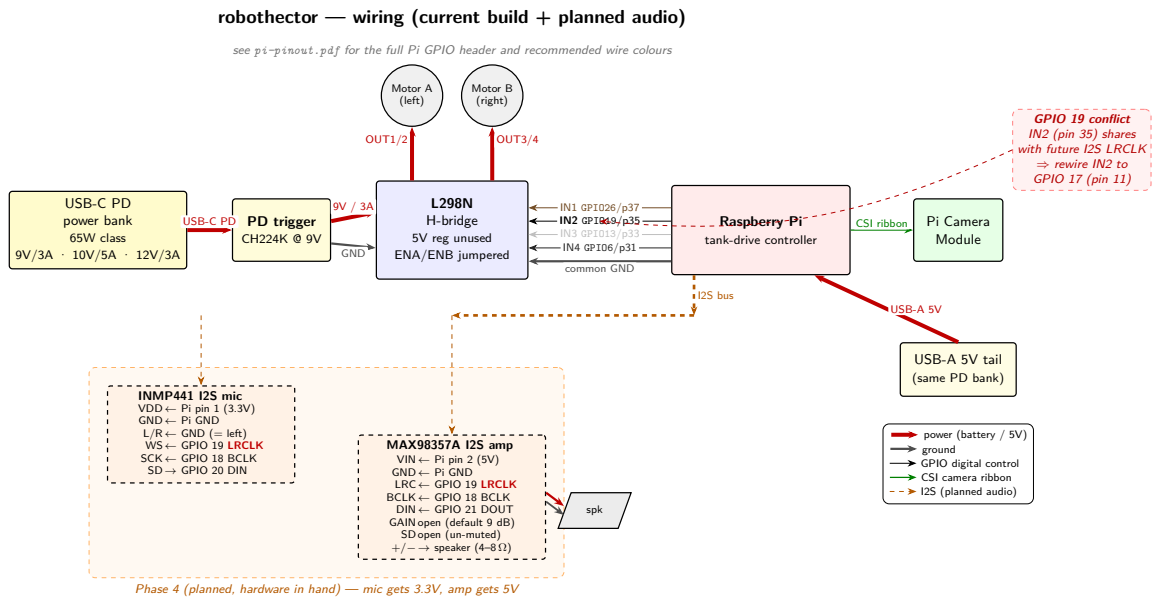
[picture p137: page 1]
USB-C PD power bank 65W class 9V/3A · 10V/5A · 12V/3A; PD trigger CH224K @ 9V; Pi Camera Module; Motor A (left); Motor B (right); spk; USB-C PD; GND; USB-A 5V; OUT1/2; OUT3/4; common GND; IN1 GPIO26/p37 IN2 GPIO19/p35 IN3 GPIO13/p33 IN4 GPIO6/p31; CSI ribbon; I2S bus

see pi-pinout.pdf for the full Pi GPIO header and recommended wire colours

GPIO 19 conflict
IN2 (pin 35) shares
with future I2S LRCLK
⇒ rewire IN2 to
GPIO 17 (pin 11)

H-bridge
5V reg unused
ENA/ENB jumpered

Raspberry Pi
tank-drive controller

USB-A 5V tail
(same PD bank)

INMP441 I2S mic
VDD← Pi pin 1 (3.3V)
GND← Pi GND
L/R← GND (= left)
WS← GPIO 19 LRCLK
SCK← GPIO 18 BCLK
SD→ GPIO 20 DIN

power (battery / 5V)
ground
GPIO digital control
CSI camera ribbon
I2S (planned audio)

MAX98357A I2S amp
VIN← Pi pin 2 (5V)
LRC← GPIO 19 LRCLK
BCLK← GPIO 18 BCLK
DIN← GPIO 21 DOUT
GAIN open (default 9 dB)
SD open (un-muted)
+/−→ speaker (4–8 Ω)

Phase 4 (planned, hardware in hand) — mic gets 3.3V, amp gets 5V
