sankao/robothector/(commit log)

2021-11-13 added button code
2025-02-23 adde motor controller doc + pinout doc
2025-02-23 added webapp to access camera
2026-02-19 Restructure to client/server architecture
    - Remove legacy monolithic code: joystick.py, webapp/, test scripts,
    siren WAVs, UI PNGs, and reference PDFs (all in git history)
    - Add server/ package: motors.py (tank drive, arcade mixing, BCM GPIO
    26/19/13/6), sirens.py (pygame.mixer WAV playback)
    - Add client/ package stub
    - Add docs/: protocol.md (WebSocket JSON spec), steamdeck-env.md
    - Add pyproject.toml with uv, pinout.md with Mermaid wiring diagram
    - Add .beads/ task tracking (33 issues across 5 phases)
    - Add .gitignore for __pycache__ and .venv
    - Update CLAUDE.md with current architecture and SSH access
    [motors.py, sirens.py]
2026-02-20 Implement full client/server architecture with video streaming
    Server: WebSocket control (drive/mode/ping), MJPEG camera streaming,
    UDP beacon discovery, dead-man's switch safety (500ms motor stop, 5s
    safe mode), unified main entry point with --no-camera/--no-motors flags,
    systemd service unit.
    Client: pygame app with joystick input (deadzone, mode toggles),
    threaded WebSocket sender with auto-reconnect and discovery fallback,
    MJPEG stream decoder, HUD overlay (connection status, mode, joystick
    indicator), fullscreen toggle.
    Also adds hardware diagnostic script and connection test script.
2026-02-20 Update pinout doc: 2S battery, full GPIO header, audio planning
    Fix battery from 12V to 2S LiPo (7.4V). Add full 40-pin GPIO header
    diagram showing current motor pins and planned I2S audio pins. Document
    GPIO 19 conflict between motor IN2 and I2S LRCLK. Add available GPIO
    table and power section.
2026-02-21 Add motor test script, fix WebSocket zombie connections
    New connection now kicks the previous client instead of rejecting,
    fixing zombie connections that blocked reconnects. Add standalone
    motor_test.py for hardware debugging with configurable step duration.
    [control.py, motor_test.py]
2026-02-21 Update CLAUDE.md and audio task planning
    Rewrite CLAUDE.md with current project state, Pi setup gotchas,
    and deployment instructions. Update Phase 4 audio tasks with
    I2S hardware specifics (INMP441/ICS43434 + MAX98357A).
2026-02-21 Add audio design doc and update beads tasks with research findings
    Created docs/audio-design.md covering I2S overlay config, ALSA setup,
    sounddevice library choice, raw PCM/UDP transport, latency budget, and
    GPIO 17 pin selection for motor IN2 rewire. Updated existing audio tasks
    with implementation specifics and created 3 new tasks (deps, Pi receiver,
    protocol docs).
2026-05-09 docs: add wiring diagram (TikZ source + PDF + SVG)
    Block diagram of the current build plus planned I2S audio:
    - power chain: USB-C PD bank -> CH224K trigger @ 9V -> L298N -> motors
    - USB-A 5V tail from same bank -> Pi
    - control signals Pi -> L298N (4 GPIOs, IN1-IN4) with wire colours
    - GPIO 19 conflict callout (motor IN2 vs future I2S LRCLK)
    - I2S bus to INMP441 mic + MAX98357A amp (Phase 4, hardware in hand)
    Source: docs/diagrams/wiring.tex (tectonic + standalone TikZ).
2026-05-09 docs/wiring: expand audio modules with full pin-level wiring
    Each I2S module now shows its pinout inline:
    - INMP441 mic: VDD/GND/L-R/WS/SCK/SD with destination GPIOs
    - MAX98357A amp: VIN/GND/LRC/BCLK/DIN/GAIN/SD/+-/- with destinations
    - shared GPIO 19 LRCLK highlighted in red on both
    - 4-8 ohm speaker symbol added at amp output
2026-05-09 docs/diagrams: add Pi GPIO pinout + wire-colour reference
    New companion diagram pi-pinout.{tex,pdf,svg} showing:
    - Full 40-pin Pi GPIO header (top-down view)
    - Each used pin colour-coded by status (current motor, planned audio,
    conflict, power, ground, free)
    - Callouts on each used/planned pin with recommended Dupont colour
    - Three reference tables: pin-status legend, full Dupont colour map,
    Pi-pin-to-destination connection table
    Recommended wire colours (using stock Dupont kit):
    - red 3.3V / orange 5V / black GND
    - yellow BCLK / green LRCLK / blue mic-data / purple amp-data
    - brown IN1 / black IN2 / white IN3 / gray IN4 (matches existing motor wiring)
    wiring.tex updated to cross-ref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
2026-05-09 docs/diagrams: enlarge Pi GPIO pinout for readability
    Previous render had 4mm pin circles with scriptsize labels — looked
    empty at normal zoom. Now:
    - 11mm pin circles (was 4mm)
    - normalsize bold pin numbers inside circles (was tiny)
    - 10mm row pitch (was 4.7mm)
    - 18mm column gap (was 8mm)
    - footnotesize callouts with 6x3mm colour swatches
    - light green!3 frame instead of green!8 fill so pins dominate
    All 40 pins now legible at 100% zoom.
2026-05-09 docs/diagrams: fix function labels overlapping the header frame
    Function labels (GPIO 4 etc.) sat at xshift=2mm from the pin edge,
    but the fit rectangle had inner sep=4mm so the labels' rightmost
    characters fell inside the green frame's stroke.
    Push labels to xshift=6mm and tighten frame inner sep to 2mm so the
    labels are entirely clear of the rectangle.
2026-05-09 docs/diagrams: confirm IN2 rewire target = GPIO 17 (pin 11), not GPIO 16
    Annotate the pinout diagram with the future IN2 destination on
    pin 11, and explain in footnotes why GPIO 16 (the physically-closest
    free pin) is NOT an option:
    GPIO 16 is claimed by the googlevoicehat-soundcard I2S overlay
    for the MAX98357A's SD_MODE pin. Driving it from userspace as a
    motor control would fight the audio stack.
    This matches the original audio-design.md analysis. Wiring diagram
    also updated to reference pin 11 in the conflict callout.
2026-05-09 STATUS.md: refresh to reflect Phase 0-3 complete, Phase 4 pending
    Previous STATUS.md was written when Phase 0 was current and described
    the codebase as a monolithic single-file prototype. Phases 0-3 have
    since shipped (modular client/server with WS+JSON protocol, MJPEG video,
    discovery, dead-man's switch, systemd unit on Pi).
    Refresh covers:
    - Phase progress table (0-3 done, 4 in progress)
    - Current modular file layout with line counts and roles
    - Hardware list updated (PD power bank decision, audio modules in hand)
    - GPIO 19 conflict resolution = move IN2 to GPIO 17 (not GPIO 16)
    - Remaining Phase 4 work: hardware steps + ~600 lines of audio code
    - Pointer to wiring + pi-pinout diagrams as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
2026-05-09 Phase 4a+4b: protocol module, audio packet format, jitter buffer + 75 tests
    Foundation for the audio implementation. All zero-hardware code, fully
    unit-tested. Ready to layer audio I/O and the actual capture/playback
    threads on top.
    protocol/ — new shared package, no platform deps:
    - messages.py: typed dataclasses for all WS messages, including new
    AudioListenMessage and AudioTalkMessage. Validates axis range,
    rejects unknown modes, ignores unknown fields for fwd-compat.
    - audio_packet.py: 12-byte BE header + S16_LE mono PCM payload, with
    to_bytes/from_bytes round-trip.
    - jitter_buffer.py: reorder + silence-fill on loss, target/max depth
    configurable, stats tracking.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
    [control.py]
2026-05-09 Phase 4c+4d+4e: audio I/O abstraction, engine, server.audio, client.audio
    protocol/audio_io.py: AudioSource / AudioSink ABCs with FakeAudioSource
    and FakeAudioSink for tests, plus SoundDeviceSource and SoundDeviceSink
    real impls (lazy-imported so non-audio code keeps importing cleanly on
    machines without PortAudio). 13 tests covering fake behaviour + the
    sounddevice-missing-deps error path.
    protocol/audio_engine.py: AudioStreamSender (mic -> UDP) and
    AudioStreamReceiver (UDP -> speaker via JitterBuffer). Both are
    threaded daemons with injectable sockets/sources/sinks. Factored out
    of server.audio so client.audio can compose the same primitives
    without duplicating ~100 lines.
    server/audio.p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
    [audio.py]
2026-05-09 Phase 4f: end-to-end loopback test passes — full audio plane works
    tests/test_loopback_e2e.py: spawns AudioServer + AudioClient in the
    same process with FakeAudio* on both sides + ephemeral loopback UDP
    sockets. 6 tests, all passing:
    - server-mic -> operator-speaker direction works (PCM survives the
    round trip with correct sequence, no corruption)
    - operator-mic -> robot-amp direction works (mirror)
    - bidirectional simultaneous: both directions concurrent, no
    crosstalk between the two streams
    - first-chunk-arrives-within-300ms latency target on loopback
    - clean shutdown is idempotent (double-stop calls don't crash)
    - payload integrity over 50 chunks: every received chu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
2026-05-09 Phase 4g: wire PTT/listen to gamepad + audio HUD icons
    client/joystick.py:
    - A (button 0) = push-to-talk: held = transmit, released = silent
    - Y (button 3) = listen toggle: press to start hearing the robot
    - L1/R1 sirens unchanged
    - get_input() now returns listen + talk state alongside axes/mode
    - JOYBUTTONUP handled (needed for PTT release)
    - Hot-unplug drops PTT for safety
    client/network.py:
    - send_audio_listen(enabled) / send_audio_talk(enabled) -> WS
    client/main.py:
    - Builds an AudioClient at startup with SoundDevice* if available,
    falls back to FakeAudio* on machines without PortAudio (so the
    client still runs on a dev laptop with no audio plumbing).
    - --no-a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
2026-05-09 server/main.py: instantiate AudioServer with sounddevice fallback to fakes
    The Pi-side server now actually starts the audio plane on boot. With
    the I2S overlay enabled and INMP441/MAX98357A wired, this picks them
    up automatically. Without the overlay, sounddevice fails to open a
    device — _make_audio_server() catches that and falls back to
    FakeAudioSource/FakeAudioSink, so:
    - audio_listen / audio_talk WS messages are still acknowledged
    - no PCM flows (the fakes drop everything)
    - server keeps running normally
    This means the same server binary runs on a Pi pre- and post-hardware
    bringup. After 4z (I2S wiring + overlay), no code changes — just
    reboot and audio starts working.
    Added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
    [main.py]
2026-10-17 cad: parametric OpenSCAD chassis (cabin, upper and lower carriage)
    Redo the truck body as a 3-part parametric OpenSCAD project:
    - cabin: Pi 4 + Waveshare 4.3" DSI on a removable faceplate, Camera
    Module 3 on a tilting roof bracket, 58 mm omni-wheels in printed
    cassettes on 2 mm rods, front bumper
    - upper carriage: USB-C power bank bay with set-screw/pusher clamps for
    any bank up to 155x90x32 (replaces the 18650 holder and BMS), L298N
    on the rear wall, PD trigger plate, speaker in the lid
    - lower carriage: frame with dovetail joint to the cabin, 2 TT motor
    clamps, rear wall as bumper
    robothector_base.scad holds every shared dimension, joint coordinate and
    hole size; parts use 20 mm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
2026-10-17 cad: add PrusaSlicer 3MF print plates
    Nine model-only plates in cad/3mf/: each part its own object, oriented
    and packed on the MK3S+ bed, named with the layer profile to use
    (0.30mm DRAFT for the big parts and the fit coupon, 0.20mm SPEED for
    small parts). tools/make_3mf.py builds them; --check slices each in
    Generic PETG (4 perimeters, 15% gyroid, no supports): about 73.5 h and
    1.36 kg in total, nothing off the bed or overlapping.
    The plates carry no embedded settings: PrusaSlicer 2.9.6's CLI does not
    write them, and a hand-embedded config crashed its 3MF loader on
    wipe_tower_extruder.
2026-10-17 cad: apply fit-coupon results (PETG, MK3S+)
    Coupon results: M3 pilot 2.8 in both orientations; the printed M5 thread
    works in both orientations (4.1/4.3 pilots too tight), so the horizontal
    J1/J3 holes now use printed threads; 2 mm rod hole 2.4; the dovetail at
    0.15 was slightly loose, so J1 gets its own 0.10 clearance
    (J1_dovetail_clr). Holes print about 0.2-0.4 mm small, so the M3/M5
    clearance holes open to 3.6/5.7 (inferred, not tested on the coupon).
    All 23 parts and 9 plates regenerated. Checks: all parts manifold and on
    the bed, J1/J2/J3 bolt probes clear (negative control hits), no
    cabin/frame overlap with the tighter dovetail, bank clamp still solves
    every size from 100x60 to 155x90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
2026-10-17 cad: mouse ears on the big PETG parts
    The tray, lid, lower-carriage frame and cabin body get 2-layer, 24 mm
    discs fused to their footprint corners, against corner lift. They are
    added only in print orientation (cut off after printing) and can be
    switched off per part with -D ears=false. On the 240 mm parts the ears
    are pulled in at the ends (at most 2.5 mm overhang, 244.8 mm overall) so
    they still fit the 250 mm bed, and reach outward sideways instead.
    Slicing confirms the ears land in layers 1-2 only. Plates 01-04
    regenerated; each gains 5-10 min.
2026-10-18 cad: screen mounting exploded views + README pointer
2026-10-22 cad/manual: assembly-manual renders
    parts.scad + export_parts.sh write every printed sub-part in its
    assembled position to manual/stl/ (git-ignored); steps.scad builds one
    scene per assembly step from those meshes (fitted parts grey, new parts
    in their assembly colour, screws as red glyphs on their insertion
    lines); render.sh renders and trims them into preview/manual/. These are
    the pictures in the Robothector Assembly Manual slide deck.
2026-10-22 cad: rod cutting jig for the 2 mm omni-wheel axles (plate 09)
    rod_jig.scad: a V-groove base with a fixed stop and a lid, which prints
    as two halves, clamps the rod on both sides of a cut slot. The slot is
    the disc thickness (disc_t, default 1.1) plus 0.3 mm per side, placed so
    the piece is jig_len +/- 0.3 mm (37 by default) wherever the disc runs
    in it. The base is relieved around the cut so the hot steel does not sit
    on PETG. Added to export_all.sh and make_3mf.py as plate 09 (1 h 54,
    25 g, no supports); usage is in the README.
2026-10-24 cad: corner-lip faceplate (v2) replaces the screen retainer
    Measured the Waveshare 4.3" DSI stack: board back 8.5 mm behind the
    glass (Waveshare's 14.05 mm "overall thickness" includes the Pi), fixed
    M2.5 corner standoffs and Pi pillars both 4 mm. The v1 retainer could
    not fit between board and Pi, and its faceplate pegs blocked the USB
    ports.
    - Faceplate: pegs removed; the long-side rails run out to the corners
    and overhang the screen's standoffs with 4 mm lips (M2.5x8 fills the
    4 mm standoff and stops at the board). The screen slides in end-on,
    USB end first, to two -Y stops; lips start 2 mm beyond the Pi's long
    edges so its ports pass under them.
    - Breakaway support combs under t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
2026-10-24 cad: drop the obsolete screen retainer STL
2026-10-24 cad: slot the TT clamp wall for a double-shaft motor's inner stub
    The TT gearmotors in hand have the D shaft out of both faces; the
    vitamin only modelled the outer stub, so nothing caught the inner stub
    landing in the clamp's 8.5 mm inboard wall (motor could not seat).
    - vitamins: TT shaft runs through the gearbox, TT_shaft_in_len = 9.1
    (0 for single-shaft motors).
    - clamp: slot of shaft d + 2 through the inboard wall at the axle, open
    at the top so the motor still drops in; the wall cap screw moves from
    X -205 to -209 to keep 1.5 mm of plastic beside the slot (caps follow).
    - asserts for cap screws vs the slot and the stub vs the spine.
    - Checked: clamp vs motor empty with the slot,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
